Nick1787/Narwhal-Arduino-Code/Electrical/HarnessInstallationInstructions/IMGP3784_resize.JPG

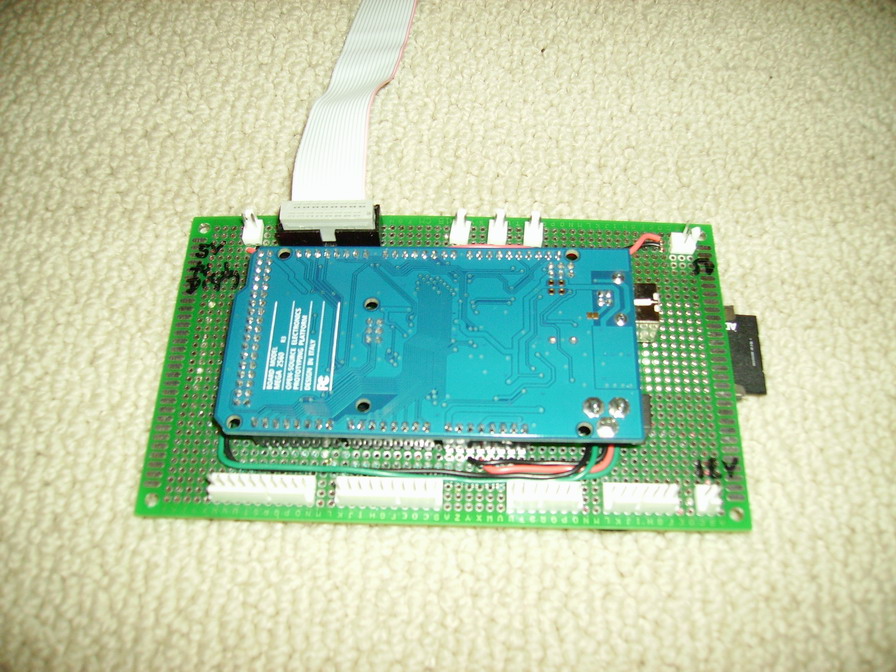
Electrical/HarnessInstallationInstructions/IMGP3784_resize.JPG
