Nick1787/Narwhal-Arduino-Code/Electrical/HarnessInstallationInstructions/IMGP3785_resize.JPG

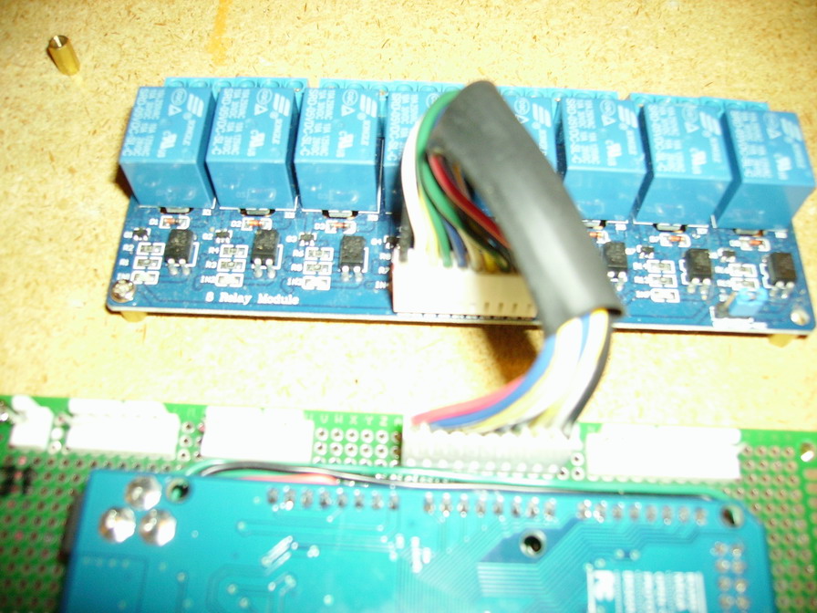
Electrical/HarnessInstallationInstructions/IMGP3785_resize.JPG
