Nick1787/Narwhal-Arduino-Code/Requirements/Process.xlsx

 | Acronym | Definition
 | HX | Heat Exchanger
 | HLT | Hot Liquor Tank
 | MLT | Mash/Lauter Tun
 | BK | Boil Kettle
 | HERMS | Heat Exchange Recirculating Mash System
 | HLTBP | Hot Liquor Tank Body Probe (RTD in body of HLT)
 | HLTOP | Hot Liquor Tank Outlet Probe (RTD located after HLT outlet valve)
 | MLTBP | Mash/Lauter Tun Body Probe (RTD in body of MLT)
 | MLTOP | Mash/Lauter Tun Outlet Probe (RTD located after MLT outlet valve)
 | BKBP | Brew Kettle Probe (RTD in body of BK)
 | BKOP | Brew Kettle Probe (RTD located after BK outlet valve)
No. | Process | Sub-process | Sub-sub-process | HLT Temperature Feedback, Setpoint | MLT Temperature Feedback, Setpoint | BK Temperature Feedback, Setpoint | Pump between HLT and MLT | Pump between MLT and BK | Timer | Overall Timer - Real time capture of session | Notes
1 | Clean
2 | Mash | Dough In | Add false bottom to MLT | OFF | OFF | OFF | OFF | OFF | OFF | ON
 |  |  | Add HX to HLT | OFF | OFF | OFF | OFF | OFF | OFF | ON | Need to make HX
 |  |  | Add water to HLT and MLT | OFF | OFF | OFF | OFF | OFF | OFF | ON
 |  |  | Heat HLT and MLT to dough in temperature | HLTBP, 104F | MLTBP, 104F | OFF | OFF | OFF | OFF | ON
 |  |  | Turn off HLT and MLT temperature control | OFF | OFF | OFF | OFF | OFF | OFF | ON
 |  |  | Add grain to MLT | OFF | OFF | OFF | OFF | OFF | OFF | ON
 |  |  | Add "float" to MLT | OFF | OFF | OFF | OFF | OFF | OFF | ON | Need to make float
 |  |  | Connect appropiate hoses | OFF | OFF | OFF | OFF | OFF | OFF | ON
 |  |  | Turn on pump/HERMs | OFF | OFF | OFF | ON | OFF | OFF | ON
 |  |  | Adjust pump valve for resonable flow that avoids channeling of grain bed in MLT | OFF | OFF | OFF | ON | OFF | OFF | ON
 |  | Acid Rest (optional) | Turn on HLT temperature control and heat to acid rest temperature | MLTOP, 95F | OFF | OFF | ON | OFF | OFF | ON
 |  |  | Hold acid rest temperature for timed duration | MLTOP, 95F | OFF | OFF | ON | OFF | ON, T1 | ON
 |  | Protein Rest (optional) | Turn on HLT temperature control if no acid rest or maintain HLT temperature control and heat to protein rest temperature | MLTOP, 122F | OFF | OFF | ON | OFF | OFF | ON
 |  |  | Hold protein rest temperature for timed duration | MLTOP, 122F | OFF | OFF | ON | OFF | ON, T2 | ON
 |  | Sacchrification Rest 1 | Turn on HLT temperature control if no acid/protein rest or Maintain HLT temperature control and heat to first sacchrification rest temperature | MLTOP, 140-158F | OFF | OFF | ON | OFF | OFF | ON
 |  |  | Hold first sacchrification rest temperature for timed duration | MLTOP, 140-158F | OFF | OFF | ON | OFF | ON, T3 | ON
 |  | Sacchrification Rest 2 (optional) | Maintain HLT temperature control and heat to second sacchrification rest temperature | MLTOP, 140-158F | OFF | OFF | ON | OFF | OFF | ON
 |  |  | Hold second sacchrification rest temperature for timed duration | MLTOP, 140-158F | OFF | OFF | ON | OFF | ON, T4 | ON
 |  | Sacchrification Rest 3 (optional) | Maintain HLT temperature control and heat to third sacchrification rest temperature | MLTOP, 140-158F | OFF | OFF | ON | OFF | OFF | ON
 |  |  | Hold third sacchrification rest temperature for timed duration | MLTOP, 140-158F | OFF | OFF | ON | OFF | ON, T5 | ON
 |  | Mash Out (optional) | Maintain HLT temperature control and heat to mash out temperature | MLTOP, 170F | OFF | OFF | ON | OFF | OFF | ON
 |  |  | Turn off MLT temperature control | OFF | OFF | OFF | ON | OFF | OFF | ON
 |  |  | Turn off pump/HERMs | OFF | OFF | OFF | OFF | OFF | OFF | ON
3 | Lauter | Vorlauf | N/A - not be necessary with HERMS | N/A | N/A | N/A | N/A | N/A | N/A | ON
 |  | Sparge | Move "float" from MLT to BK | OFF | OFF | OFF | OFF | OFF | OFF | ON | Make sure "float" will work in BK and MLK
 |  |  | Add sparge arm to MLT | OFF | OFF | OFF | OFF | OFF | OFF | ON | May need to modify sparge arm for pots
 |  |  | Connect HLT outlet to pump, pump outlet to HX in HLT, and outlet of HLT HX to sparge arm | OFF | OFF | OFF | OFF | OFF | OFF | ON
 |  |  | Connect MLT outlet to pump and pump outlet to float in BK | OFF | OFF | OFF | OFF | OFF | OFF | ON
 |  |  | Turn on pumps | OFF | OFF | OFF | ON | ON | OFF | ON
 |  |  | Turn on HLT temperature control and maintain mash out temperature | MLTOP, 170F | OFF | OFF | ON | ON | OFF | ON
 |  |  | Adjust pump valves to match sparge flow and slow enough for a sparge time of approximately 60 min | MLTOP, 170F | OFF | OFF | ON | ON | ON, T5 | ON
 |  |  | Turn on BK temperature control when wort covers BKBP | MLTOP, 170F | OFF | BKBP, 200F | ON | ON | ON, T5 | ON
 |  |  | Turn off MLT temperature control when sparge water is low | OFF | OFF | BKBP, 200F | ON | ON | ON, T5 | ON
 |  |  | Turn off pumps | OFF | OFF | BKBP, 200F | OFF | OFF | OFF | ON
 |  |  | Remove HX, sparge arm, hoses | OFF | OFF | BKBP, 200F | OFF | OFF | OFF | ON
4 | Boil | Begin Boil | Heat BK to rolling boil | OFF | OFF | BKBP, 20xF | OFF | OFF | OFF | ON
 |  |  | Take gravity reading and add water as necessary | OFF | OFF | BKBP, 20xF | OFF | OFF | OFF | ON
 |  |  | Hold rolling for timed duration | OFF | OFF | BKBP, 20xF | OFF | OFF | ON, T6 | ON
 |  | Boil Ingredient 1 Addition before Whirlpool/HX added to Kettle | Add 1st boil ingredient addition | OFF | OFF | BKBP, 20xF | OFF | OFF | ON, T7 | ON
 |  |  | Hold rolling for timed duration | OFF | OFF | BKBP, 20xF | OFF | OFF | ON, T7 | ON
 |  | Boil Ingredient 2 Addition before Whirlpool/HX added to Kettle | Add 1st boil ingredient addition | OFF | OFF | BKBP, 20xF | OFF | OFF | ON, T8 | ON
 |  |  | Hold rolling for timed duration | OFF | OFF | BKBP, 20xF | OFF | OFF | ON, T8 | ON
 |  | Boil Ingredient 3 Addition before Whirlpool/HX added to Kettle | Add 1st boil ingredient addition | OFF | OFF | BKBP, 20xF | OFF | OFF | ON, T9 | ON
 |  |  | Hold rolling for timed duration | OFF | OFF | BKBP, 20xF | OFF | OFF | ON, T9 | ON
 |  | Boil Ingredient N Addition before Whirlpool/HX added to Kettle | Add Nth boil ingredient addition | OFF | OFF | BKBP, 20xF | OFF | OFF | ON, T6+N | ON
 |  |  | Hold rolling for timed duration | OFF | OFF | BKBP, 20xF | OFF | OFF | ON, T6+N | ON
 |  | Final Boil Sequence | Take gravity reading and add water as necessary | OFF | OFF | BKBP, 20xF | OFF | OFF | ON, T6+N+1 | ON
 |  |  | Add whirlpool device to BK | OFF | OFF | BKBP, 20xF | OFF | OFF | ON, T6+N+1 | ON | Need to make whirlpool device (will work with one of the pumps)
 |  |  | Add HX to BK | OFF | OFF | BKBP, 20xF | OFF | OFF | ON, T6+N+1 | ON
 |  |  | Turn on whirlpool pump | OFF | OFF | BKBP, 20xF | OFF | ON | ON, T6+N+1 | ON
 |  |  | Resume boil | OFF | OFF | BKBP, 20xF | OFF | ON | ON, T6+N+1 | ON
 |  | Final Boil Sequence Ingredient N+1 Addition | Add N+1 final boil sequence ingredient addition | OFF | OFF | BKBP, 20xF | OFF | ON | ON, T6+N+2 | ON
 |  |  | Hold rolling for timed duration | OFF | OFF | BKBP, 20xF | OFF | ON | ON, T6+N+2 | ON
 |  | Final Boil Sequence Ingredient N+2 Addition | Add N+2 final boil sequence ingredient addition | OFF | OFF | BKBP, 20xF | OFF | ON | ON, T6+N+3 | ON
 |  |  | Hold rolling for timed duration | OFF | OFF | BKBP, 20xF | OFF | ON | ON, T6+N+3 | ON
 |  | Final Boil Sequence Ingredient N+M Addition | Add N+M final boil sequence ingredient addition | OFF | OFF | BKBP, 20xF | OFF | ON | ON, T6+N+1+M | ON
 |  |  | Hold rolling for timed duration | OFF | OFF | BKBP, 20xF | OFF | ON | ON, T6+N+1+M | ON
5 | Cool | add ice and water to heat excahnger - how are we doing the heat exchanger in the insturctions, ice bath or hose?
 |  | turn off burner/control
 |  | turn on pump for hx or hose
 |  | hold until temp desired
 |  | turn off hx pump
 |  | remove hx
 |  | allow whilpool to form
 |  | turn off whilrlpool pump
6 | Transfer to Fermentor | drain to carboy(s)
