Nick1787/Narwhal-Arduino-Code/Electrical/Schematic/Fritzing/RTDSensingCircuit_schem.png

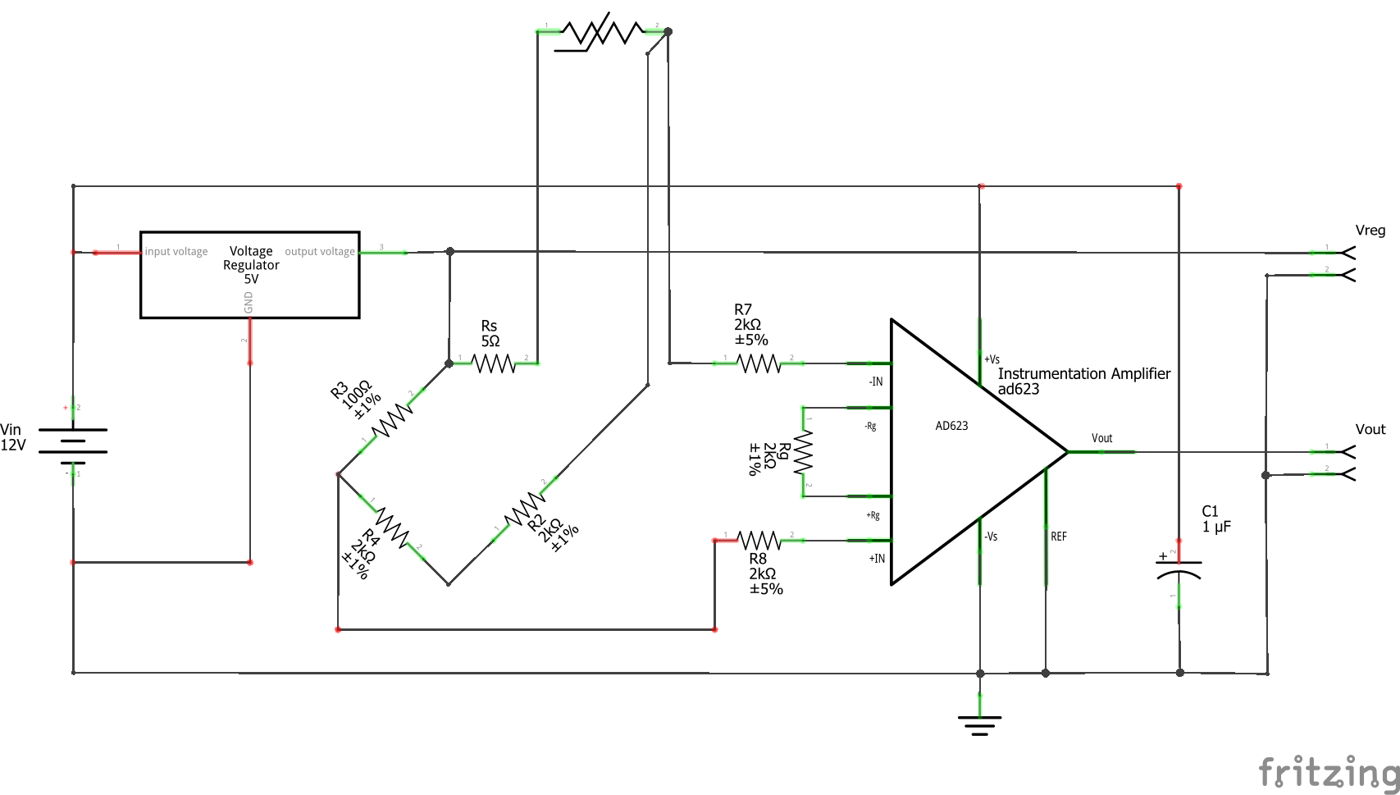
Electrical/Schematic/Fritzing/RTDSensingCircuit_schem.png
