Nick1787/Narwhal-Arduino-Code/Electrical/Schematic/Electrical Parts List.xlsx

Function | Description | Manufacturer / Series | Part # | Mouser Part # | Type | # Pins | # Connectors | Source | Link
Relay Boards | Relay Board - Board connection | KK® Interconnect System - Molex | 22-23-2101 | 538-22-23-2101 | Male | 10 | 2 | Mouser | http://www.mouser.com/ProductDetail/Molex/22-23-2101/
 | Relay Board - Cable Connectors | KK® Interconnect System - Molex | 22-01-2105 | 538-22-01-2105 | Female | 10 | 4 | Mouser | http://www.mouser.com/ProductDetail/Molex/22-01-2105/?qs=sGAEpiMZZMtVoztFdqDXO3DRJJT96OZO
RTD Circuit Boards | RTD Sensing - Board - Board Connection | KK® Interconnect System - Molex | 22-23-2071 | 538-22-23-2071 | Male | 7 | 4 | Mouser | http://www.mouser.com/ProductDetail/Molex/22-23-2071/
 | RTD Sensing - Board - Cable Connection | KK® Interconnect System - Molex | 22-01-2075 | 538-22-01-2075 | Female | 7 | 4 | Mouser | http://www.mouser.com/ProductDetail/Molex/22-01-2075/
 | RTD Sensing - RTD - Board Connection | KK® Interconnect System - Molex | 22-23-2031 | 538-22-23-2031 | Male | 3 | 8 | Mouser | http://www.mouser.com/ProductDetail/Molex/22-23-2031/
 | RTD Sensing - RTD - Cable Connection | KK® Interconnect System - Molex | 22-01-2035 | 538-22-01-2035 | Female | 3 | 8 | Mouser | http://www.mouser.com/ProductDetail/Molex/22-01-2035/
Wheatstone Bridge | Wheatstone Bridge - Rseries - 5 Ohm - 0p1 Pct | Vishay Resistor | CPF15R0000BEE14 | 71-CPF15R0000BEE14 | NA | NA | 10 | Mouser | http://www.mouser.com/ProductDetail/Vishay/CPF15R0000BEE14/
 | Wheatstone Bridge - R2/R3 - 2000 Ohm - 0p1 Pct | TE Connectivity | YR1B2K0CC | 279-YR1B2K0CC | NA | NA | 18 | Mouser | http://www.mouser.com/ProductDetail/TE-Connectivity/YR1B2K0CC/
 | Wheatstone Bridge - R4 - 100 Ohm - 0p1 Pct | TE Connectivity | YR1B100RCC | 279-YR1B100RCC | NA | NA | 9 | Mouser | http://www.mouser.com/ProductDetail/TE-Connectivity/YR1B100RCC/
 | Wheatstone Bridge - Inst. Amp | Analog Devices Inc. | AD623ANZ | 584-AD623ANZ | NA | NA | 9 | Mouser | http://www.mouser.com/ProductDetail/Analog-Devices-Inc/AD623ANZ/
 | Wheatstone Bridge - 4.85 Voltage Regulator | MIC2920A/29201/29202/29204 | MIC2920A-4.8WT | 998-MIC2920A-4.8WT | NA | NA | 3 | Mouser | http://www.mouser.com/ProductDetail/Micrel/MIC2920A-48WT/?qs=sGAEpiMZZMv7pcWEpiAU7BWpw0WMjQJh
Pilot Lights | Pilot Light TC - Board Connection | KK® Interconnect System - Molex | 22-23-2021 | 538-22-23-2021 | Male | 2 | 3 | Mouser | http://www.mouser.com/ProductDetail/Molex/22-23-2021/
 | Pilot Light TC - Cable Connection | KK® Interconnect System - Molex | 22-01-2025 | 538-22-01-2025 | Female | 2 | 3 | Mouser | http://www.mouser.com/ProductDetail/Molex/22-01-2025/
Power | Main Power - Main Board Connection | KK® Interconnect System - Molex | 22-23-2021 | 538-22-23-2021 | Male | 2 | 1 | Mouser | http://www.mouser.com/ProductDetail/Molex/22-23-2021/
 | Main Power - Main Cable Connection | KK® Interconnect System - Molex | 22-01-2025 | 538-22-01-2025 | Female | 2 | 1 | Mouser | http://www.mouser.com/ProductDetail/Molex/22-01-2025/
 | Main Power - Front Board Connection | KK® Interconnect System - Molex | 22-23-2021 | 538-22-23-2021 | Male | 2 | 1 | Mouser | http://www.mouser.com/ProductDetail/Molex/22-23-2021/
 | Main Power - Front Cable Connection | KK® Interconnect System - Molex | 22-01-2025 | 538-22-01-2025 | Female | 2 | 1 | Mouser | http://www.mouser.com/ProductDetail/Molex/22-01-2025/
Front-Panel Board | Pump Voltage - Front Board Connection | KK® Interconnect System - Molex | 22-23-2021 | 538-22-23-2021 | Male | 2 | 1 | Mouser | http://www.mouser.com/ProductDetail/Molex/22-23-2021/
 | Pump Voltage - Front Cable Connection | KK® Interconnect System - Molex | 22-01-2025 | 538-22-01-2025 | Female | 2 | 1 | Mouser | http://www.mouser.com/ProductDetail/Molex/22-01-2025/
 | Displays - Front Board Connection | KK® Interconnect System - Molex | 22-23-2041 | 538-22-23-2041 | Male | 4 | 4 | Mouser | http://www.mouser.com/ProductDetail/Molex/22-23-2041/
 | Displays - Cable Connections | KK® Interconnect System - Molex | 22-01-2045 | 538-22-01-2045 | Female | 4 | 8 | Mouser | http://www.mouser.com/ProductDetail/Molex/22-01-2045/
 | Encoders - Front Board Connection | KK® Interconnect System - Molex | 22-23-2051 | 538-22-23-2051 | Male | 5 | 4 | Mouser | http://www.mouser.com/ProductDetail/Molex/22-23-2051/
 | Encoders - Cable Connections | KK® Interconnect System - Molex | 22-01-2055 | 538-22-01-2055 | Female | 5 | 4 | Mouser | http://www.mouser.com/ProductDetail/Molex/22-01-2055/?qs=sGAEpiMZZMtVoztFdqDXO75tY90O5CVx
 | Front Board Connection - Ribbon Cable | 3M 18" - 16 Pin Ribbon Cable | 1M-1010-016-3365-018.0-00-AB-00-0 | 517-1M-1010-016-18 | Female | 2x8 | 1 | Mouser | http://www.mouser.com/ProductDetail/3M/1M-1010-016-3365-0180-00-AB-00-0/
 | IDC Board Connection Headers | TE Connectivity | 5103309-3 (http://www.mouser.com/ProductDetail/TE-Connectivity/5103309-3/) | 571-5103309-3 | Male | 2x8 | 1 | Mouser | http://www.mouser.com/ProductDetail/TE-Connectivity/5103309-3/
Notes:
2015-11-08 | Change length/part for ribbon cable from 12" to 18"
2015-11-08 | Added Mouser part numbers and Links
Varistors (MOV)
 | Varistors 130volts 2500A | TDK | B72210S0131K101 | 871-B72210S131K101 | NA | NA | 2 | 2 | 4 | $0.54 | $2.16 | $0.14 | $0.00 | $2.30 | Mouser | https://www.mouser.com/ProductDetail/EPCOS-TDK/B72210S0131K101
