Nick1787/Narwhal-Arduino-Code/Requirements/FirstFireMenusPseudoCode.xlsx

Sheet: Rev Log
Revision Log
Date | Notes
2015-10-27 | Initial Release
2015-11-08 | Added requirement for a software bypass mode for thermocouples

Sheet: OpeningMainScreen
20x4 Character Display
Opening Main Screen |  |  | 0 | 1 | 2 | 3 | 4 | 5 | 6 | 7 | 8 | 9 | 0 | 1 | 2 | 3 | 4 | 5 | 6 | 7 | 8 | 9
 | Line | 1
 |  | 2 |  |  |  |  | N | a | r | w | h | a | l |  | v | X | . | Y
 |  | 3 |  |  | E | s | t | a b |  | l | i | s | h | e | d |  | 2 | 0 | 1 | 5
 |  | 4
 | Notes:
 | (1) | Update version with Arduino code version |  |  |  |  |  |  |  |  |  |  |  |  |  |  |  |  |  |  |  |  | Variable | Description | Max # of Characters | Possible Text
 |  | X = major version number
 |  | Y = minor version number
 | (2) | Hold opening screen for 5 seconds, then goto
 |  | main menu screen

Sheet: MainMenuScreen
20x4 Character Display
Main Menu Screen |  |  | 0 | 1 | 2 | 3 | 4 | 5 | 6 | 7 | 8 | 9 | 0 | 1 | 2 | 3 | 4 | 5 | 6 | 7 | 8 | 9
 | Line | 1 | > | A | l | a | r | m |  | T | e | s | t
 |  | 2 |  | P | u | m | p |  | M | o | n | i | t | o | r
 |  | 3
 |  | 4
 | Notes:
 |  | (1) | Select with encoder |  |  |  |  |  |  |  |  |  |  |  |  |  |  |  |  |  |  |  | Variable | Description | Max # of Characters | Possible Text
 |  |  |  |  |  |  |  |  |  |  |  |  |  |  |  |  |  |  |  |  |  |  | > | Menu Selector | 1 | ">" Can be in front of and menu item

Sheet: MenuAlarmTestScreen
20x4 Character Display
Main Menu Alarm Test Screen |  |  | 0 | 1 | 2 | 3 | 4 | 5 | 6 | 7 | 8 | 9 | 0 | 1 | 2 | 3 | 4 | 5 | 6 | 7 | 8 | 9
 | Line | 1 | > | T | i | m | e | r |  | A | l | a | r | m |  |  |  |  | S | S | S
 |  | 2 |  | T | e | m | p |  | A | l | a | r | m |  |  |  |  |  | S | S | S
 |  | 3 |  | T | C |  | A | l | a | r | m |  |  |  |  |  |  |  | S | S | S
 |  | 4 |  | B | a | c | k
 | Notes:
 | (1) | Select with encoder |  |  |  |  |  |  |  |  |  |  |  |  |  |  |  |  |  |  |  |  | Variable | Description | Max # of Characters | Possible Text
 | (2) | Timer alarm (quiet buzzer): Toggle on/off with encoder |  |  |  |  |  |  |  |  |  |  |  |  |  |  |  |  |  |  |  |  | > | Menu Selector | 1 | ">" Can be in front of and menu item
 |  | Solenoid: 1 second on, 1 second off
 | (3) | Temperature alarm (quiet buzzer): Toggle on/off with encoder |  |  |  |  |  |  |  |  |  |  |  |  |  |  |  |  |  |  |  |  | SSS | Status | 3 | ON
 |  | Solenoid: 3 second on, 1 second off |  |  |  |  |  |  |  |  |  |  |  |  |  |  |  |  |  |  |  |  |  |  |  | OFF
 | (4) | Thermocouple (TC) alarm (loud buzzer): Toggle on/off with encoder
 |  | Solenoid: 0.5 second on, 0.5 second off

Sheet: MenuPumpMonitorScreen
20x4 Character Display
Main Menu Pump Monitor Screen |  |  | 0 | 1 | 2 | 3 | 4 | 5 | 6 | 7 | 8 | 9 | 0 | 1 | 2 | 3 | 4 | 5 | 6 | 7 | 8 | 9
 | Line | 1 | P | u | m | p | # | 1 |  | S | S | S
 |  | 2 | P | u | m | p | # | 2 |  | S | S | S
 |  | 3
 |  | 4 | > | B | a | c | k
 | Notes:
 | (1) | Select with encoder |  |  |  |  |  |  |  |  |  |  |  |  |  |  |  |  |  |  |  |  | Variable | Description | Max # of Characters | Possible Text
 | (2) | SSS is determined by pump switch input |  |  |  |  |  |  |  |  |  |  |  |  |  |  |  |  |  |  |  |  | > | Menu Selector | 1 | ">" Can be in front of and menu item
 |  |  |  |  |  |  |  |  |  |  |  |  |  |  |  |  |  |  |  |  |  |  | SSS | Status | 3 | ON
 |  |  |  |  |  |  |  |  |  |  |  |  |  |  |  |  |  |  |  |  |  |  |  |  |  | OFF

Sheet: OpeningKettleScreens
20x4 Character Display
Opening Kettle Screens |  |  | 0 | 1 | 2 | 3 | 4 | 5 | 6 | 7 | 8 | 9 | 0 | 1 | 2 | 3 | 4 | 5 | 6 | 7 | 8 | 9
 | Line | 1
 |  | 2 |  |  | K | K | K | K | K | K | K | K | K | K | K | K | K | K | K
 |  | 3
 |  | 4
 | Notes:
 | (1) | Hold opening screen for 5 seconds, then goto |  |  |  |  |  |  |  |  |  |  |  |  |  |  |  |  |  |  |  |  | Variable | Description | Max # of Characters | Possible Text
 |  | main kettle screen |  |  |  |  |  |  |  |  |  |  |  |  |  |  |  |  |  |  |  |  | K…K | Pot | 15 | Hot Liquor Tank
 |  |  |  |  |  |  |  |  |  |  |  |  |  |  |  |  |  |  |  |  |  |  |  |  |  | Mash/Lauter Tun
 |  |  |  |  |  |  |  |  |  |  |  |  |  |  |  |  |  |  |  |  |  |  |  |  |  | Boil Kettle

Sheet: MainKettleScreens
20x4 Character Display
Main Kettle Screens |  |  | 0 | 1 | 2 | 3 | 4 | 5 | 6 | 7 | 8 | 9 | 0 | 1 | 2 | 3 | 4 | 5 | 6 | 7 | 8 | 9
 | Line | 1 | > | M | o | n | i | t | o | r
 |  | 2 |  | S | e | t | t | i | n | g | s
 |  | 3 |  | D | i | a | g | n | o | s | t | i | c | s
 |  | 4
 | Notes:
 | (1) | Select with encoder |  |  |  |  |  |  |  |  |  |  |  |  |  |  |  |  |  |  |  |  | Variable | Description | Max # of Characters | Possible Text
 |  |  |  |  |  |  |  |  |  |  |  |  |  |  |  |  |  |  |  |  |  |  | > | Menu Selector | 1 | ">" Can be in front of and menu item

Sheet: KettleMonitor
20x4 Character Display
 |  |  | 0 | 1 | 2 | 3 | 4 | 5 | 6 | 7 | 8 | 9 | 0 | 1 | 2 | 3 | 4 | 5 | 6 | 7 | 8 | 9
Monitor Display for Each Kettle | Line | 1 | P | P | P | : | S | S | S | S | S | S | S | S | S | S | S | S | S | S | S | S
 |  | 2 | > | S | o | l | # | 1 | : | Z | Z | Z |  | S | o | l | # | 2 | : | Z | Z | Z
 |  | 3 | B | P | = | X | X | X | ° | F |  |  |  |  | O | P | = | X | X | X | ° | F
 |  | 4 |  | B | a | c | k
 | Notes:
 | (1) | Select with encoder (move cursor left to right, then down) |  |  |  |  |  |  |  |  |  |  |  |  |  |  |  |  |  |  |  |  | Variable | Description | Max # of Characters | Possible Text
 | (2) | Press encoder to toggle solenoid on/off |  |  |  |  |  |  |  |  |  |  |  |  |  |  |  |  |  |  |  |  | > | Menu Selector | 1 | ">" Can be in front of and menu item
 | (3) | BP - Kettle body probe temperature
 | (4) | OP - Kettle outlet probe temperature |  |  |  |  |  |  |  |  |  |  |  |  |  |  |  |  |  |  |  |  | P…P | Pot | 3 | HLT
 | (5) | Code shall have a bypass mode to disable thermocouple |  |  |  |  |  |  |  |  |  |  |  |  |  |  |  |  |  |  |  |  |  |  |  | MLT
 |  | interlock on activating Solenoid #1 & #2 |  |  |  |  |  |  |  |  |  |  |  |  |  |  |  |  |  |  |  |  |  |  |  | BK
 | (6) | Default code shall have thermocouple bypass mode |  |  |  |  |  |  |  |  |  |  |  |  |  |  |  |  |  |  |  |  | S…S | Status | 16 | Pilot OFF
 |  | disabled |  |  |  |  |  |  |  |  |  |  |  |  |  |  |  |  |  |  |  |  |  |  |  | Pilot Lit, Ready
 |  |  |  |  |  |  |  |  |  |  |  |  |  |  |  |  |  |  |  |  |  |  |  |  |  | Sol #1 Active
 |  |  |  |  |  |  |  |  |  |  |  |  |  |  |  |  |  |  |  |  |  |  |  |  |  | Sol #2 Active
 |  |  |  |  |  |  |  |  |  |  |  |  |  |  |  |  |  |  |  |  |  |  |  |  |  | Sol #1/#2 Active
 |  |  |  |  |  |  |  |  |  |  |  |  |  |  |  |  |  |  |  |  |  |  |  |  |  | ~~Fault~~
 |  |  |  |  |  |  |  |  |  |  |  |  |  |  |  |  |  |  |  |  |  |  | Z…Z | ON/OFF | 3 | ON
 |  |  |  |  |  |  |  |  |  |  |  |  |  |  |  |  |  |  |  |  |  |  |  |  |  | OFF

Sheet: KettleSettings
20x4 Character Display
Settings for Each Kettle |  |  | 0 | 1 | 2 | 3 | 4 | 5 | 6 | 7 | 8 | 9 | 0 | 1 | 2 | 3 | 4 | 5 | 6 | 7 | 8 | 9
 | Line | 1 | K | e | t | t | l | e |  | M | o | d | e
 |  | 2
 |  | 3
 |  | 4 |  | B | a | c | k
 | Notes:
 | (1) | Select with encoder (move cursor left to right, then down) |  |  |  |  |  |  |  |  |  |  |  |  |  |  |  |  |  |  |  |  | Variable | Description | Max # of Characters | Possible Text
 |  |  |  |  |  |  |  |  |  |  |  |  |  |  |  |  |  |  |  |  |  |  | > | Menu Selector | 1 | ">" Can be in front of and menu item
 |  | Placeholder

Sheet: KettleDiagnositc
20x4 Character Display
Dianostic Screen for Each Kettle |  |  | 0 | 1 | 2 | 3 | 4 | 5 | 6 | 7 | 8 | 9 | 0 | 1 | 2 | 3 | 4 | 5 | 6 | 7 | 8 | 9
 | Line | 1
 |  | 2
 |  | 3
 |  | 4 |  | B | a | c | k
 | Notes:
 |  | WORKING |  |  |  |  |  |  |  |  |  |  |  |  |  |  |  |  |  |  |  |  | Variable | Description | Max # of Characters | Possible Text
 |  |  |  |  |  |  |  |  |  |  |  |  |  |  |  |  |  |  |  |  |  |  | > | Menu Selector | 1 | ">" Can be in front of and menu item
 |  | Diagnostic screen - Arduino output of test points

Sheet: Reference
20x4 Character Display
 |  |  | 0 | 1 | 2 | 3 | 4 | 5 | 6 | 7 | 8 | 9 | 0 | 1 | 2 | 3 | 4 | 5 | 6 | 7 | 8 | 9
Opening Screen | Line | 1
 |  | 2
 |  | 3
 |  | 4
Timers | Line | 1
 |  | 2 | >
 |  | 3
 |  | 4
 |  |  | Menu Selection
