Nick1787/Narwhal-Arduino-Code/Requirements/Panel.xlsx

Sheet: Rev Log
Revision Log
Date | Notes
2015-08-31 | Initial Release

Sheet: Panel
Description | Voltage | Switch | Indicator | Positions | Display | Encoder/ Button | Switch Only | Indicator Only | Alarm Only | Notes
Main Power Switch | 120V | 2-way (1 set of contacts) | N/A | ON/OFF |  |  | 1 |  |  | Power to Pump Power switches & 12V Supply Switch
E-Stop Switch | 120V | 2-way (2 sets of contacts) | N/A | ON/OFF |  |  | 1 |  |  | Power to Pump Power switches & 12V Supply Switch
12V Power Switch | 120V | 2-way (1 set of contacts) | N/A | ON/OFF |  |  | 1 |  |  | Power to 12 volt power supply (Aurduino) & Solenoids
120V Power Switch | 120V | 2-way (1 set of contacts) | N/A | ON/OFF |  |  | 1 |  |  | Power to pump switches
Master Alarm | 12V | N/A | N/A | N/A |  |  |  |  | 1
Timer Alarm | 12V | N/A | N/A | N/A |  |  |  |  | 1
Main Menu/Timer Display | 12V | N/A | N/A | N/A | 1
Main Menu/Timer Encoder/Button | N/A | N/A | N/A | N/A |  | 1
Burner #1 Display | 12V | N/A | N/A | N/A | 1
Burner #1 Encoder/Button | N/A | N/A | N/A | N/A |  | 1
Burner #2 Display | 12V | N/A | N/A | N/A | 1
Burner #2 Encoder/Button | N/A | N/A | N/A | N/A |  | 1
Burner #3 Display | 12V | N/A | N/A | N/A | 1
Burner #3 Encoder/Button | N/A | N/A | N/A | N/A |  | 1
Burner #1, Solenoid #1 Indicator | 12V | N/A | Light if ON | N/A |  |  |  | 1
Burner #1, Solenoid #2 Indicator | 12V | N/A | Light if ON | N/A |  |  |  | 1
Burner #2, Solenoid #1 Indicator | 12V | N/A | Light if ON | N/A |  |  |  | 1
Burner #2, Solenoid #2 Indicator | 12V | N/A | Light if ON | N/A |  |  |  | 1
Burner #3, Solenoid #1 Indicator | 12V | N/A | Light if ON | N/A |  |  |  | 1
Burner #3, Solenoid #2 Indicator | 12V | N/A | Light if ON | N/A |  |  |  | 1
Burner #1, Pilot Indicator | 12V | N/A | Light if ON | N/A |  |  |  | 1 |  | Sound alarm when not lit and burner is desired
Burner #2, Pilot Indicator | 12V | N/A | Light if ON | N/A |  |  |  | 1 |  | Sound alarm when not lit and burner is desired
Burner #3, Pilot Indicator | 12V | N/A | Light if ON | N/A |  |  |  | 1 |  | Sound alarm when not lit and burner is desired
Pump #1, ON/OFF | 120V | 2-way (2 sets of contacts) | N/A | ON/OFF |  |  | 1 |  |  | 2nd set of contacts - use for Aurduino pump monitor/data logger
Pump #2, ON/OFF | 120V | 2-way (2 sets of contacts) | N/A | ON/OFF |  |  | 1 |  |  | 2nd set of contacts - use for Aurduino pump monitor/data logger
 |  |  |  | Totals: | 4 | 4 | 6 | 9 | 2
Note 1: Selection of burner control via menus if Arduino active, unless manual switch is active & Arduino power is ON
Note 2: Manual mode is lighting pilots & using manual valve for burner, no power to Arduino needed (can't monitor pilots if Arduino power is OFF)
