Nick1787/Narwhal-Arduino-Code/Requirements/MenusPseudoCode.xlsx

Sheet: Rev Log
Revision Log
Date | Notes
2015-08-31 | Initial Release
2015-08-31 | Test, change
2015-09-01 | Menu updates
2015-09-02 | Added menus
2015-09-09 | Added more kettle menus
2015-09-16 | Added more kettle menus
2015-10-28 | Added notes
2015-11-08 | Added requirement for a software bypass mode for thermocouples

Sheet: OpeningMainScreen
20x4 Character Display
Opening Main Screen |  |  | 0 | 1 | 2 | 3 | 4 | 5 | 6 | 7 | 8 | 9 | 0 | 1 | 2 | 3 | 4 | 5 | 6 | 7 | 8 | 9
 | Line | 1
 |  | 2 |  |  |  |  | N | a | r | w | h | a | l |  | v | X | . | Y
 |  | 3 |  |  | E | s | t | a b |  | l | i | s | h | e | d |  | 2 | 0 | 1 | 5
 |  | 4
 | Notes:
 | (1) | Update version with Arduino code version |  |  |  |  |  |  |  |  |  |  |  |  |  |  |  |  |  |  |  |  | Variable | Description | Max # of Characters | Possible Text
 |  | X = major version number
 |  | Y = minor version number
 | (2) | Hold opening screen for 5 seconds, then goto
 |  | main menu screen

Sheet: MainMenuScreen
20x4 Character Display
Main Menu Screen |  |  | 0 | 1 | 2 | 3 | 4 | 5 | 6 | 7 | 8 | 9 | 0 | 1 | 2 | 3 | 4 | 5 | 6 | 7 | 8 | 9
 | Line | 1
 |  | 2
 |  | 3
 |  | 4
 | Notes:
 |  | Need menu for |  |  |  |  |  |  |  |  |  |  |  |  |  |  |  |  |  |  |  |  | Variable | Description | Max # of Characters | Possible Text
 |  | Calibrate RTDs
 |  | Diagnostic screen - Arduino output of test points
 |  | Record option
 |  | Load program profile
 |  | Program profile option
 |  | Settings (timer alarm, reached temp alarm, and thermocouple alarm on/off)

Sheet: OpeningKettleScreens
20x4 Character Display
Opening Kettle Screens |  |  | 0 | 1 | 2 | 3 | 4 | 5 | 6 | 7 | 8 | 9 | 0 | 1 | 2 | 3 | 4 | 5 | 6 | 7 | 8 | 9
 | Line | 1
 |  | 2 |  |  | K | K | K | K | K | K | K | K | K | K | K | K | K | K | K
 |  | 3
 |  | 4
 | Notes:
 | (1) | Hold opening screen for 5 seconds, then goto |  |  |  |  |  |  |  |  |  |  |  |  |  |  |  |  |  |  |  |  | Variable | Description | Max # of Characters | Possible Text
 |  | main kettle screen |  |  |  |  |  |  |  |  |  |  |  |  |  |  |  |  |  |  |  |  | K…K | Pot | 15 | Hot Liquor Tank
 |  |  |  |  |  |  |  |  |  |  |  |  |  |  |  |  |  |  |  |  |  |  |  |  |  | Mash/Lauter Tun
 |  |  |  |  |  |  |  |  |  |  |  |  |  |  |  |  |  |  |  |  |  |  |  |  |  | Boil Kettle

Sheet: MainKettleScreens
20x4 Character Display
Main Kettle Screens |  |  | 0 | 1 | 2 | 3 | 4 | 5 | 6 | 7 | 8 | 9 | 0 | 1 | 2 | 3 | 4 | 5 | 6 | 7 | 8 | 9
 | Line | 1 | > | M | o | n | i | t | o | r
 |  | 2 |  | S | e | t | t | i | n | g | s
 |  | 3 |  | D | i | a | g | n | o | s | t | i | c | s
 |  | 4
 | Notes:
 | (1) | Select with encoder |  |  |  |  |  |  |  |  |  |  |  |  |  |  |  |  |  |  |  |  | Variable | Description | Max # of Characters | Possible Text
 |  |  |  |  |  |  |  |  |  |  |  |  |  |  |  |  |  |  |  |  |  |  | > | Menu Selector | 1 | ">" Can be in front of and menu item

Sheet: KettleMonitor
20x4 Character Display
 |  |  | 0 | 1 | 2 | 3 | 4 | 5 | 6 | 7 | 8 | 9 | 0 | 1 | 2 | 3 | 4 | 5 | 6 | 7 | 8 | 9
Monitor Display for Each Kettle | Line | 1 | P | P | P | : | S | S | S | S | S | S | S | S | S | S | S | S | S | S | S | S
 |  | 2 | M | M | M | M | M | M | M | M | M | M |  | D | m | d | = | X | X | X | ° | F
 |  | 3 | B | P | = | X | X | X | ° | F |  | F | F | F | F | F | = | X | X | X | ° | F
 |  | 4 | O | P | = | X | X | X | ° | F |  | E | r | r | o | r | = | X | X | X | ° | F
 | Notes:
 |  | Think about scrolling down to get a "back" selection |  |  |  |  |  |  |  |  |  |  |  |  |  |  |  |  |  |  |  |  | Variable | Description | Max # of Characters | Possible Text
 |  | Also think about scrolling down to change feedback sensor |  |  |  |  |  |  |  |  |  |  |  |  |  |  |  |  |  |  |  |  | P…P | Pot | 3 | HLT
 |  | and other settings - maybe each monitor will select |  |  |  |  |  |  |  |  |  |  |  |  |  |  |  |  |  |  |  |  |  |  |  | MLT
 |  | each mode and what to display/set |  |  |  |  |  |  |  |  |  |  |  |  |  |  |  |  |  |  |  |  |  |  |  | BK
 |  |  |  |  |  |  |  |  |  |  |  |  |  |  |  |  |  |  |  |  |  |  | S…S | Status | 16 | Pilot OFF
 | (X) | Code shall have a bypass mode to disable thermocouple |  |  |  |  |  |  |  |  |  |  |  |  |  |  |  |  |  |  |  |  |  |  |  | Pilot Lit, Ready
 |  | interlock on activating Solenoid #1 & #2 |  |  |  |  |  |  |  |  |  |  |  |  |  |  |  |  |  |  |  |  |  |  |  | Sol #1 Active
 | (X) | Default code shall have thermocouple bypass mode |  |  |  |  |  |  |  |  |  |  |  |  |  |  |  |  |  |  |  |  |  |  |  | Sol #2 Active
 |  | disabled |  |  |  |  |  |  |  |  |  |  |  |  |  |  |  |  |  |  |  |  |  |  |  | Sol #1/#2 Active
 |  |  |  |  |  |  |  |  |  |  |  |  |  |  |  |  |  |  |  |  |  |  |  |  |  | Fault
 |  |  |  |  |  |  |  |  |  |  |  |  |  |  |  |  |  |  |  |  |  |  | M…M | Mode | 10 | Manual
 |  |  |  |  |  |  |  |  |  |  |  |  |  |  |  |  |  |  |  |  |  |  |  |  |  | PWM Mode
 |  |  |  |  |  |  |  |  |  |  |  |  |  |  |  |  |  |  |  |  |  |  |  |  |  | Semi-Auto
 |  |  |  |  |  |  |  |  |  |  |  |  |  |  |  |  |  |  |  |  |  |  |  |  |  | Full-Auto
 |  |  |  |  |  |  |  |  |  |  |  |  |  |  |  |  |  |  |  |  |  |  | F…F | Feedback | 5 | HLTBP
 |  |  |  |  |  |  |  |  |  |  |  |  |  |  |  |  |  |  |  |  |  |  |  |  |  | HLTOP
 |  |  |  |  |  |  |  |  |  |  |  |  |  |  |  |  |  |  |  |  |  |  |  |  |  | MLTBP
 |  |  |  |  |  |  |  |  |  |  |  |  |  |  |  |  |  |  |  |  |  |  |  |  |  | MLTOP
 |  |  |  |  |  |  |  |  |  |  |  |  |  |  |  |  |  |  |  |  |  |  |  |  |  | BKBP
 |  |  |  |  |  |  |  |  |  |  |  |  |  |  |  |  |  |  |  |  |  |  |  |  |  | BKOP

Sheet: KettleSettings
20x4 Character Display
Settings for Each Kettle |  |  | 0 | 1 | 2 | 3 | 4 | 5 | 6 | 7 | 8 | 9 | 0 | 1 | 2 | 3 | 4 | 5 | 6 | 7 | 8 | 9
 | Line | 1 | K | e | t | t | l | e |  | M | o | d | e
 |  | 2 |  | M | a | n | u | a | l |  |  |  | > | S | e | m | i | - | A | u | t | o
 |  | 3 |  | P | W | M |  | M | o | d | e |  |  | F | u | l | l | - | A | u | t | o
 |  | 4 |  | B | a | c | k
 | Notes:
 | (1) | Select with encoder (move cursor left to right, then down) |  |  |  |  |  |  |  |  |  |  |  |  |  |  |  |  |  |  |  |  | Variable | Description | Max # of Characters | Possible Text
 |  |  |  |  |  |  |  |  |  |  |  |  |  |  |  |  |  |  |  |  |  |  | > | Menu Selector | 1 | ">" Can be in front of and menu item

Sheet: KettleSetManual
20x4 Character Display
Manual Setting Screen for Each Kettle |  |  | 0 | 1 | 2 | 3 | 4 | 5 | 6 | 7 | 8 | 9 | 0 | 1 | 2 | 3 | 4 | 5 | 6 | 7 | 8 | 9
 | Line | 1 | F | u | l | l |  | M | a | n | u | a | l |  | M | o | d | e
 |  | 2 | S | o | l | # | 1 | : | S | S | S |  | S | o | l | # | 2 | : | S | S | S
 |  | 3 |  | > | O | N |  |  | O | F | F |  |  |  | O | N |  |  | O | F | F
 |  | 4 |  | B | a | c | k
 | Notes:
 | (1) | Select with encoder (move cursor left to right, then down) |  |  |  |  |  |  |  |  |  |  |  |  |  |  |  |  |  |  |  |  | Variable | Description | Max # of Characters | Possible Text
 | (2) | Left side ON/OFF for Solenoid #1 |  |  |  |  |  |  |  |  |  |  |  |  |  |  |  |  |  |  |  |  | > | Menu Selector | 1 | ">" Can be in front of and menu item
 | (3) | Right side ON/OFF for Solenoid #2
 |  |  |  |  |  |  |  |  |  |  |  |  |  |  |  |  |  |  |  |  |  |  | SSS | Status | 3 | ON
 |  |  |  |  |  |  |  |  |  |  |  |  |  |  |  |  |  |  |  |  |  |  |  |  |  | OFF

Sheet: KettleSetPWM
20x4 Character Display
PWM Mode Setting Screen for Each Kettle |  |  | 0 | 1 | 2 | 3 | 4 | 5 | 6 | 7 | 8 | 9 | 0 | 1 | 2 | 3 | 4 | 5 | 6 | 7 | 8 | 9
 | Line | 1
 |  | 2
 |  | 3
 |  | 4 |  | B | a | c | k
 | Notes:
 |  | WORKING |  |  |  |  |  |  |  |  |  |  |  |  |  |  |  |  |  |  |  |  | Variable | Description | Max # of Characters | Possible Text
 |  |  |  |  |  |  |  |  |  |  |  |  |  |  |  |  |  |  |  |  |  |  | > | Menu Selector | 1 | ">" Can be in front of and menu item
 |  | Specify duty cycle
 |  | Specify cycle width
 |  | Specify burner intensity, low/med/high

Sheet: KettleSetSemi
20x4 Character Display
Semi-Auto Setting Screen for Each Kettle |  |  | 0 | 1 | 2 | 3 | 4 | 5 | 6 | 7 | 8 | 9 | 0 | 1 | 2 | 3 | 4 | 5 | 6 | 7 | 8 | 9
 | Line | 1
 |  | 2
 |  | 3
 |  | 4 |  | B | a | c | k
 | Notes:
 |  | WORKING |  |  |  |  |  |  |  |  |  |  |  |  |  |  |  |  |  |  |  |  | Variable | Description | Max # of Characters | Possible Text
 |  |  |  |  |  |  |  |  |  |  |  |  |  |  |  |  |  |  |  |  |  |  | > | Menu Selector | 1 | ">" Can be in front of and menu item
 |  | Specify temperature
 |  | Specify feedback source
 |  | Specify burner intensity, low/med/high

Sheet: KettleSetFull
20x4 Character Display
Full-Auto Setting Screen for Each Kettle |  |  | 0 | 1 | 2 | 3 | 4 | 5 | 6 | 7 | 8 | 9 | 0 | 1 | 2 | 3 | 4 | 5 | 6 | 7 | 8 | 9
 | Line | 1
 |  | 2
 |  | 3
 |  | 4 |  | B | a | c | k
 | Notes:
 |  | WORKING |  |  |  |  |  |  |  |  |  |  |  |  |  |  |  |  |  |  |  |  | Variable | Description | Max # of Characters | Possible Text
 |  |  |  |  |  |  |  |  |  |  |  |  |  |  |  |  |  |  |  |  |  |  | > | Menu Selector | 1 | ">" Can be in front of and menu item
 |  | Specify temperature
 |  | Specify feedback source
 |  | Specify burner intensity, low/med/high, based on temperature error
 |  |  | error > xx deg high
 |  |  | xx<error<xx deg medium
 |  |  | error <xx deg low

Sheet: KettleDiagnositc
20x4 Character Display
Dianostic Screen for Each Kettle |  |  | 0 | 1 | 2 | 3 | 4 | 5 | 6 | 7 | 8 | 9 | 0 | 1 | 2 | 3 | 4 | 5 | 6 | 7 | 8 | 9
 | Line | 1
 |  | 2
 |  | 3
 |  | 4 |  | B | a | c | k
 | Notes:
 |  | WORKING |  |  |  |  |  |  |  |  |  |  |  |  |  |  |  |  |  |  |  |  | Variable | Description | Max # of Characters | Possible Text
 |  |  |  |  |  |  |  |  |  |  |  |  |  |  |  |  |  |  |  |  |  |  | > | Menu Selector | 1 | ">" Can be in front of and menu item
 |  | Diagnostic screen - Arduino output of test points

Sheet: Reference
20x4 Character Display
 |  |  | 0 | 1 | 2 | 3 | 4 | 5 | 6 | 7 | 8 | 9 | 0 | 1 | 2 | 3 | 4 | 5 | 6 | 7 | 8 | 9
Opening Screen | Line | 1
 |  | 2
 |  | 3
 |  | 4
Timers | Line | 1
 |  | 2 | >
 |  | 3
 |  | 4
 |  |  | Menu Selection
