Nick1787/Narwhal-Arduino-Code/Electrical/HarnessInstallationInstructions/HarnessInstallationInstructions_v2.pptx

## Harness Installation Instructions

Version 2
October 30, 2016

## Version Log

Version | Date | Description
1.0 | 10/2/2016 | Initial version
2.0 | 10/30/2016 | Fixed order of thermocouple hookup on Arduino Mega Shield page Swapped order of RTD board cable 1 & 2 on Arduino Mega Shield page

## RTD Boards

Top of cabinet

HLT BP: 3 wire RTD

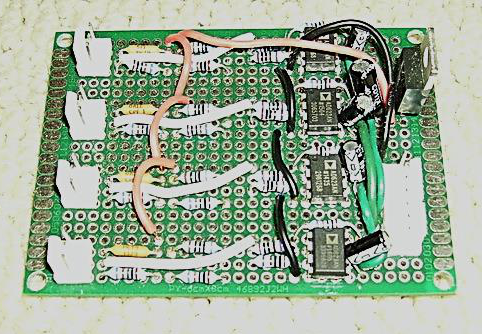
[picture p4: figure]

HLT OP: 3 wire RTD

MLT BP: 3 wire RTD

Top RTD
Board Cable 1

MLT OP: 3 wire RTD

Top Board

BK BP: 3 wire RTD

BK OP: 3 wire RTD

SPARE: 3 wire RTD

Bottom RTD
Board Cable 2

Bottom of cabinet

SPARE: 3 wire RTD

Bottom Board

## Front Panel Connection Board

Main
#1

HLT
#2

HLT
#2

HLT
#2

Displays (4 pin)

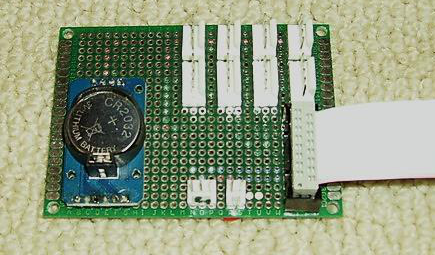
[picture p5: figure]

Side closest to
cabinet hinge

Encoders (5 pin)

Ribbon cable to
Arduino Mega Shield

Red stripe

5V from
Front Panel

Pump
Monitor

## Arduino Mega Shield

5V to
Front Panel

Ribbon cable to
Arduino Mega Shield

Red
stripe

BK
TC

MLT
TC

HLT
TC

5V from Step Down
Voltage Converter

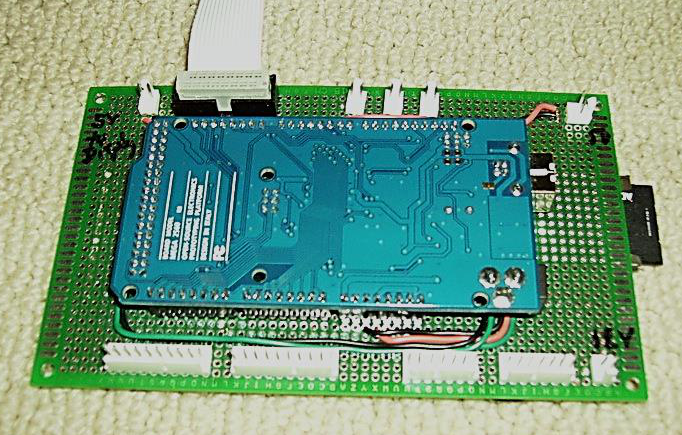
[picture p6: figure]

Black Wire

Bottom Relay
Board Cable 2

Top Relay
Board Cable 1

Bottom RTD
Board Cable 2

Top RTD
Board Cable 1

12V from Linear
Power Supply

## Arduino Shield/Relay Board

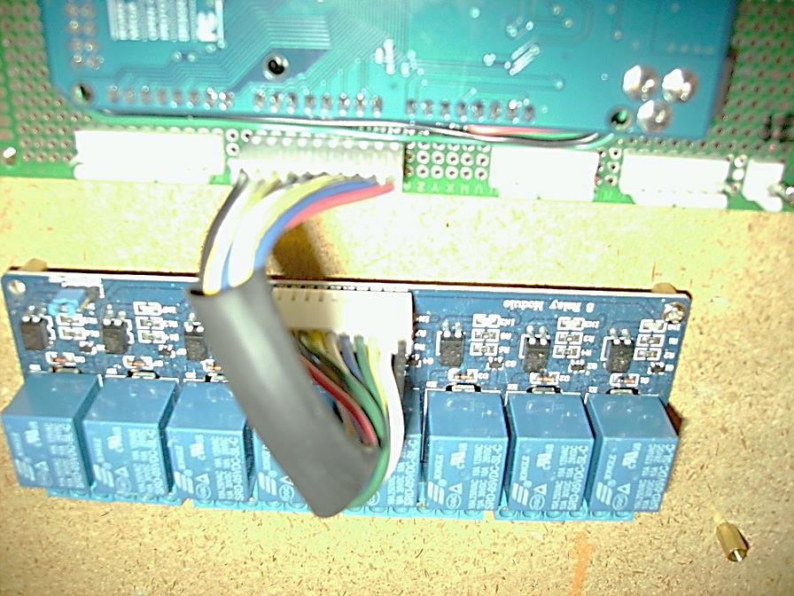
[picture p7: figure]

Black Wire

WARNING:
Relay Board
Connection
is Not Keyed

Black Wire

## Arduino Shield/Relay Board

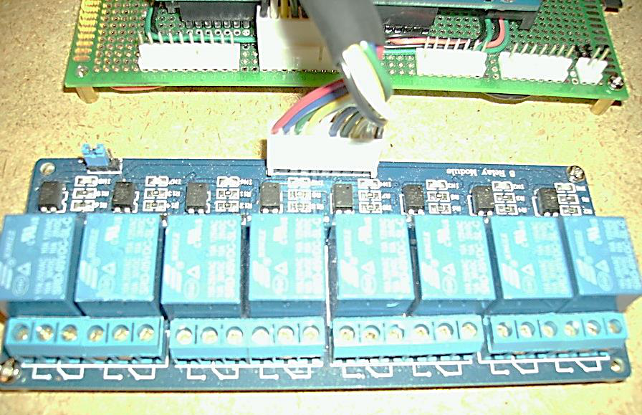
[picture p8: figure]

Black Wire

Black Wire

WARNING:
Relay Board
Connection
is Not Keyed
