Nick1787/Narwhal-Arduino-Code/Electrical/HarnessInstallationInstructions/IMGP3782_resize.JPG

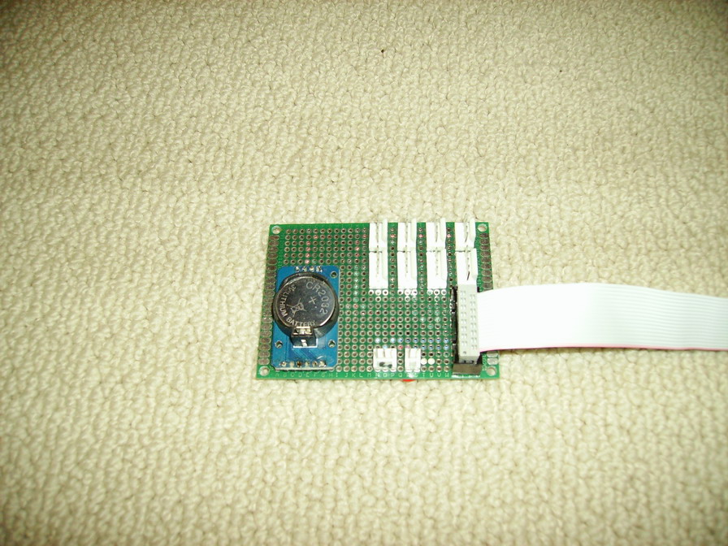
Electrical/HarnessInstallationInstructions/IMGP3782_resize.JPG
