Nick1787/Narwhal-Arduino-Code/Electrical/HarnessInstallationInstructions/IMGP3783_resize.JPG

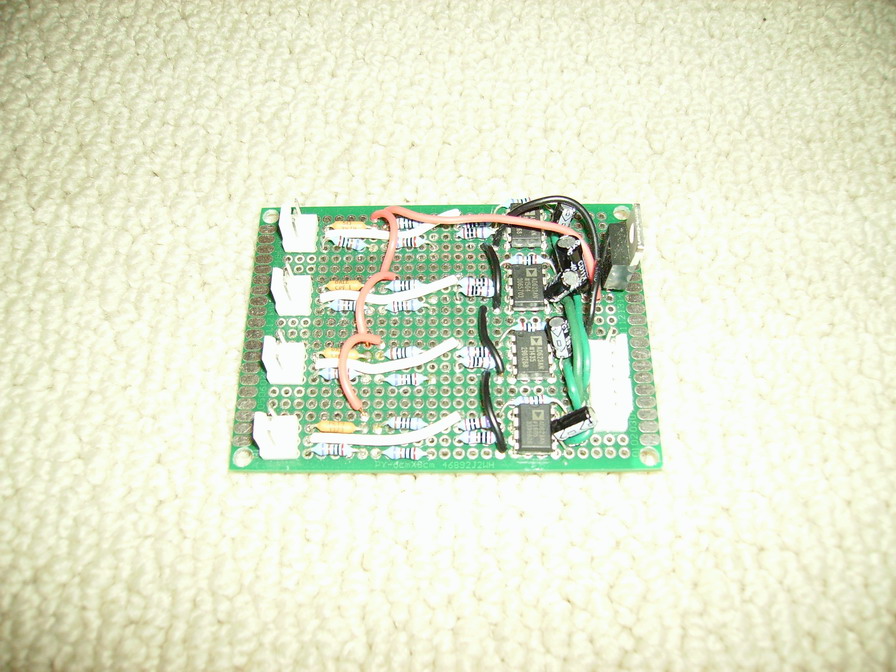
Electrical/HarnessInstallationInstructions/IMGP3783_resize.JPG
