Nick1787/Narwhal-Arduino-Code/Electrical/HarnessInstallationInstructions/IMGP3786_resize.JPG

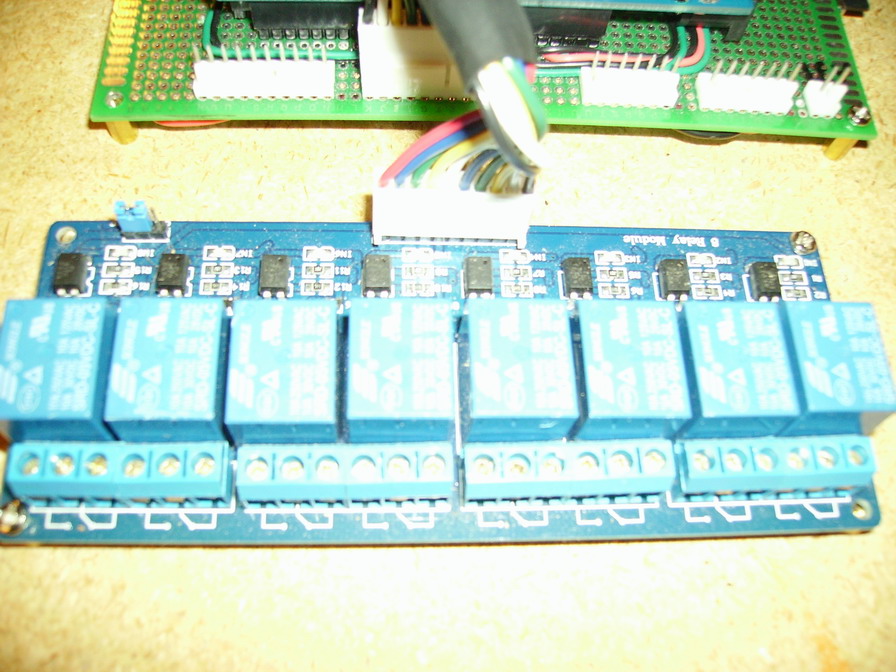
Electrical/HarnessInstallationInstructions/IMGP3786_resize.JPG
