Nick1787/Narwhal-Arduino-Code/Electrical/HarnessInstallationInstructions/HarnessInstallationInstructions_v2.pdf

# Harness Installation Instructions

# Version 2 October 30, 2016

# Version Log

Version | Date | Description
1.0 | 10/2/2016 | 1. Initial version
2.0 | 10/30/2016 | 1. Fixed order of thermocouple hookup on Arduino Mega Shield page 2. Swapped order of RTD board cable 1 & 2 on Arduino Mega Shield page

# RTD Boards

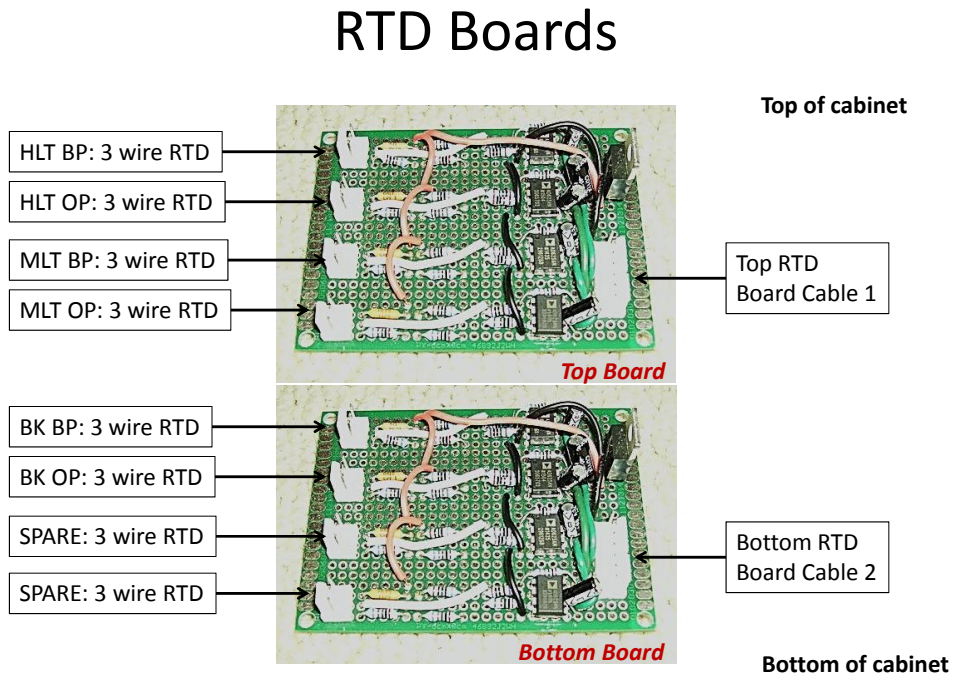
[picture p12: page 3]
Top RTD Board Cable 1; Bottom RTD Board Cable 2; Top Board; Bottom Board

Top of cabinet

HLT BP: 3 wire RTD
HLT OP: 3 wire RTD
MLT BP: 3 wire RTD
MLT OP: 3 wire RTD

BK BP: 3 wire RTD
BK OP: 3 wire RTD
SPARE: 3 wire RTD

Bottom of cabinet

# Front Panel Connection Board

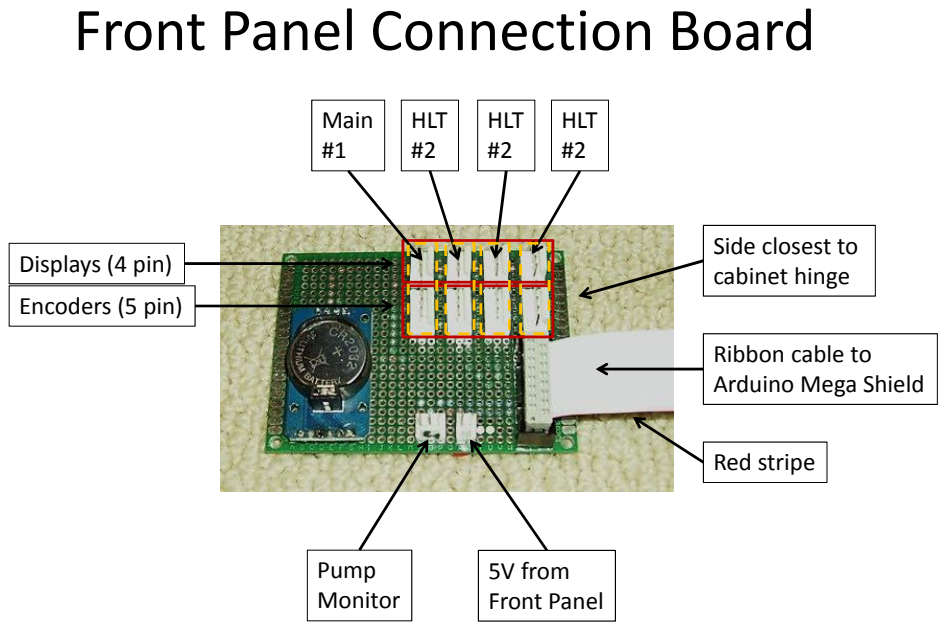
[picture p13: page 4]
Red stripe; 5V from Front Panel; Pump Monitor; Encoders (5 pin); Displays (4 pin); Main #1; HLT #2

Side closest to
cabinet hinge

Ribbon cable to
Arduino Mega Shield

# Arduino Mega Shield

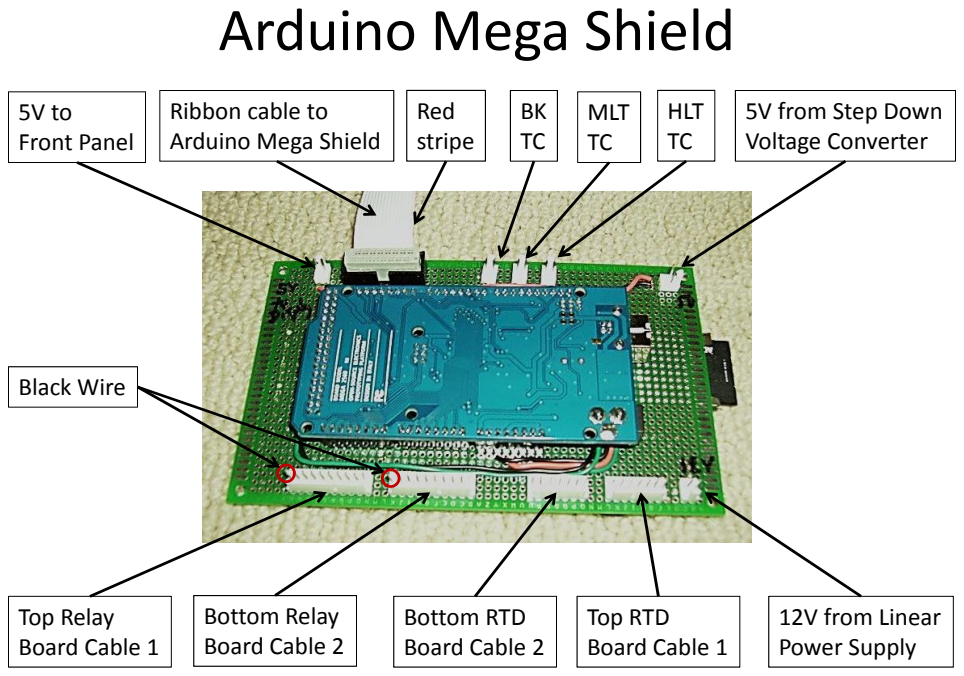
[picture p14: page 5]
Bottom RTD Board Cable 2; Top RTD Board Cable 1; Red stripe; MLT TC; 5V to Front Panel; 12V from Linear Power Supply; Top Relay Board Cable 1; Bottom Relay Board Cable 2; Black Wire

Ribbon cable to
Arduino Mega Shield

HLT
5V from Step Down
Voltage Converter

# Arduino Shield/Relay Board

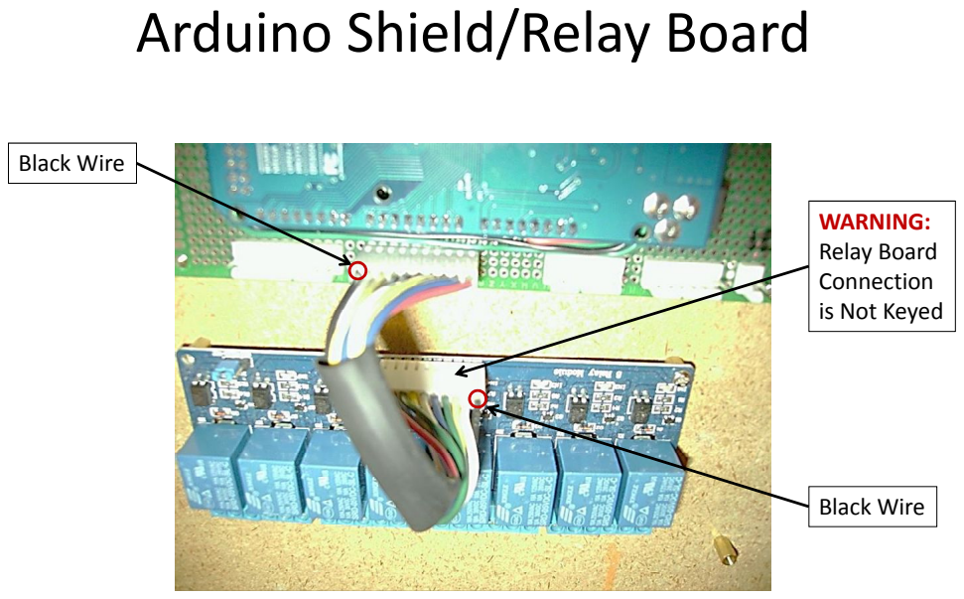
[picture p15: page 6]
Black Wire

WARNING:
Relay Board
Connection
is Not Keyed

# Arduino Shield/Relay Board

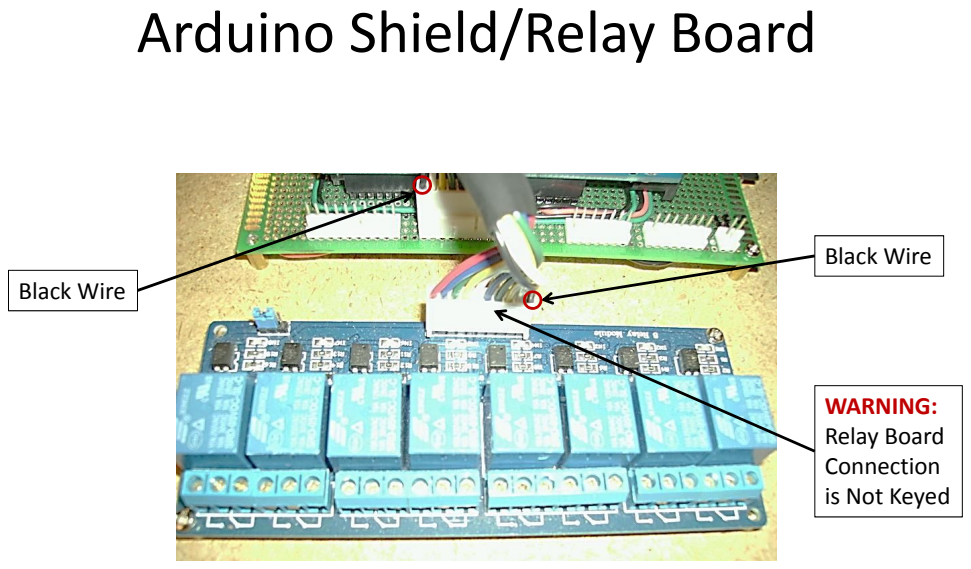
[picture p16: page 7]
Black Wire

WARNING:
Relay Board
Connection
is Not Keyed
