Nick1787/Narwhal-Arduino-Code/Electrical/Schematic/ACBoxWiring_Rev6.pdf

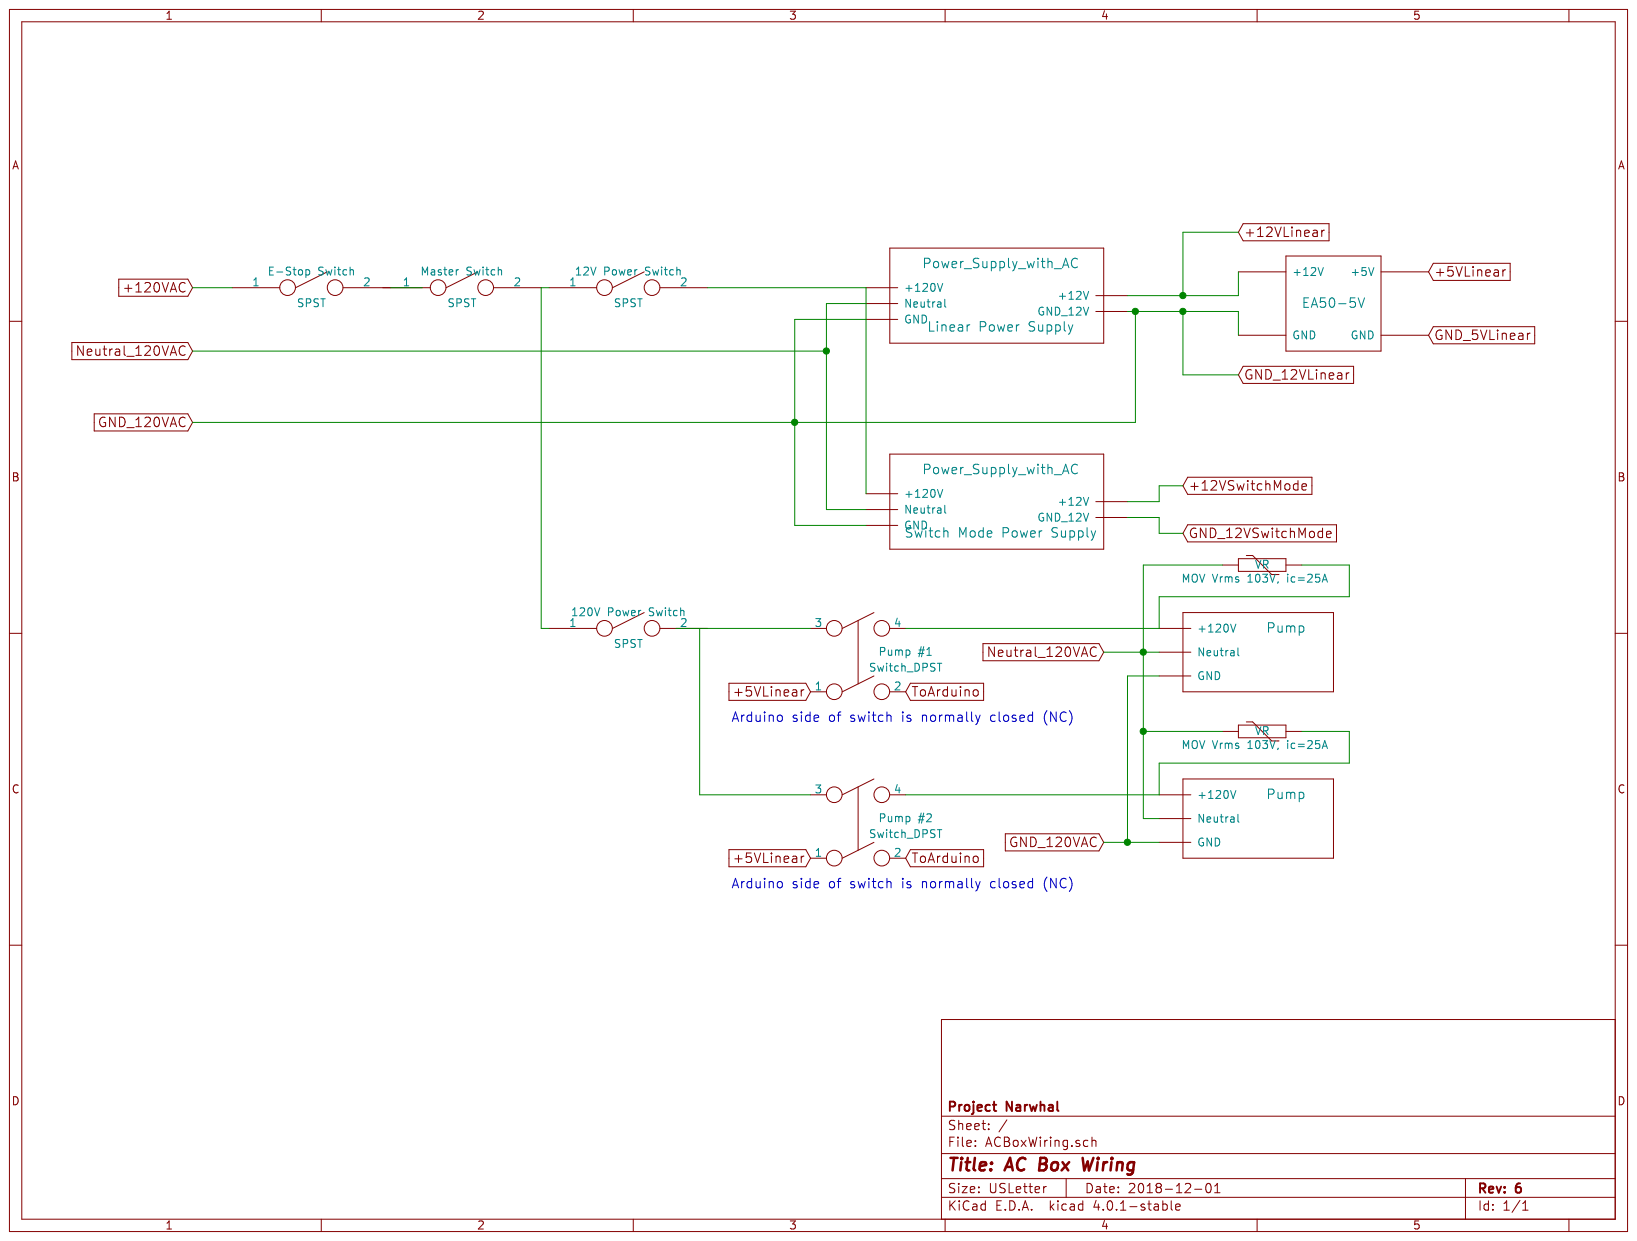
[picture p17: page 1]
