Nick1787/Narwhal-Arduino-Code/Electrical/Schematic/OLDACBoxWiring_Rev5.pdf

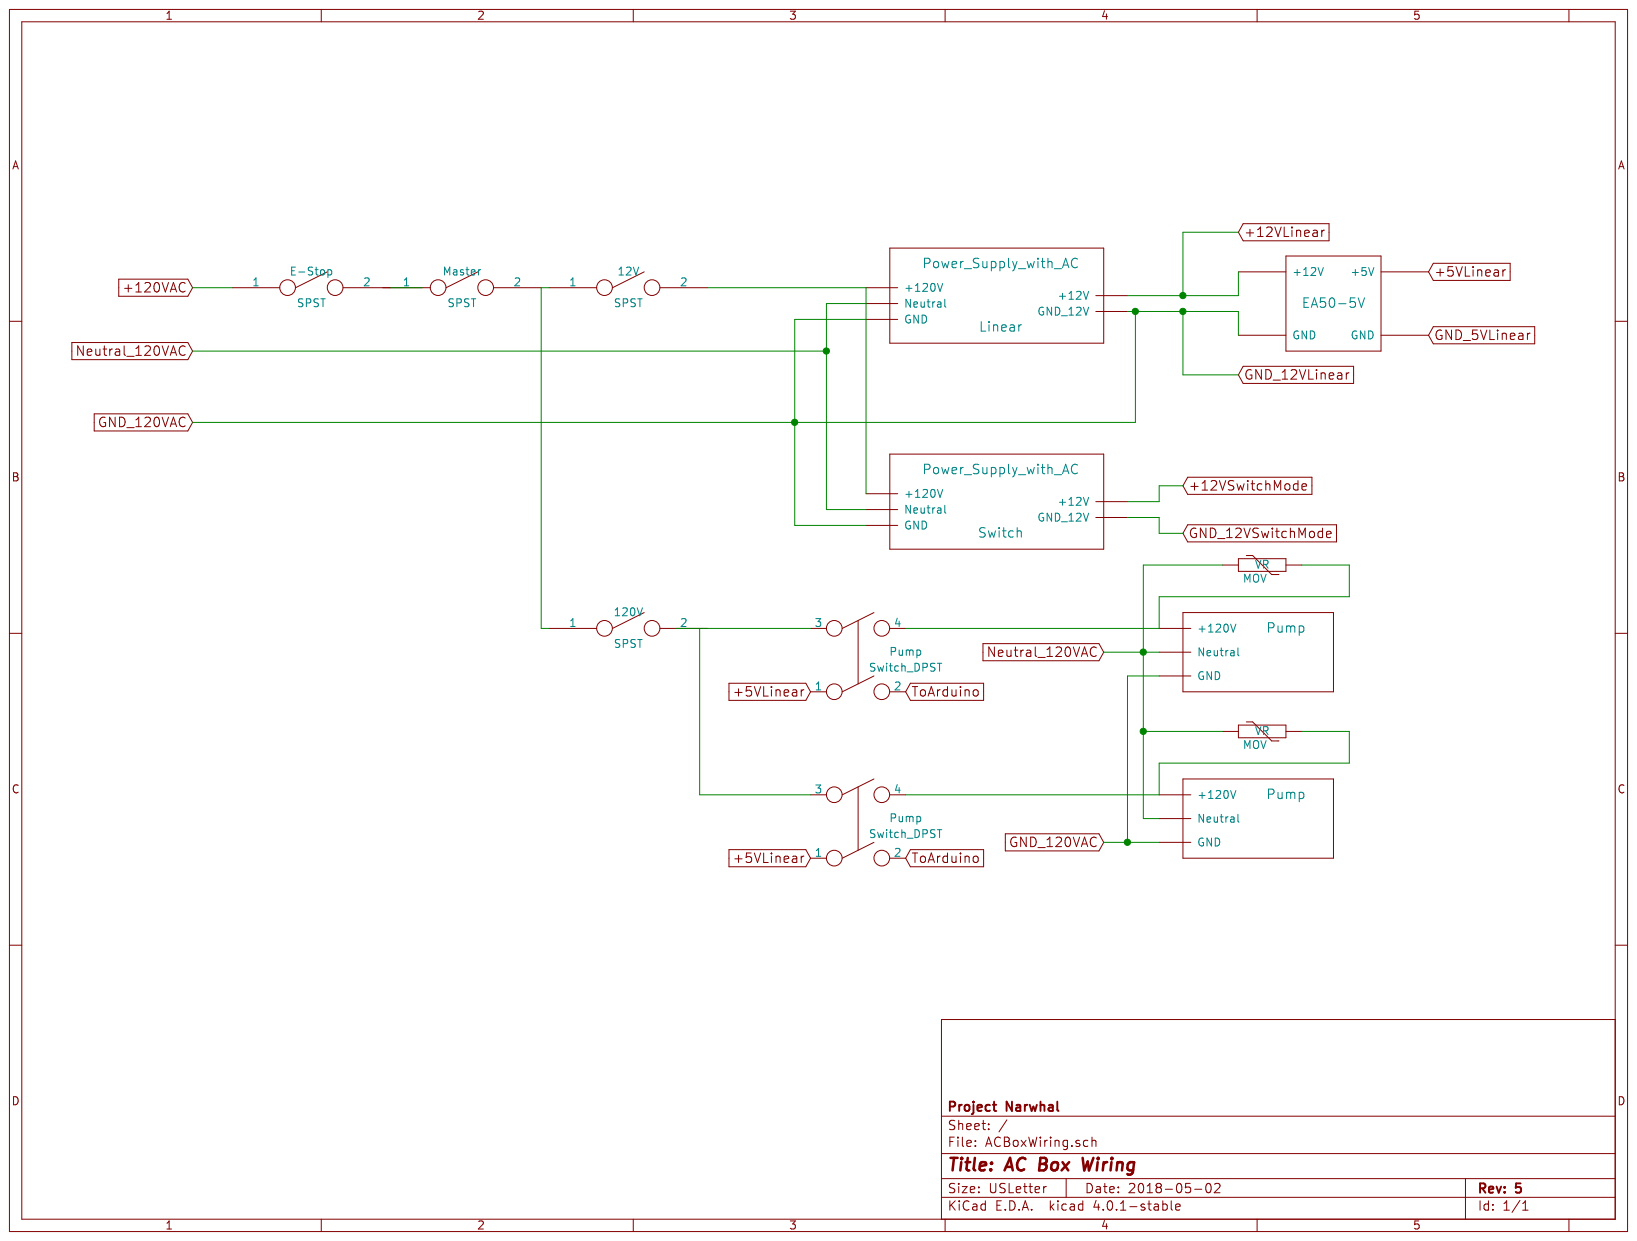
[picture p18: page 1]
