Nick1787/Narwhal-Arduino-Code/Electrical/Schematic/NarwhalShield_Rev5.pdf

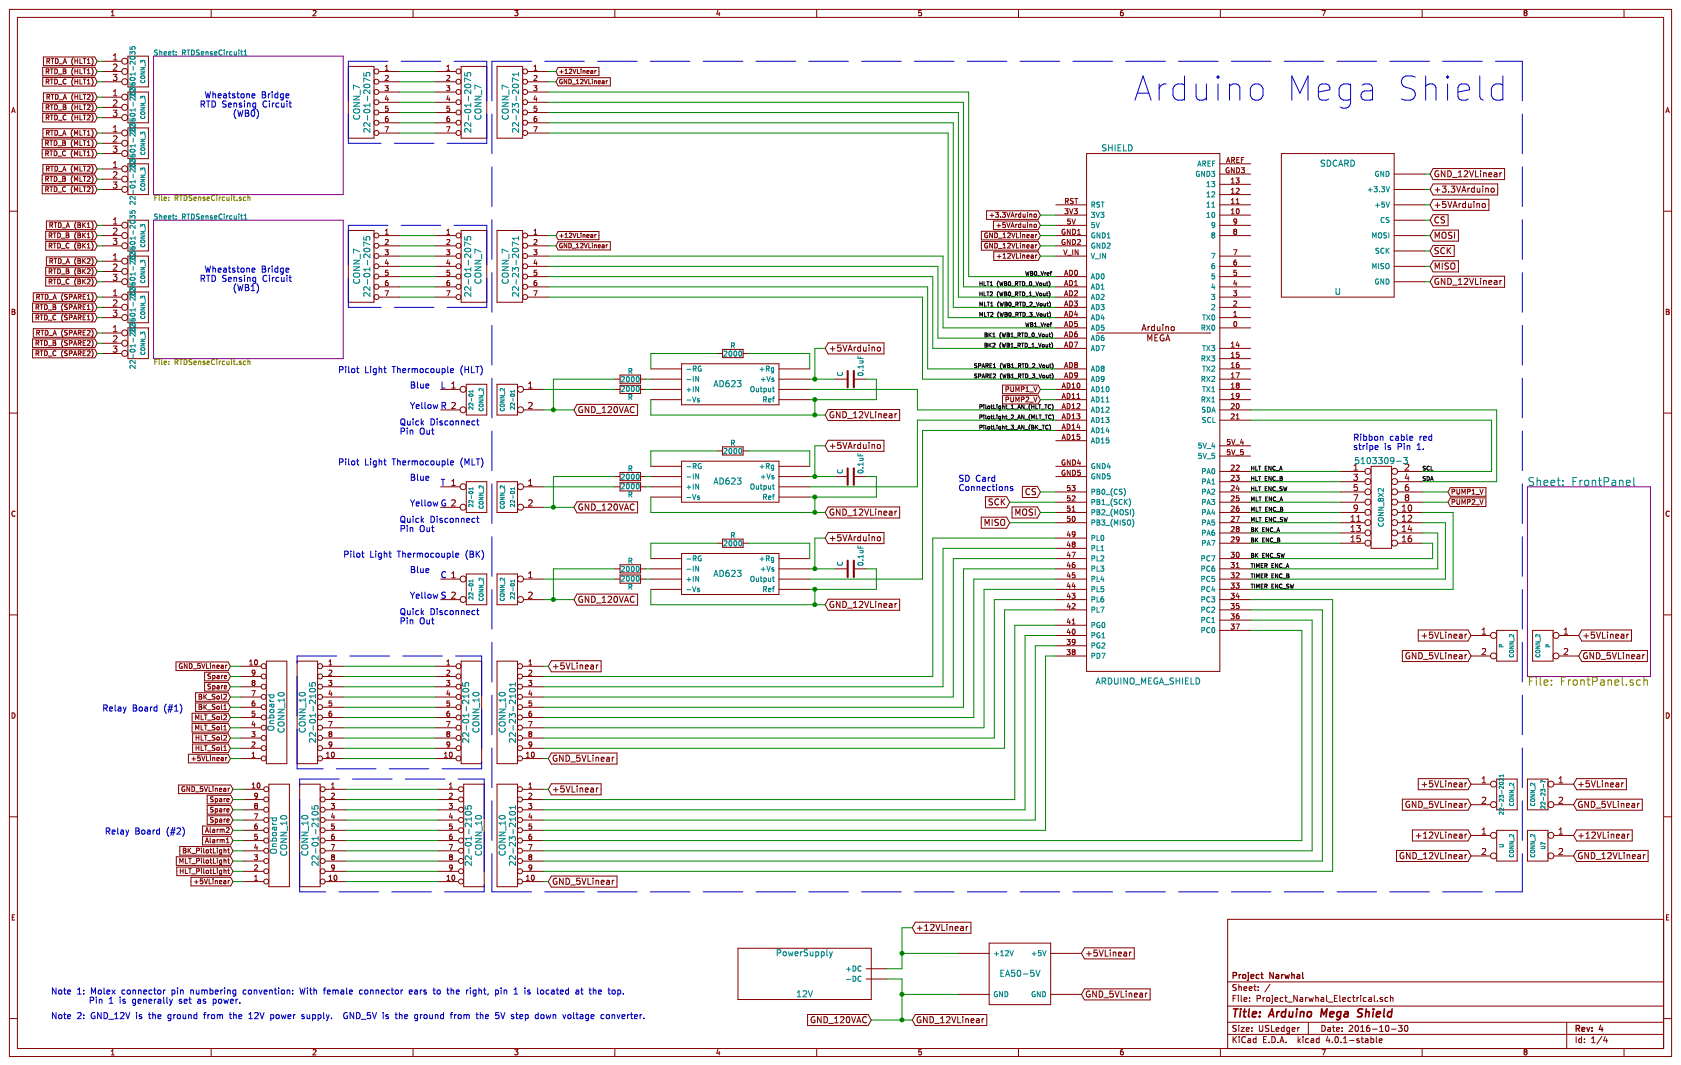
[picture p19: page 1]

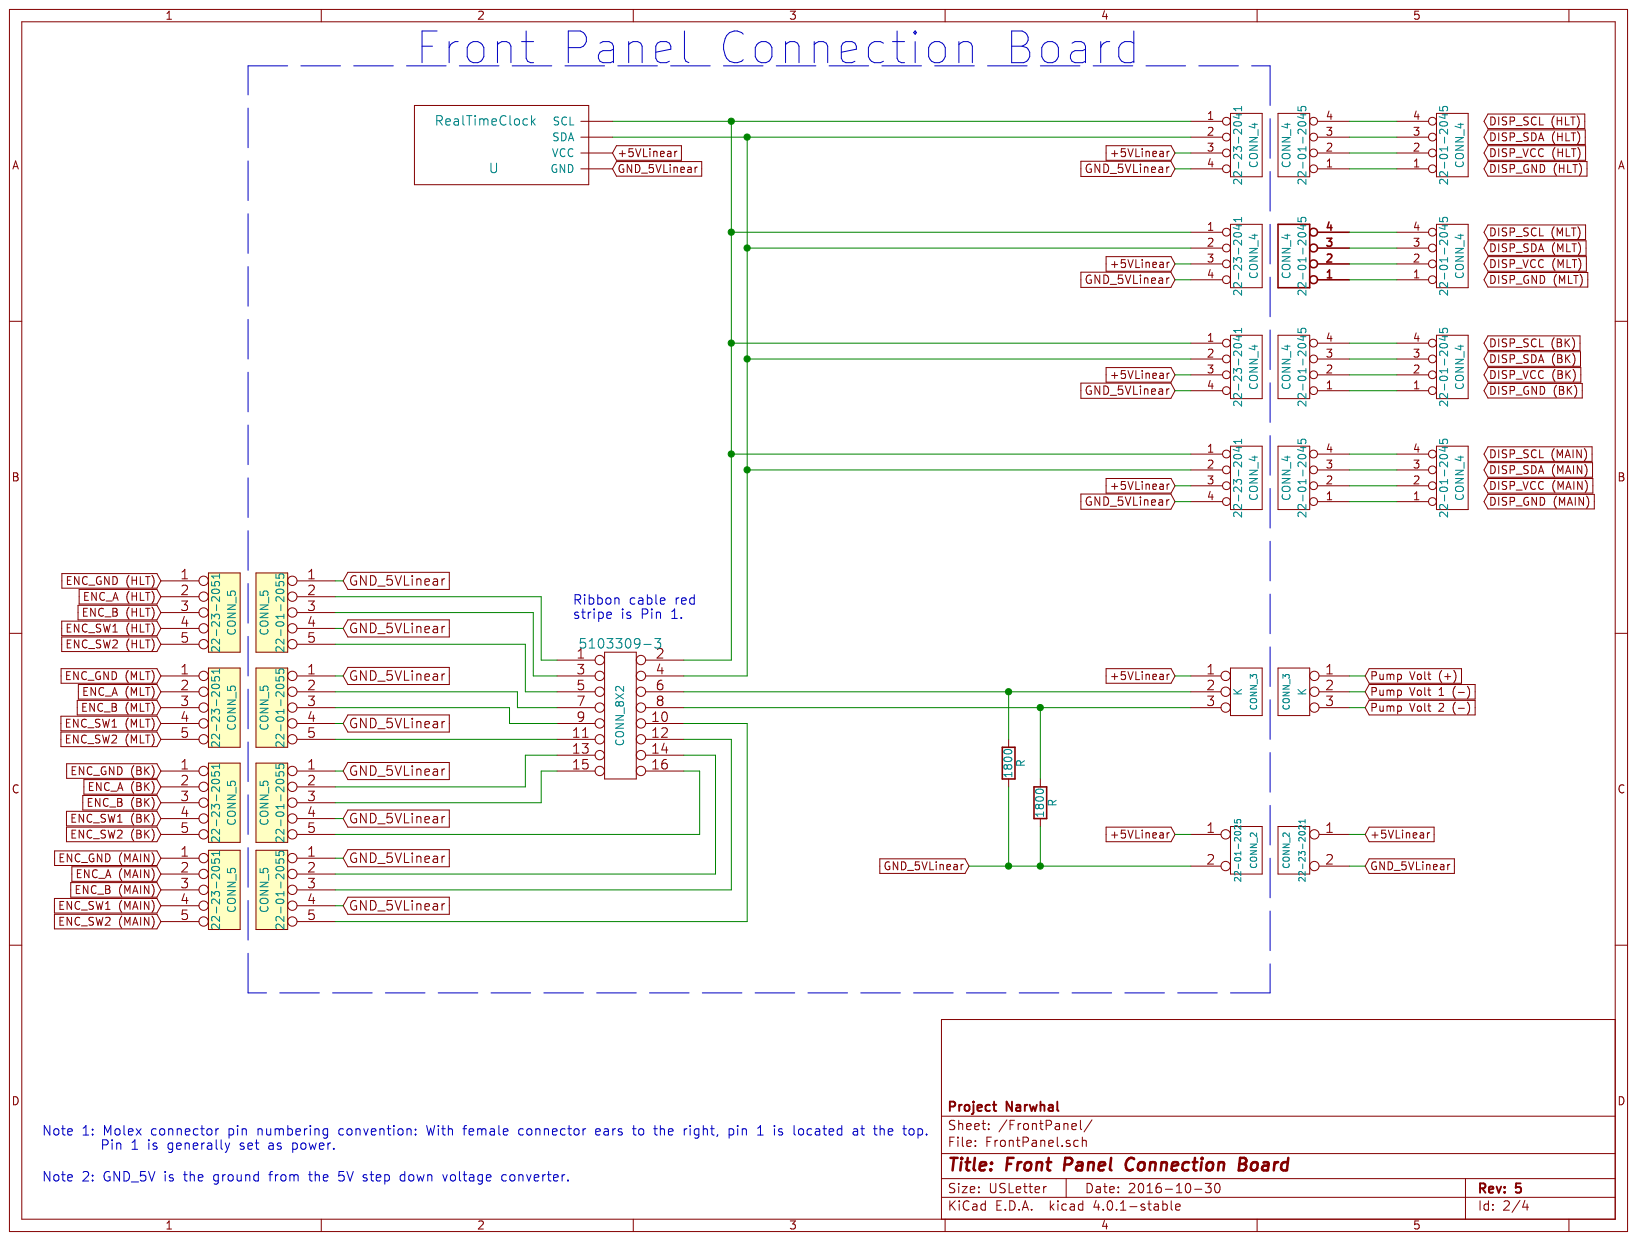
[picture p20: page 2]

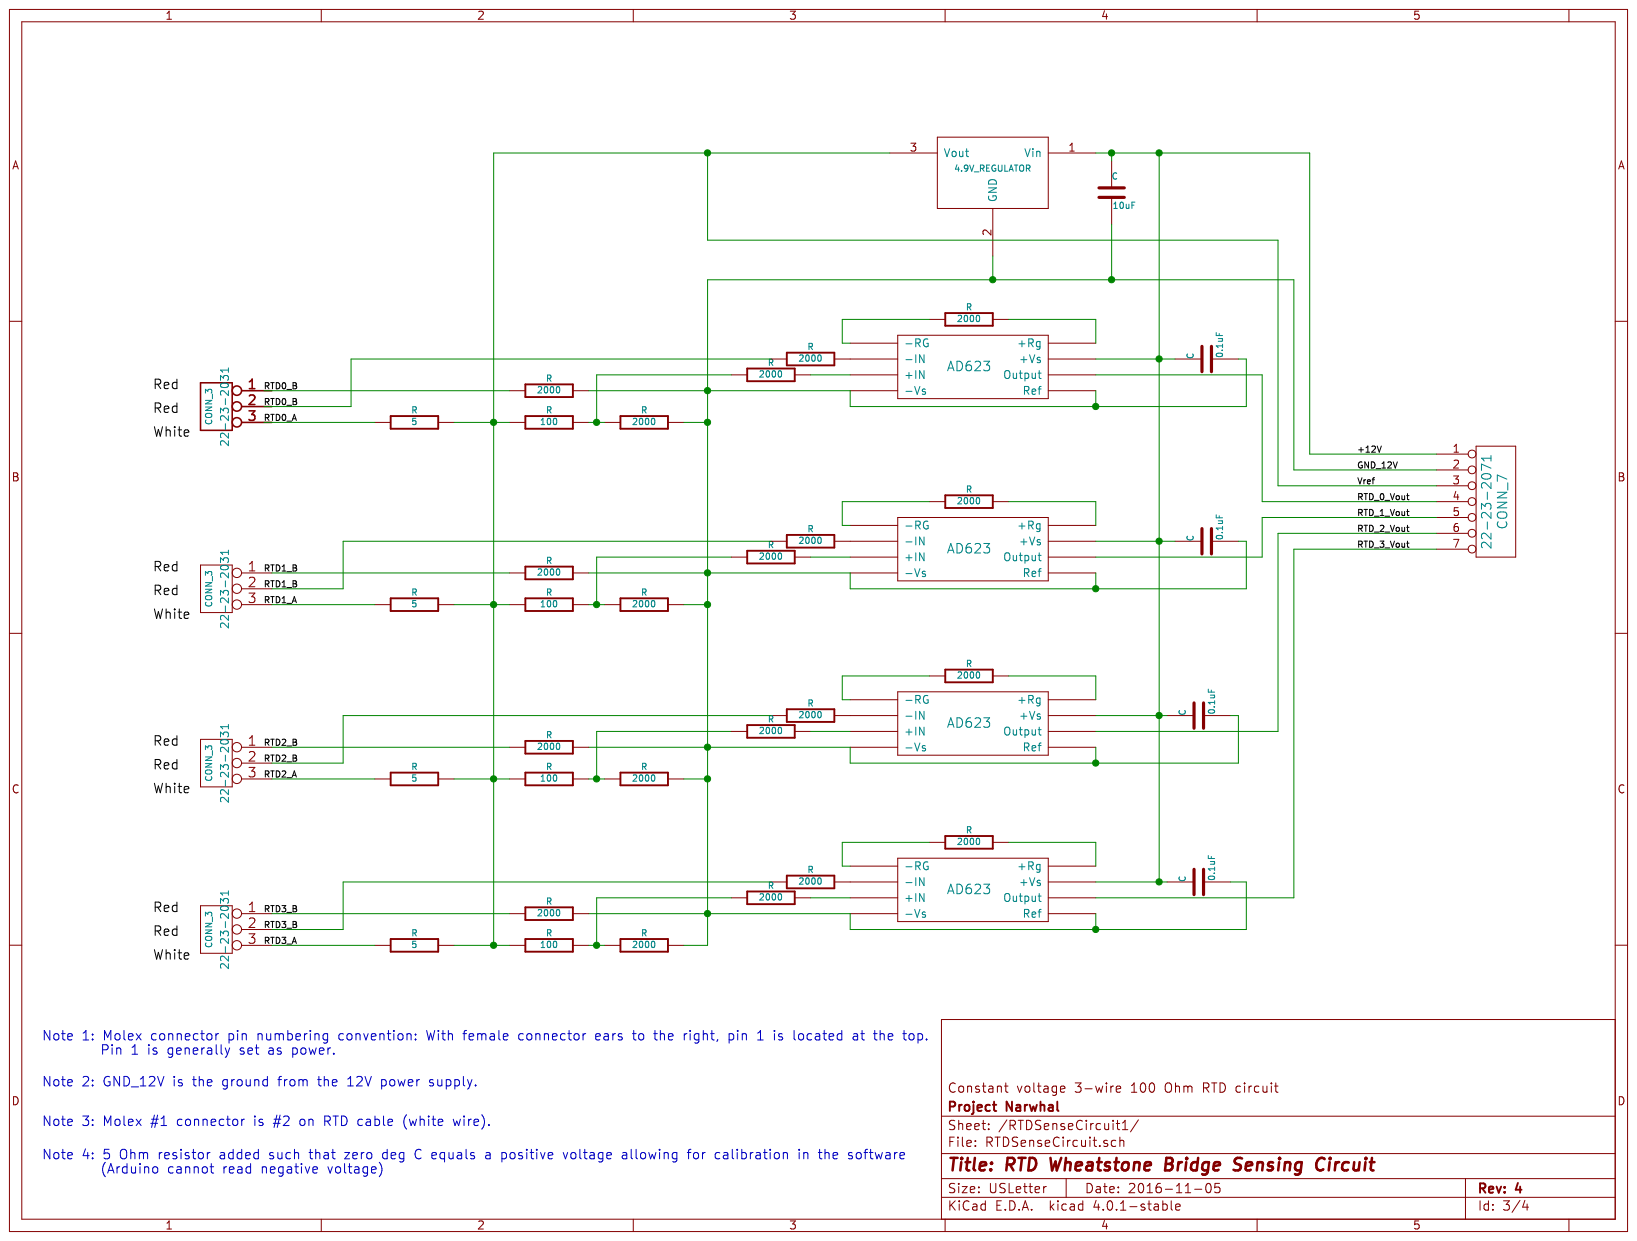
[picture p21: page 3]

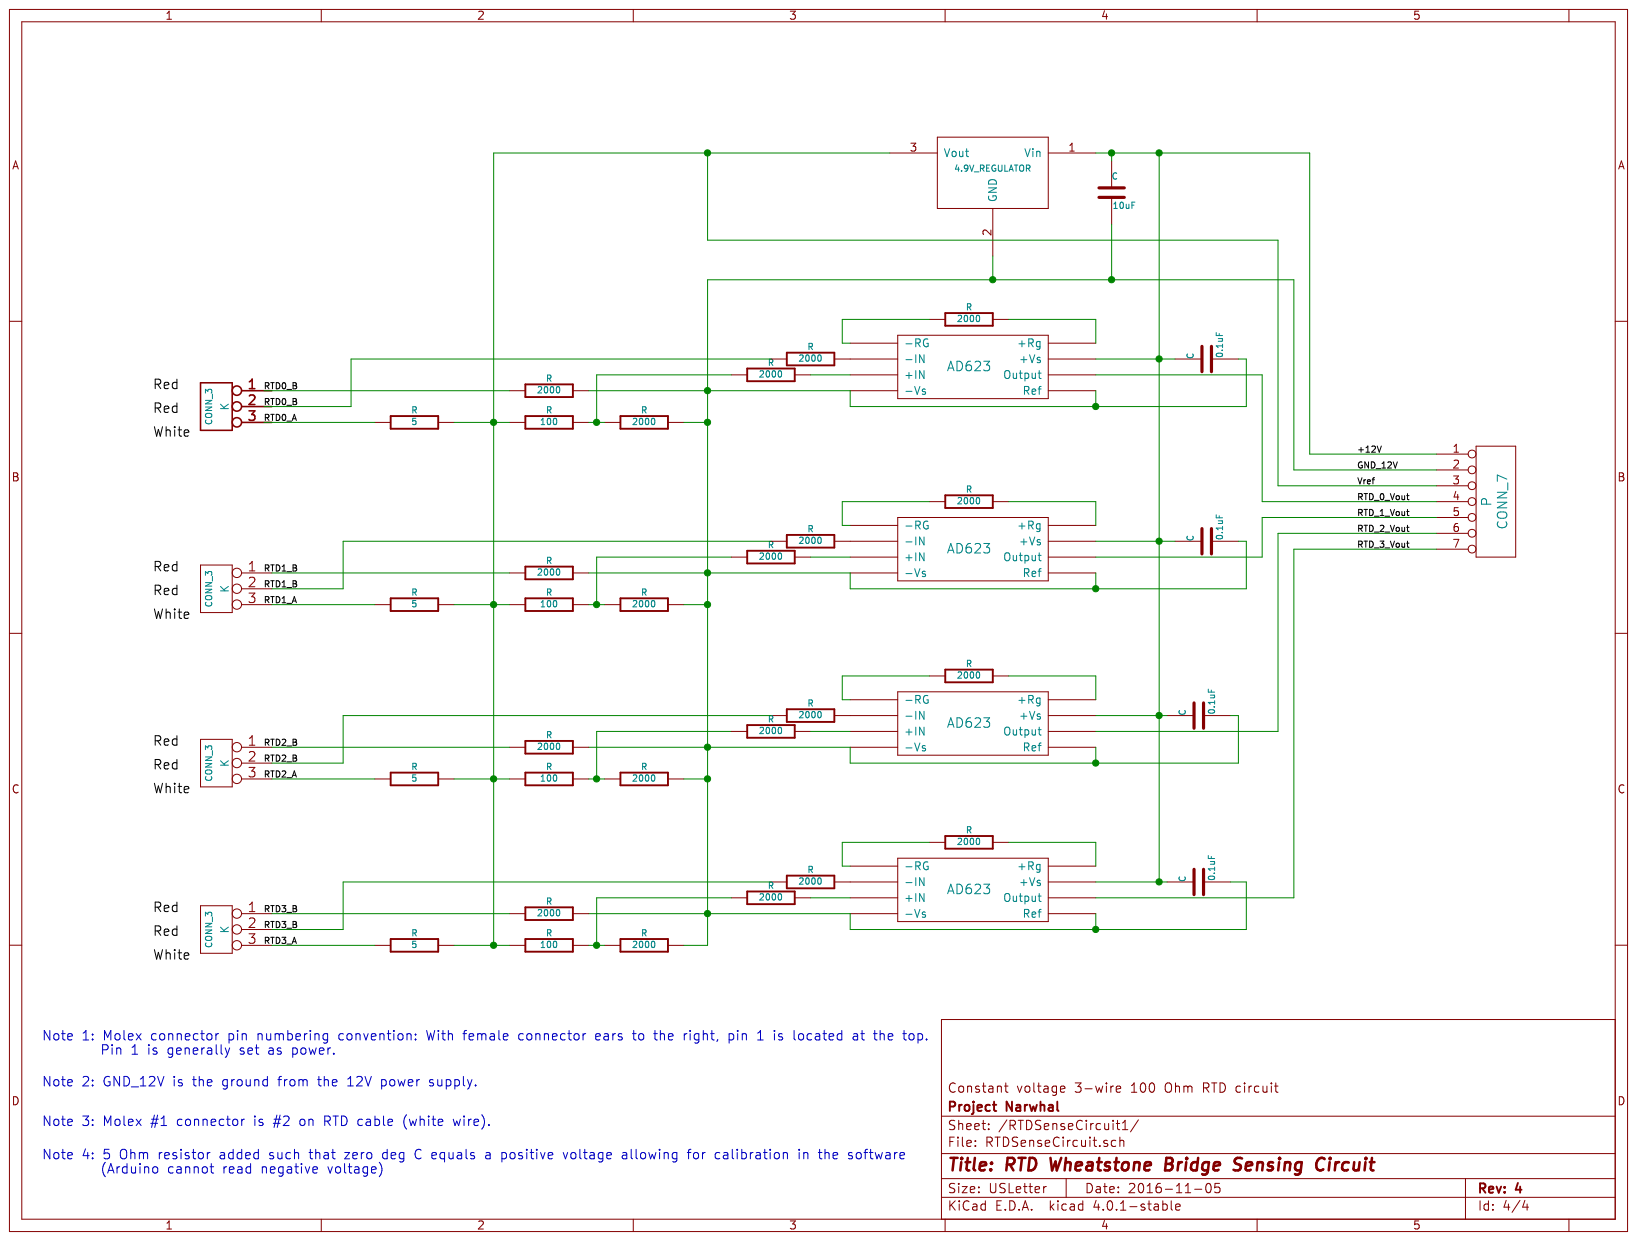
[picture p22: page 4]
