Nick1787/Narwhal-Arduino-Code/Electrical/Schematic/OLDNarwhalShield_Rev4.pdf

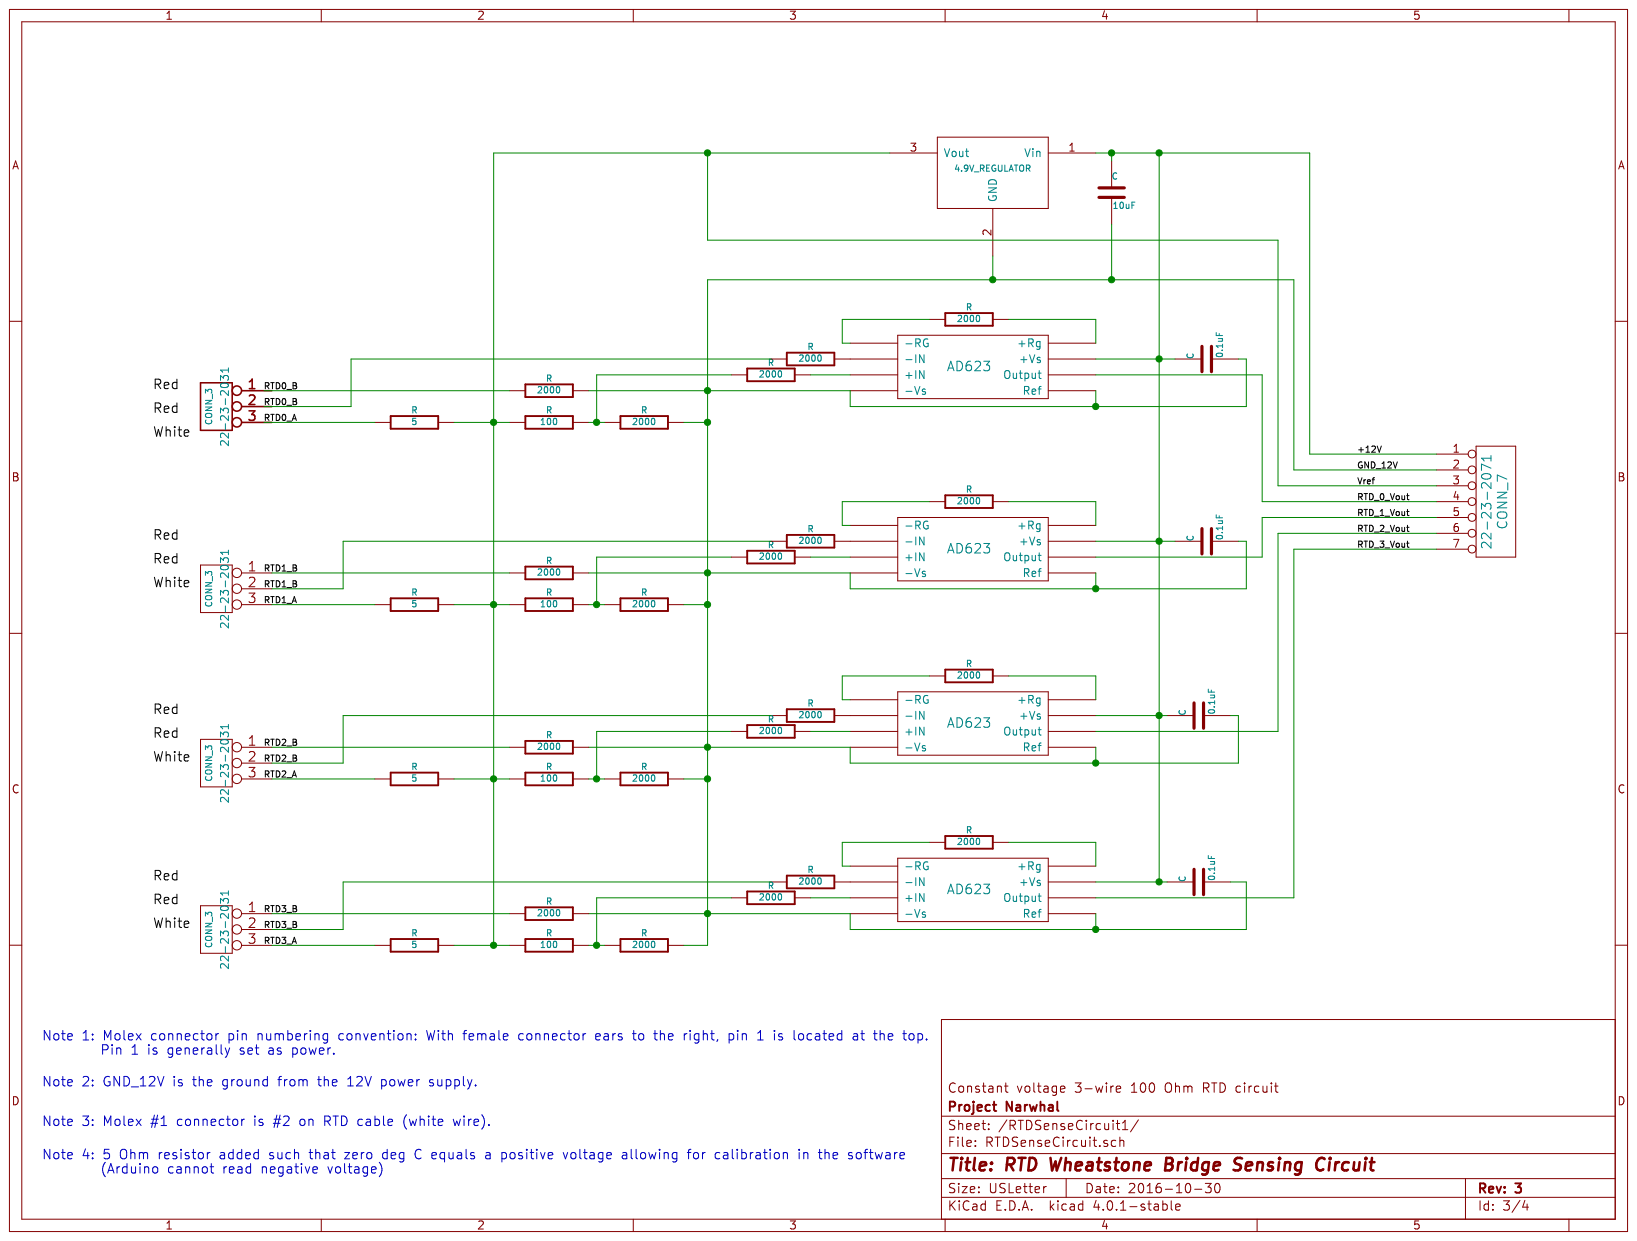
[picture p23: page 3]

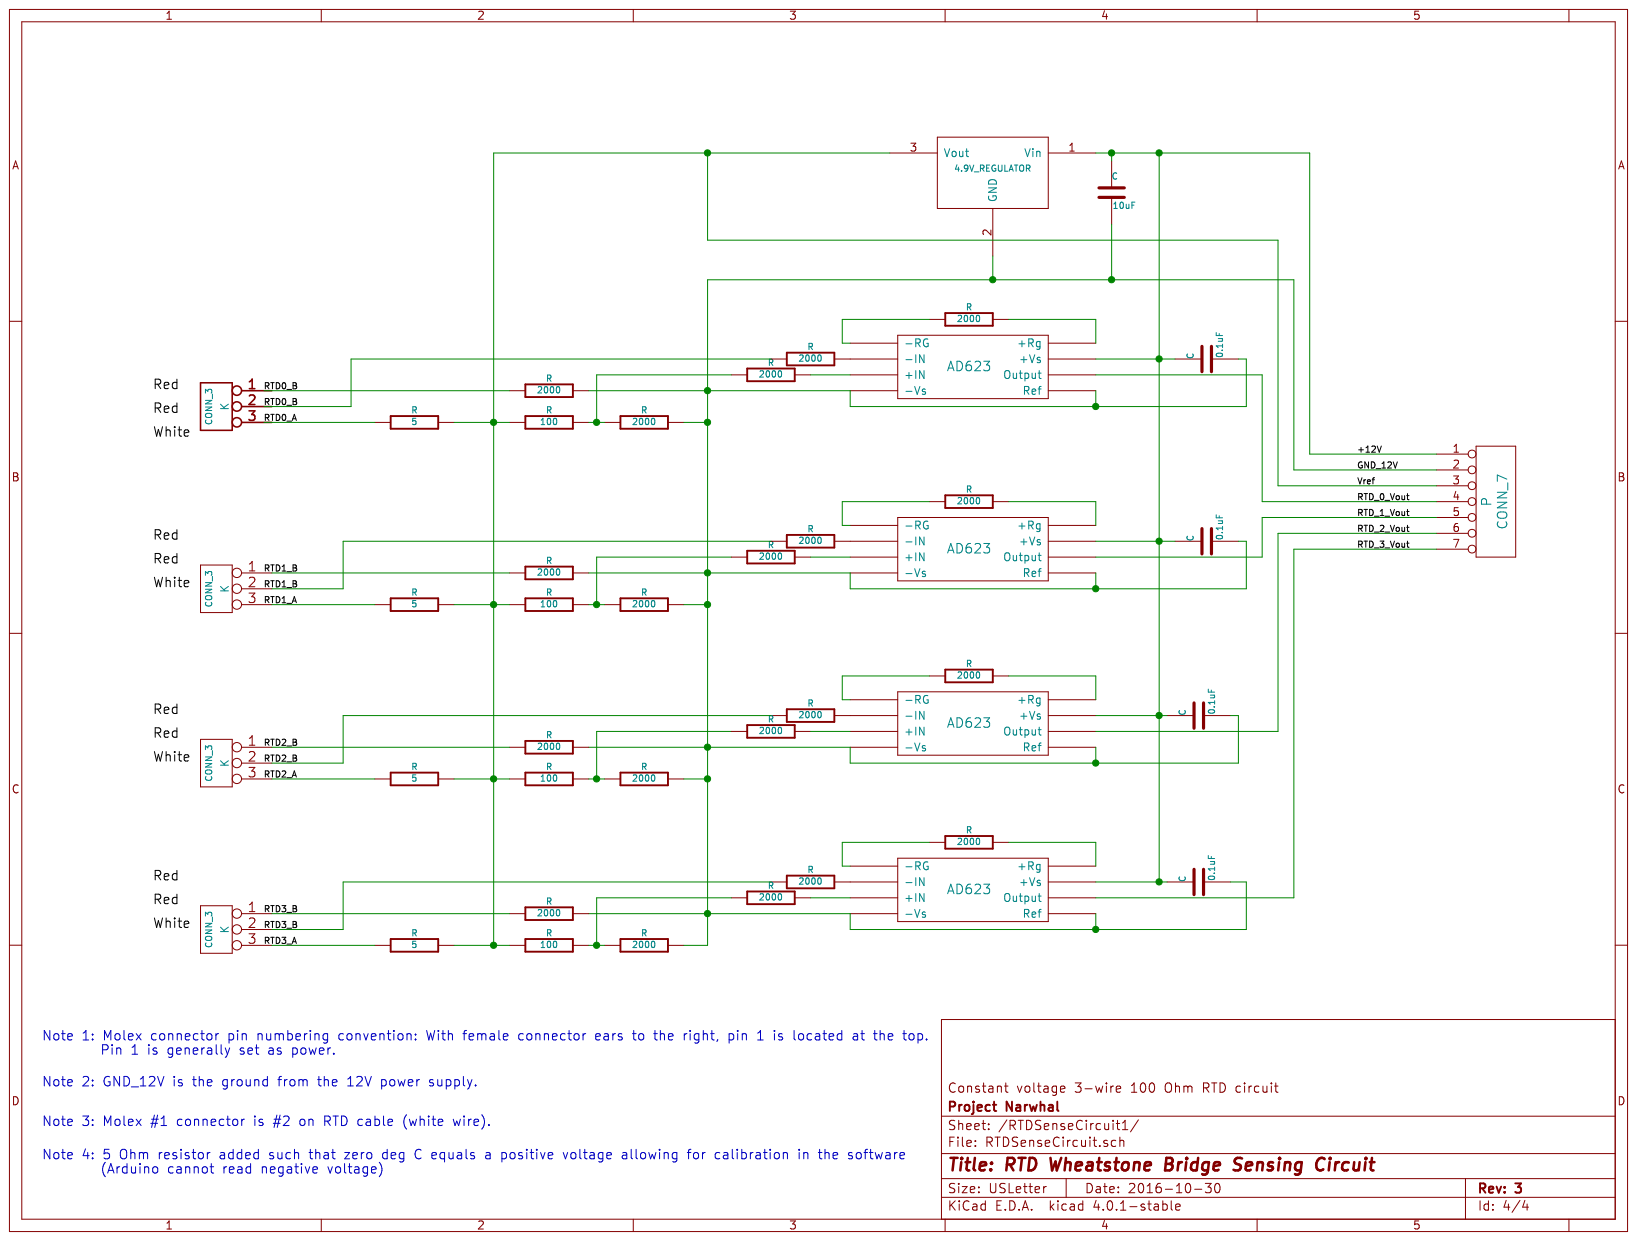
[picture p24: page 4]
