Nick1787/Narwhal-Arduino-Code/Electrical/Schematic/GenericWheatstoneBridge_Rev2.pdf

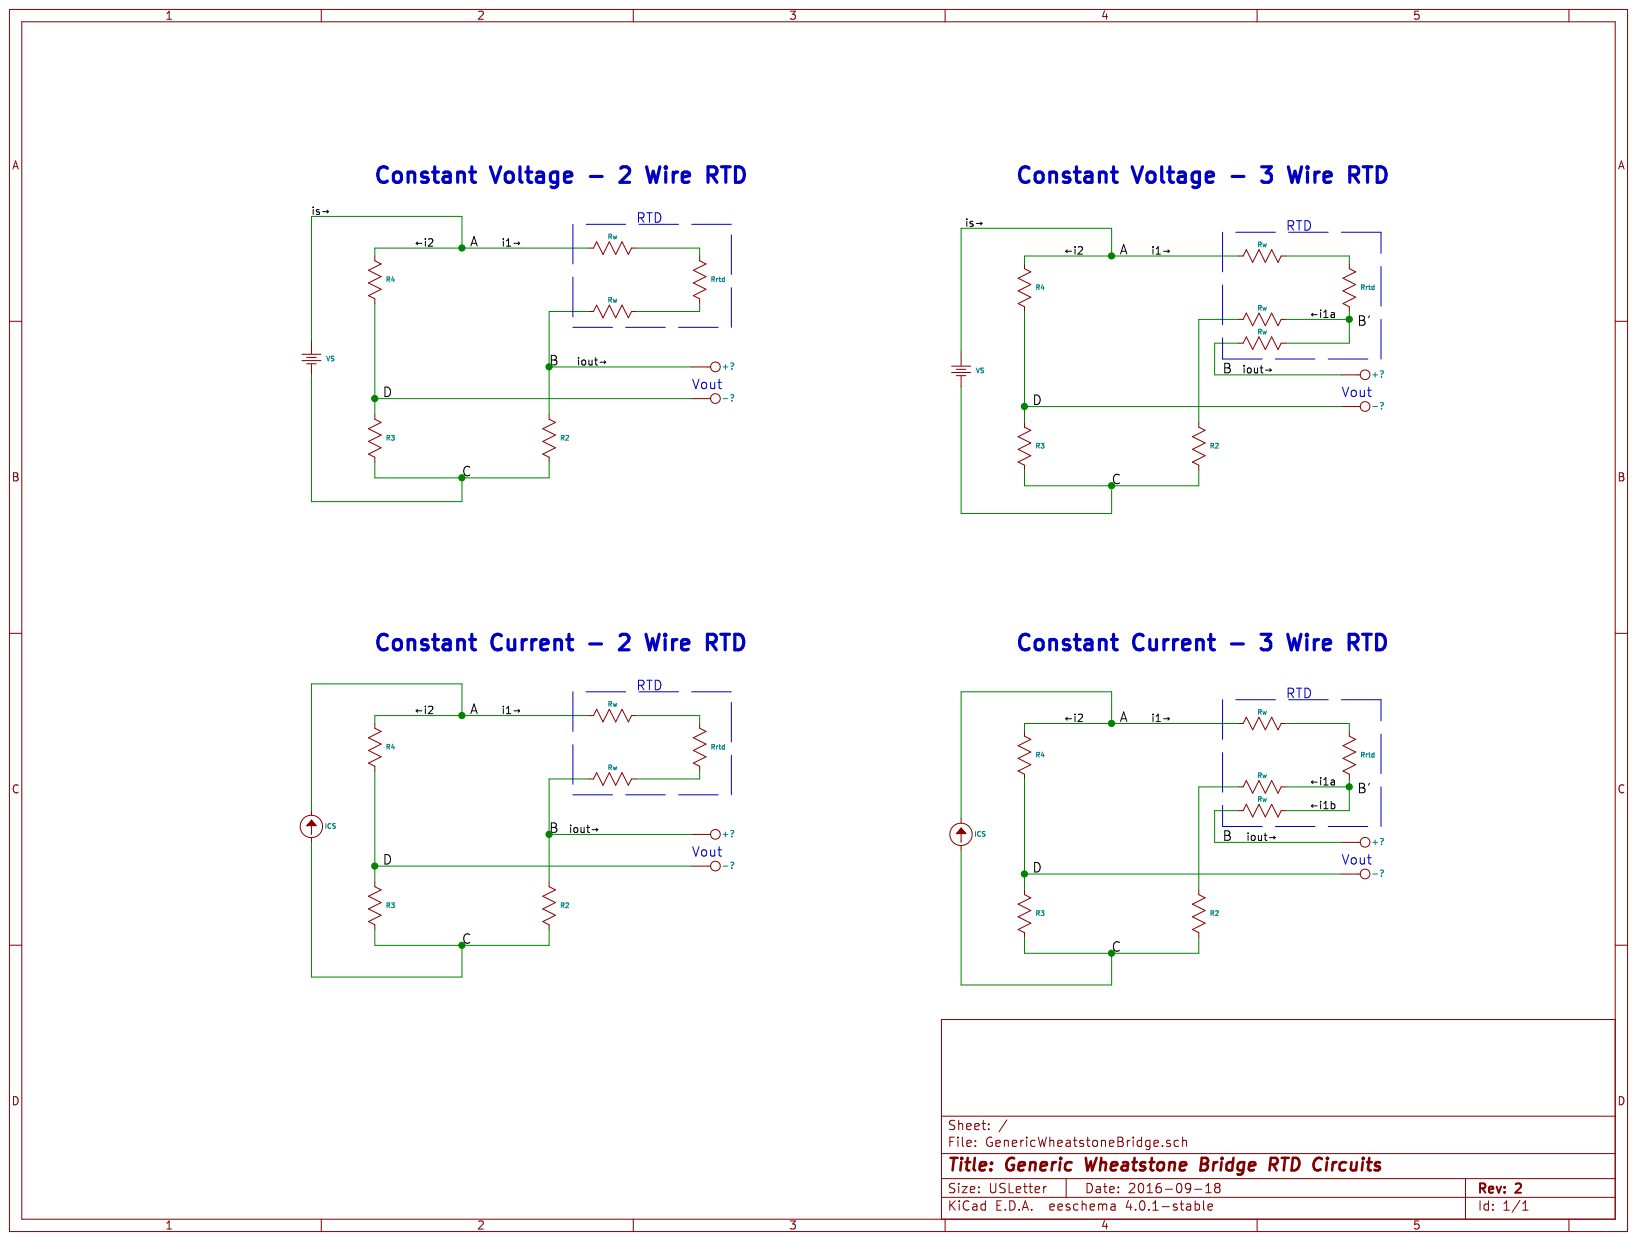
[picture p25: page 1]
