Nick1787/Narwhal-Arduino-Code/Electrical/Schematic/OLDGenericWheatstoneBridge.pdf

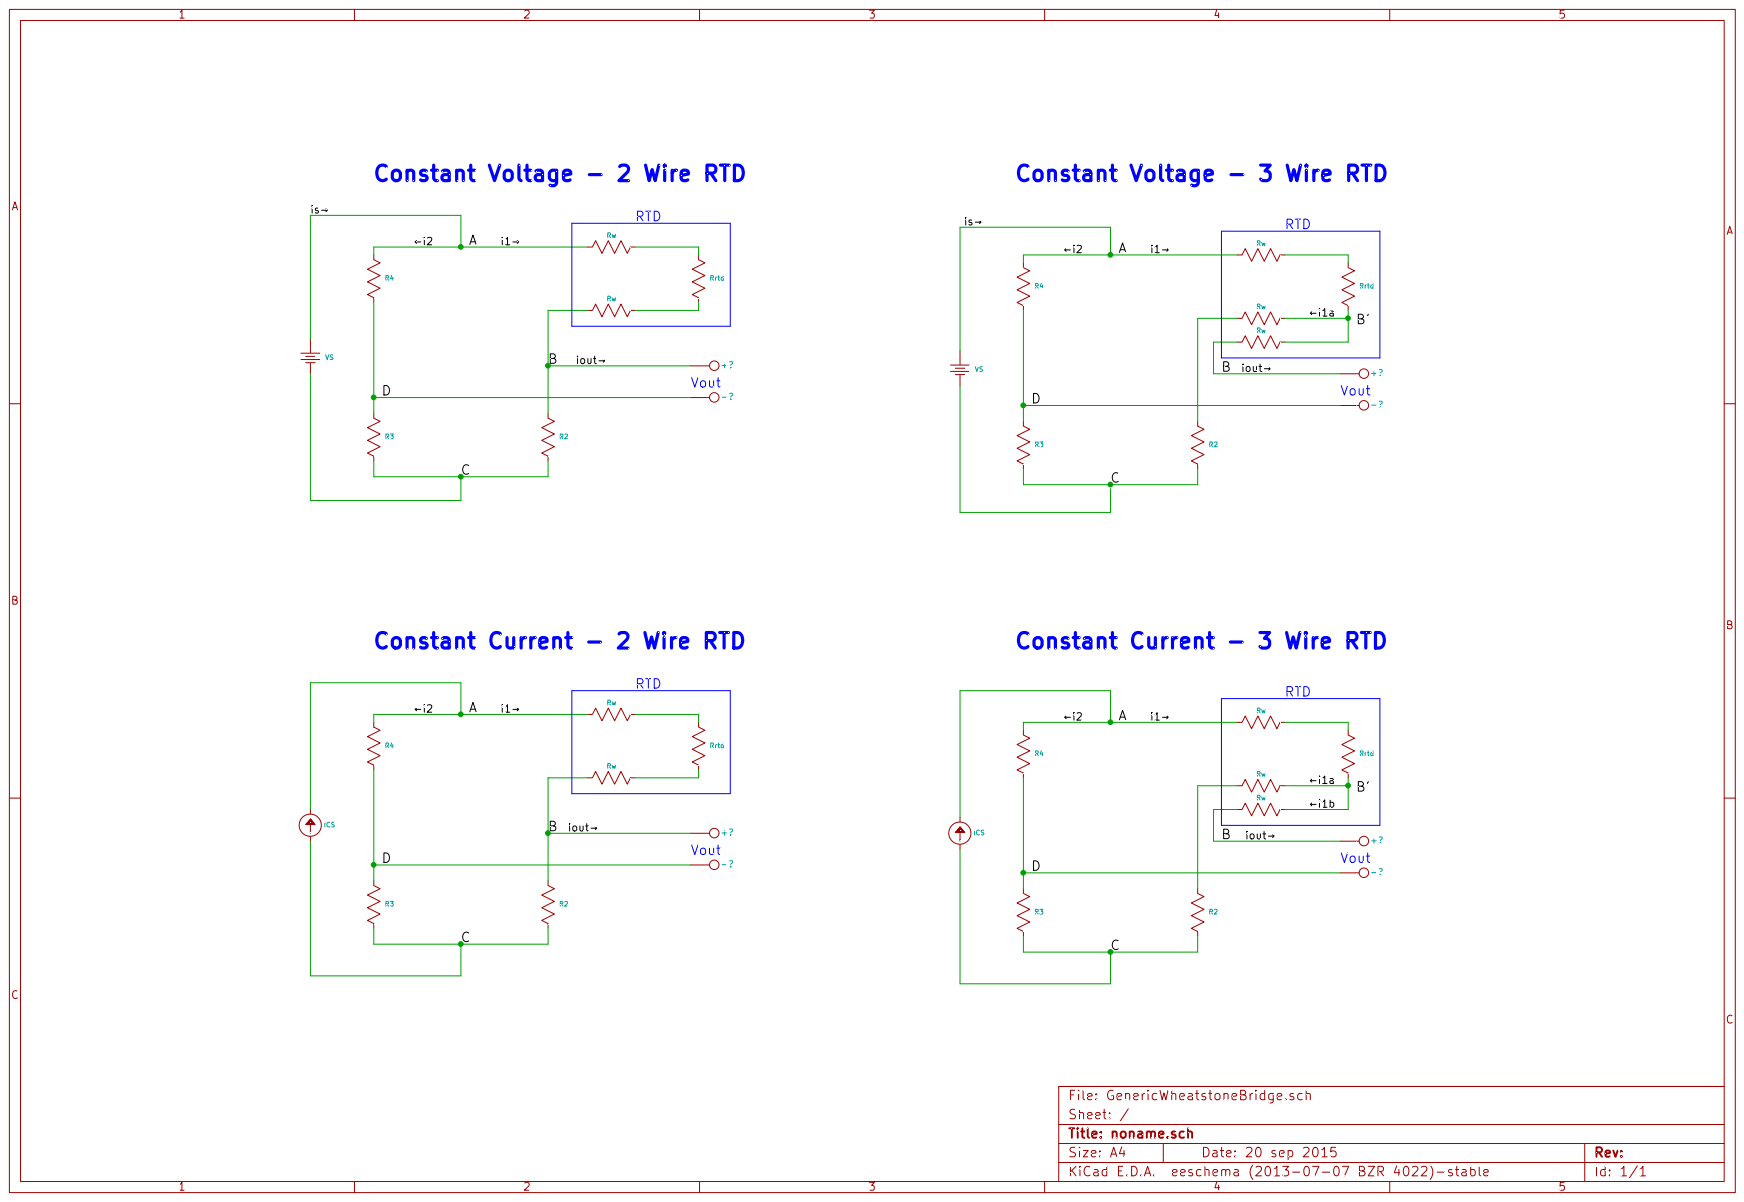
[picture p26: page 1]
