Nick1787/Narwhal-Arduino-Code/Electrical/Schematic/OLDACBoxWiring_Rev4.pdf

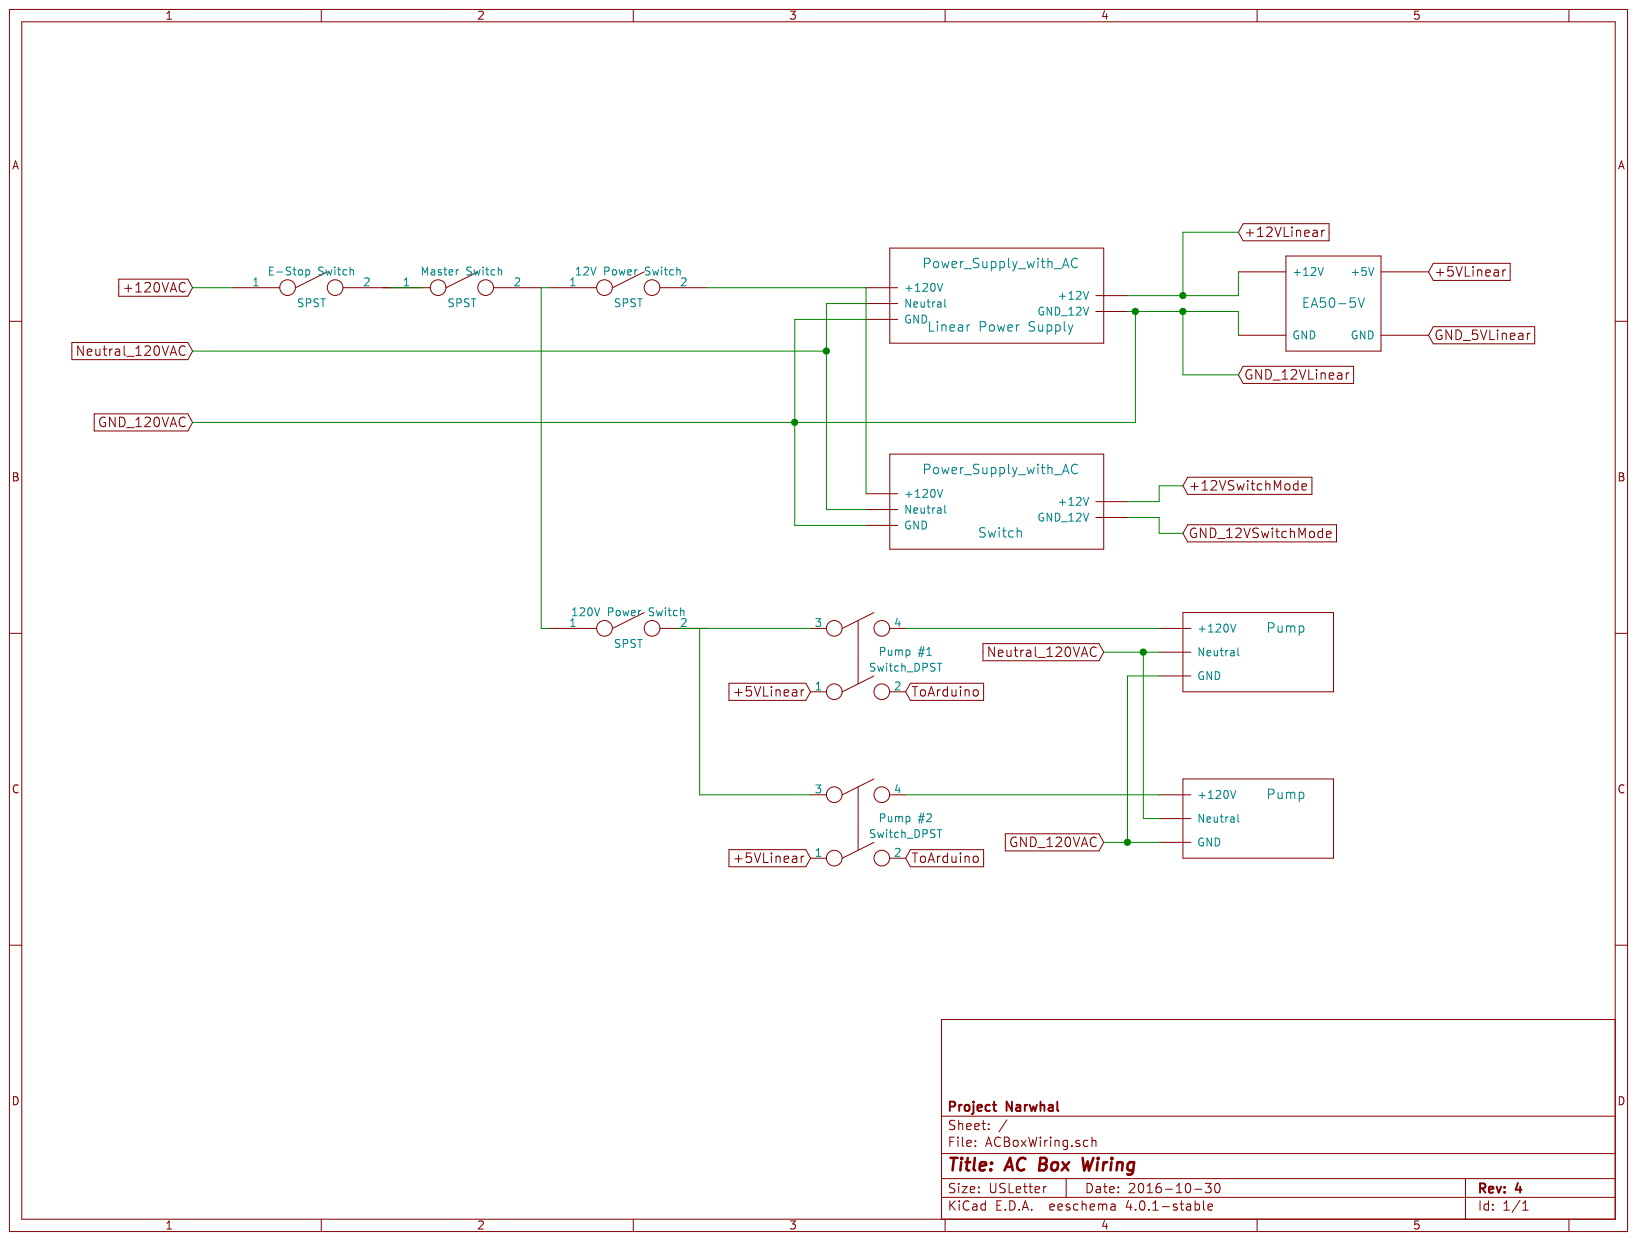
[picture p27: page 1]
