Nick1787/Narwhal-Arduino-Code/Electrical/Schematic/OLDACBoxWiring_Rev2.pdf

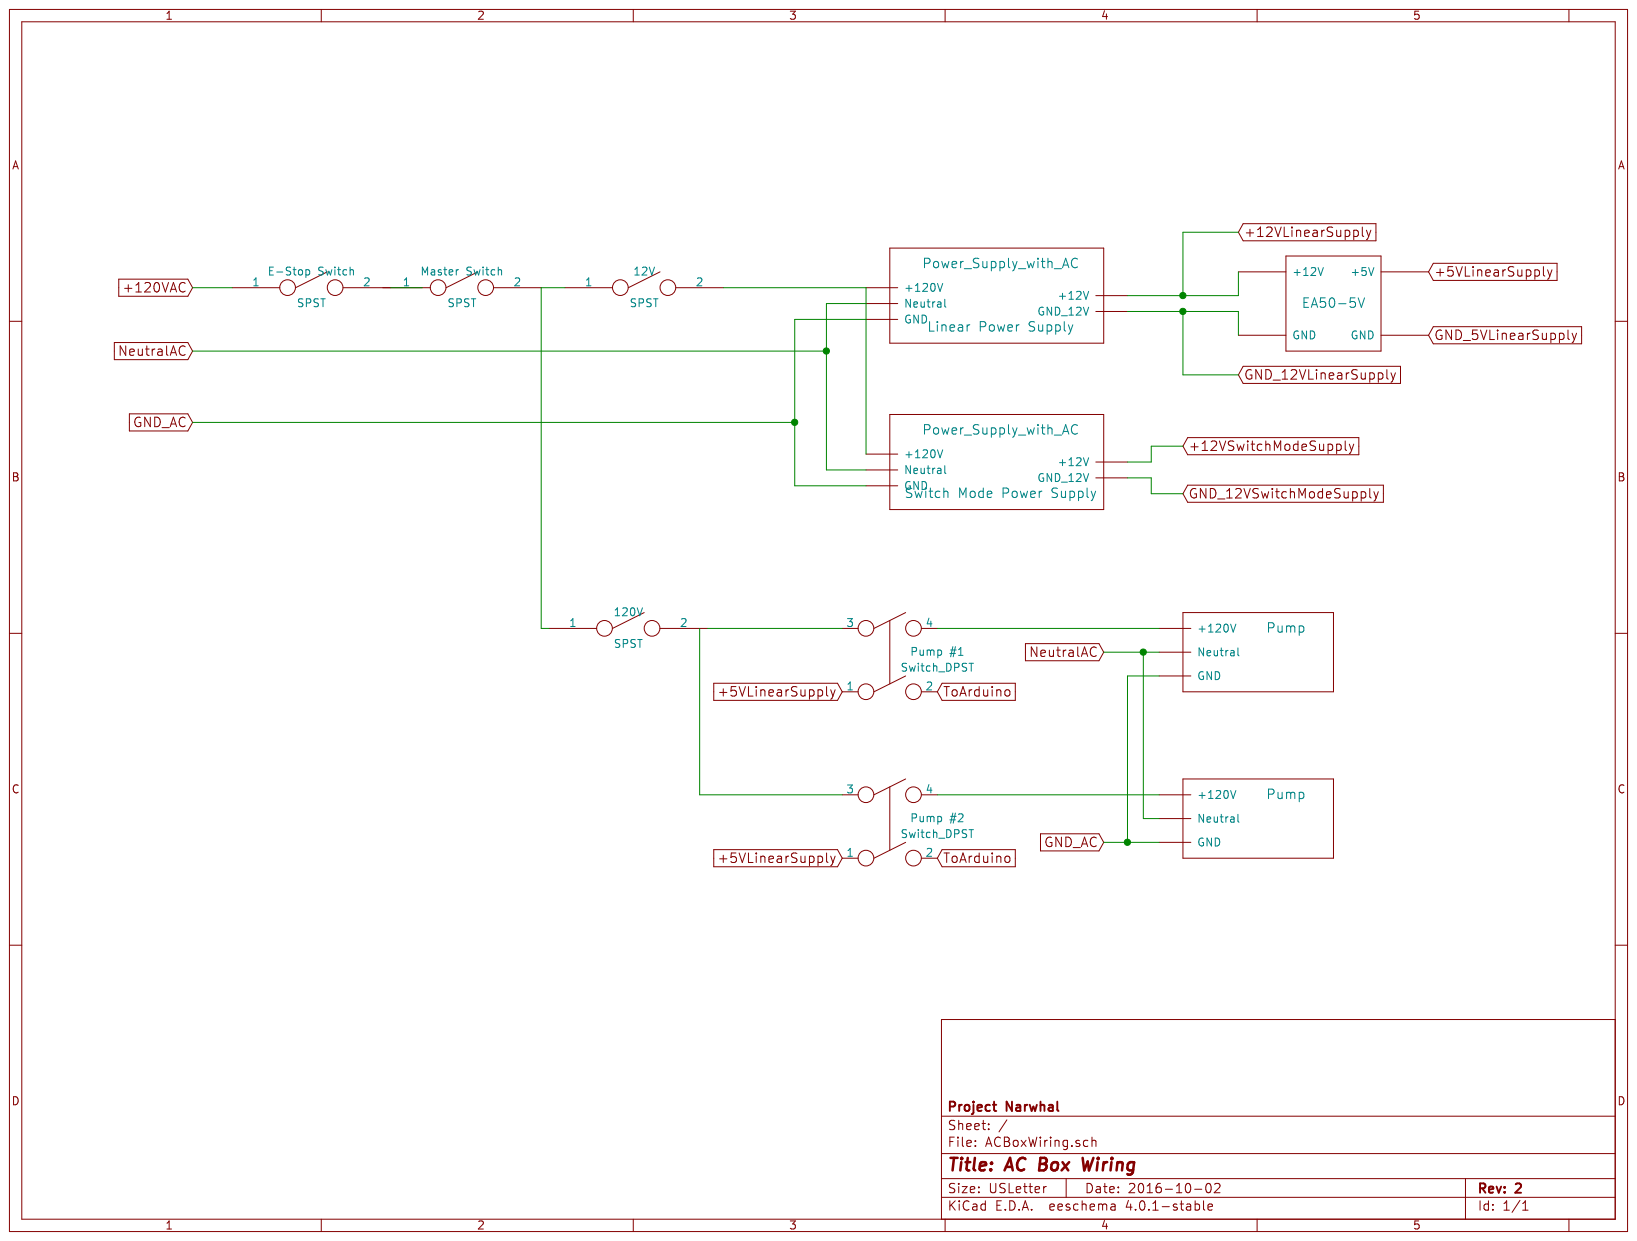
[picture p28: page 1]
