Nick1787/Narwhal-Arduino-Code/Electrical/Schematic/OLDACBoxWiring_Rev3.pdf

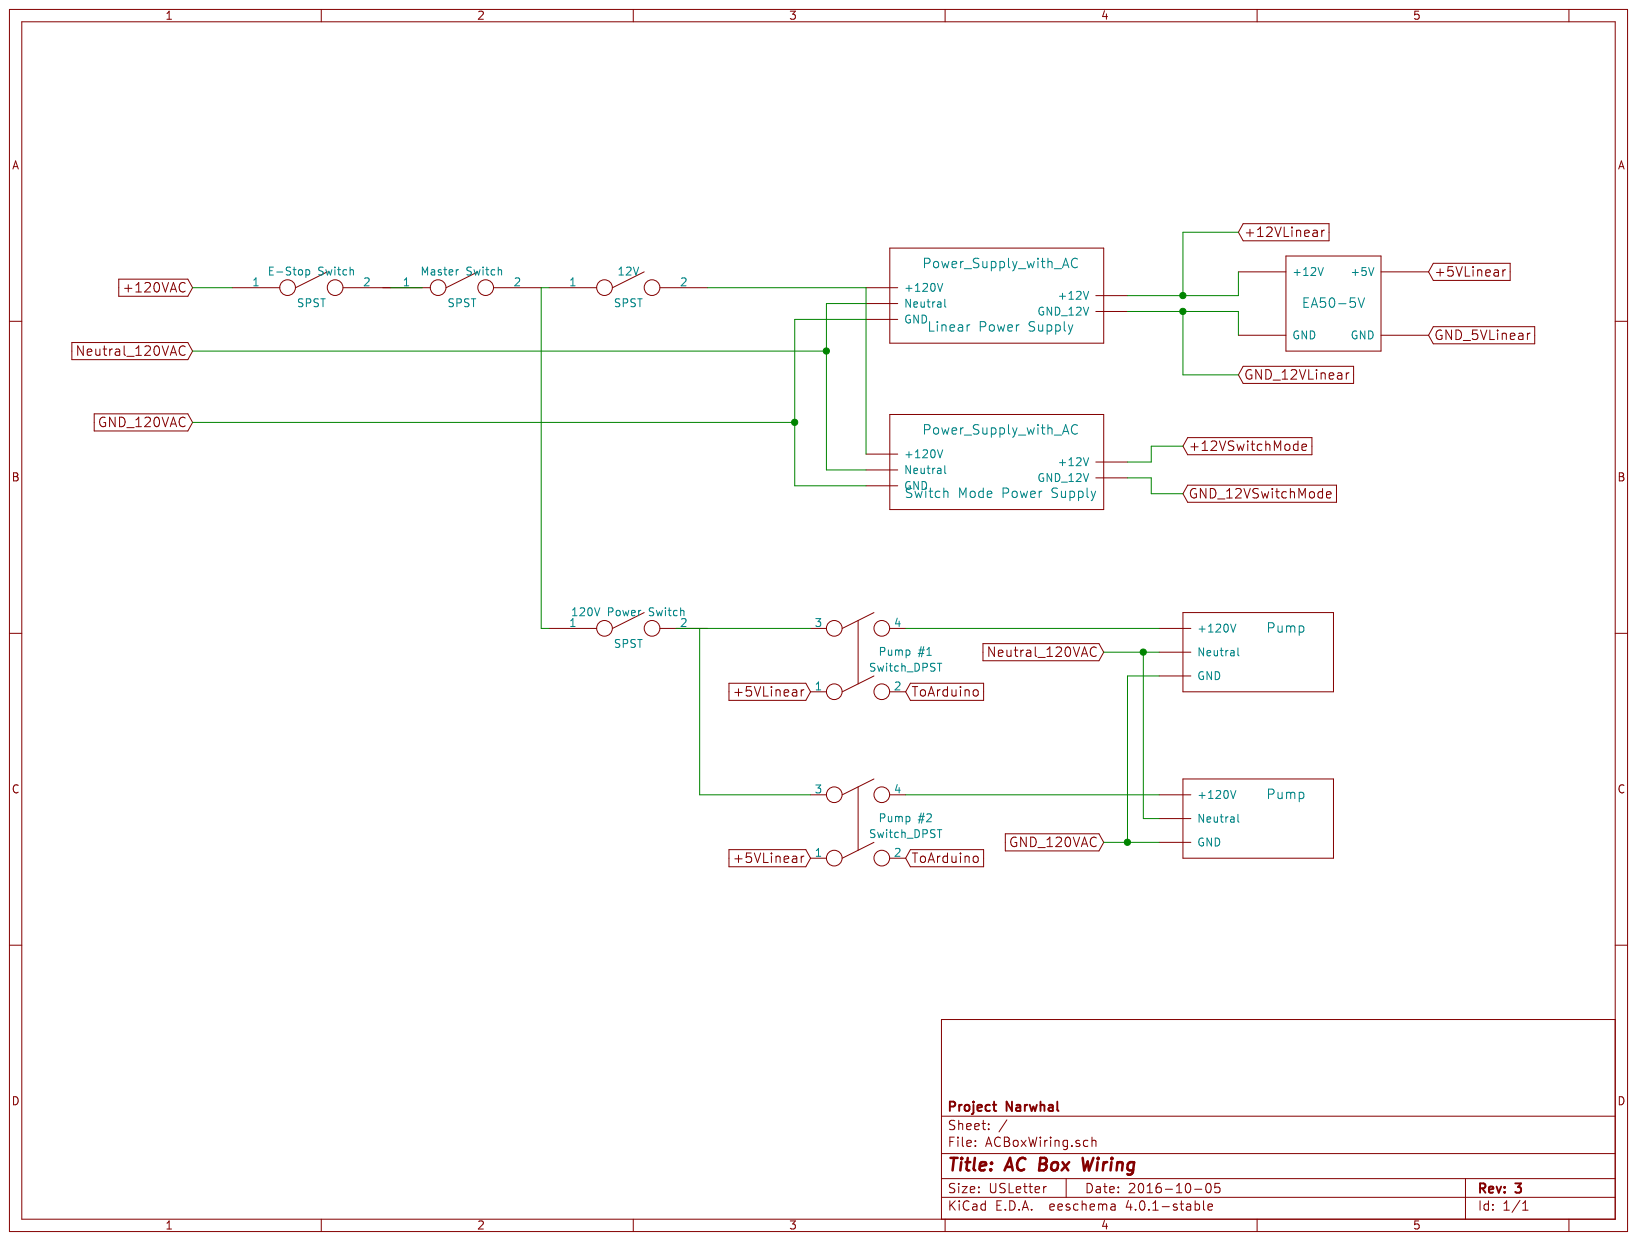
[picture p29: page 1]
