Nick1787/Narwhal-Arduino-Code/Electrical/Schematic/OLDNarwhalShield_Rev3.pdf

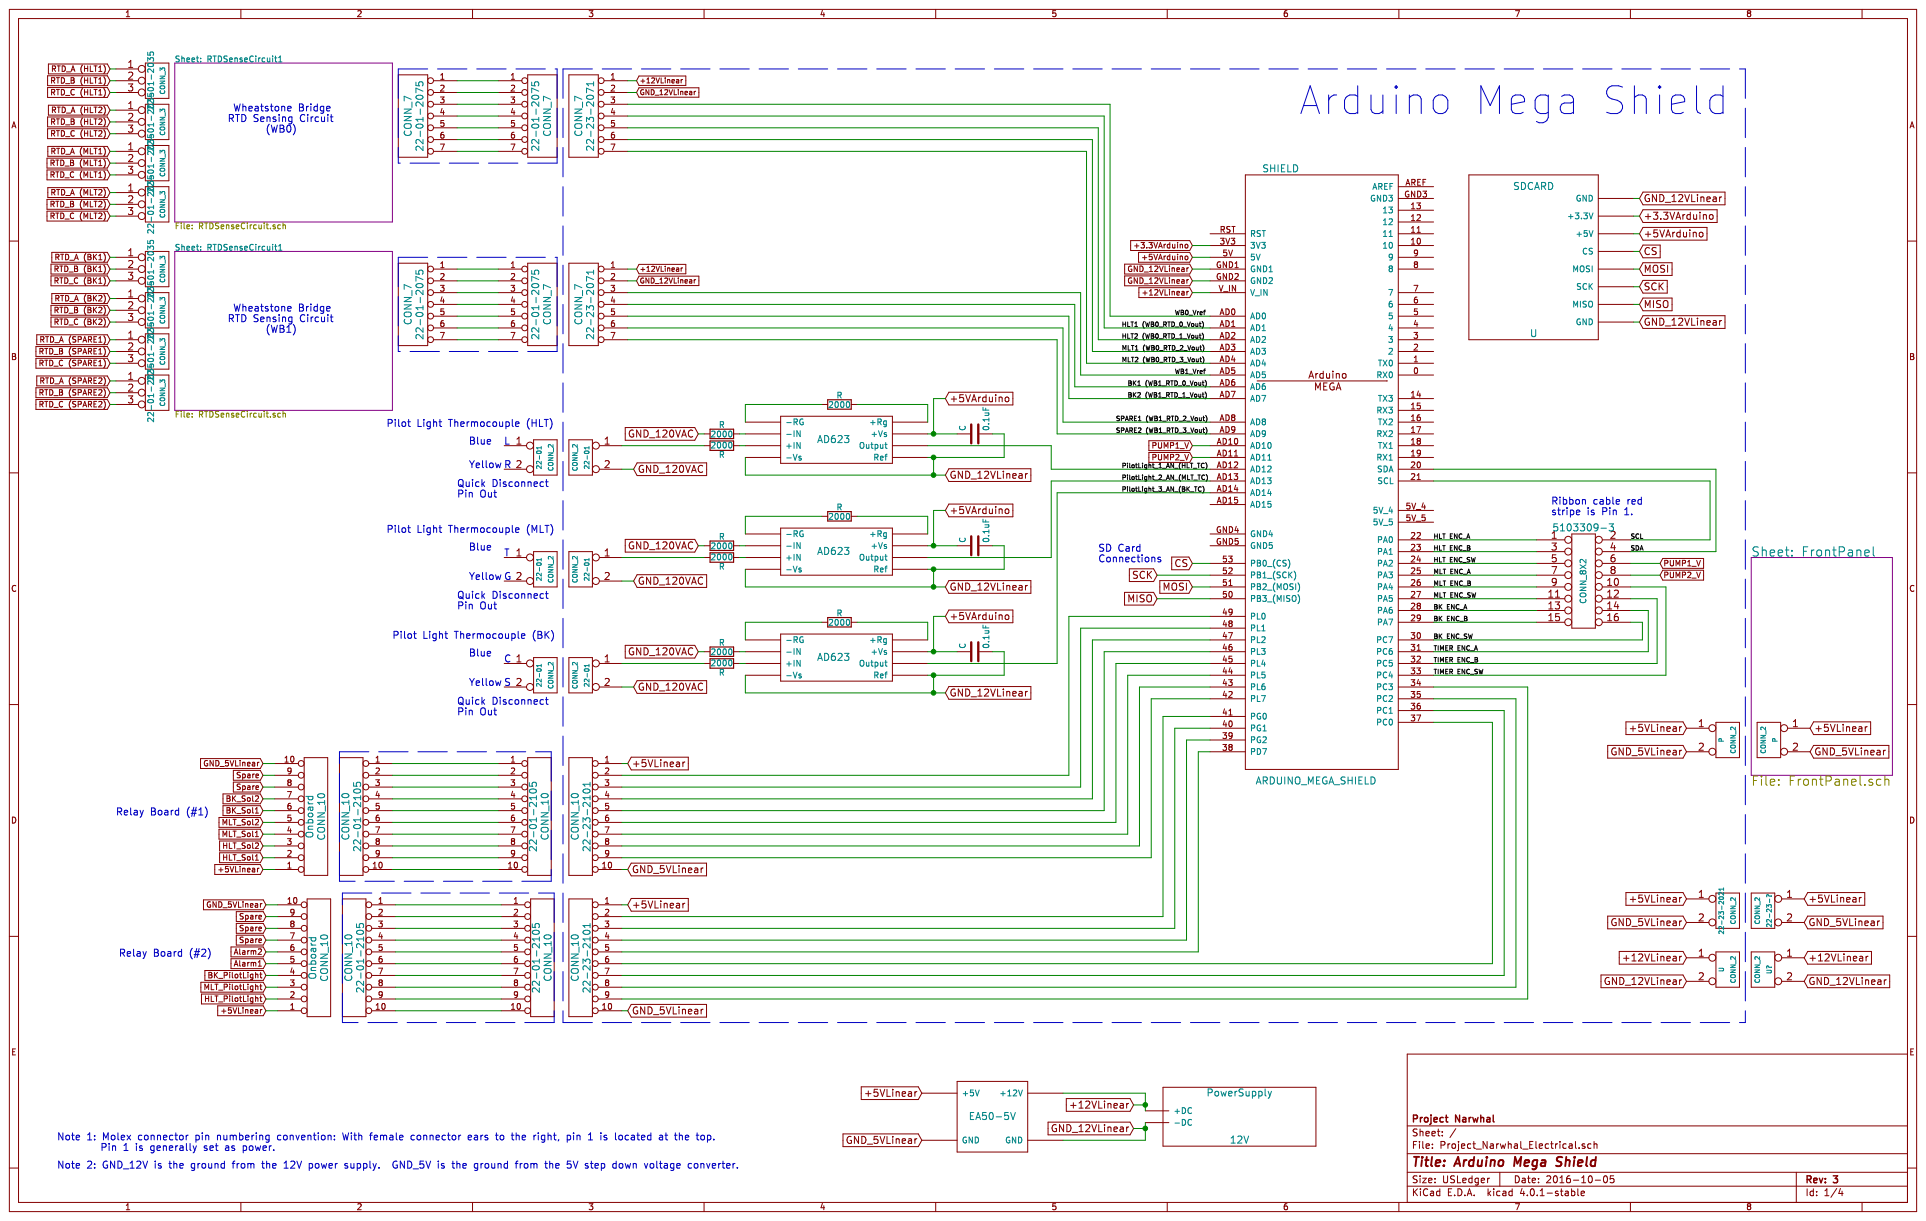
[picture p30: page 1]

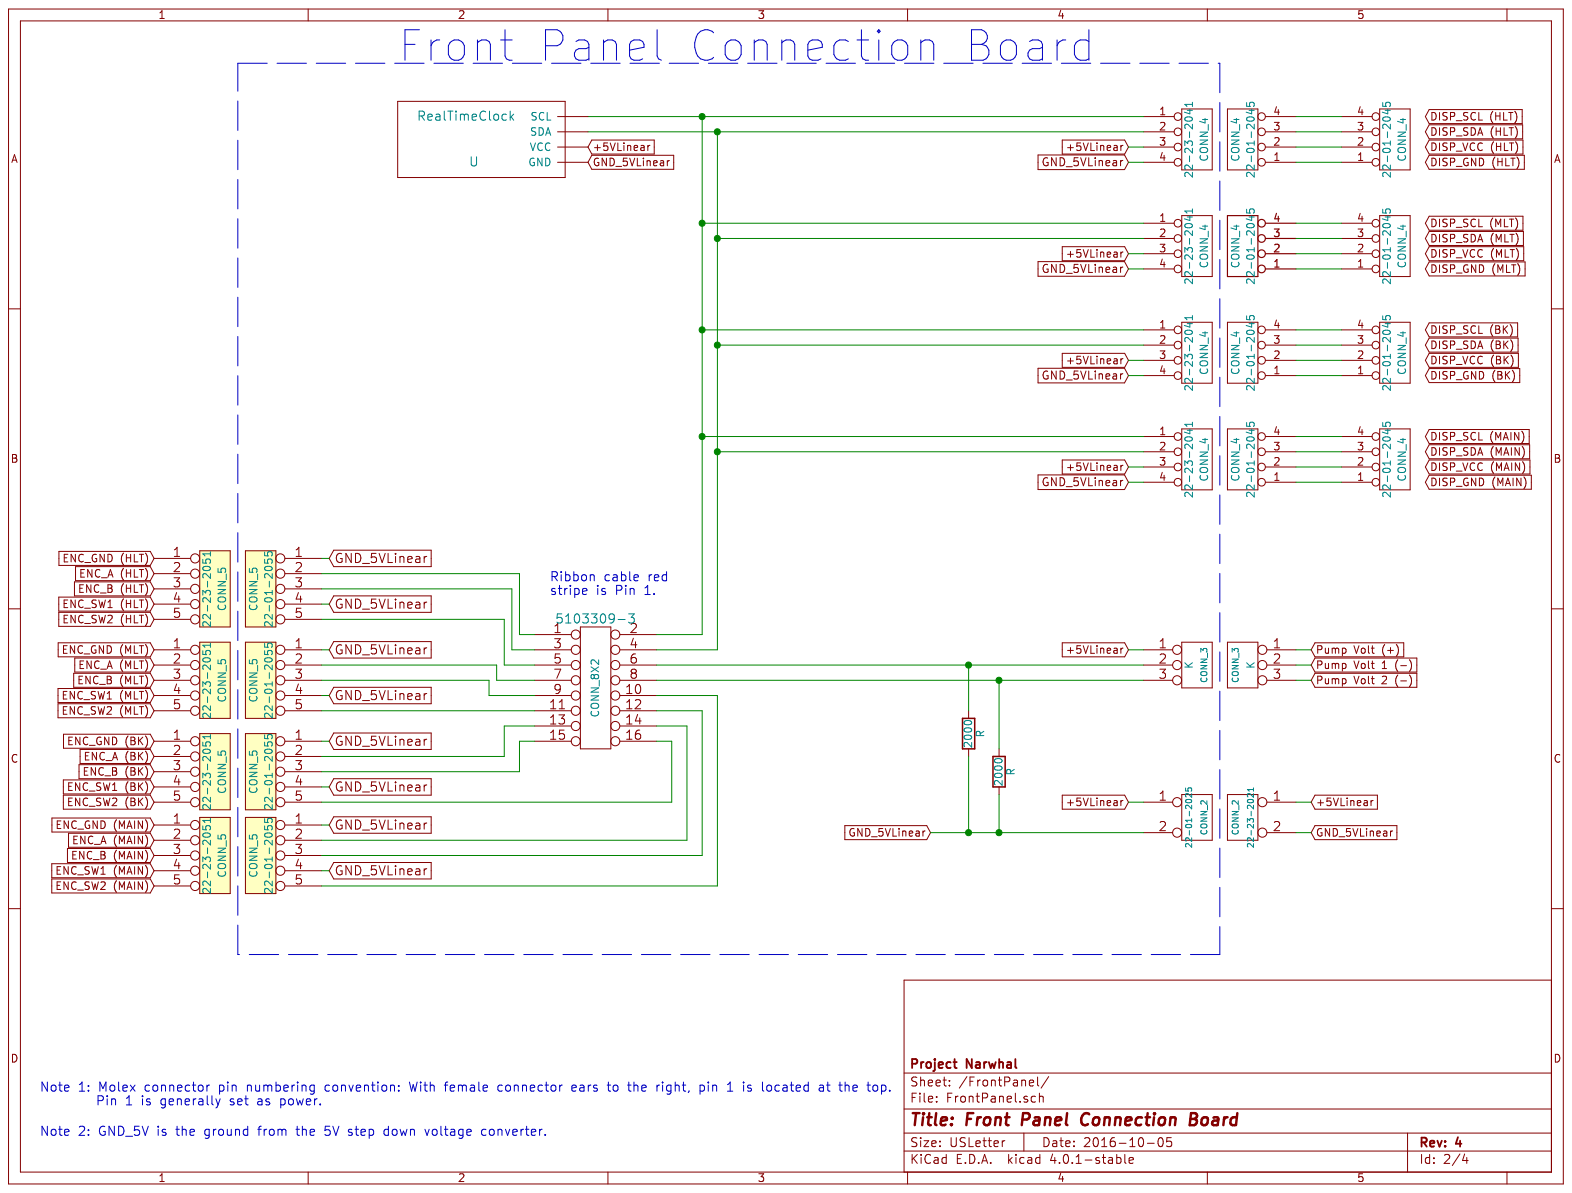
[picture p31: page 2]

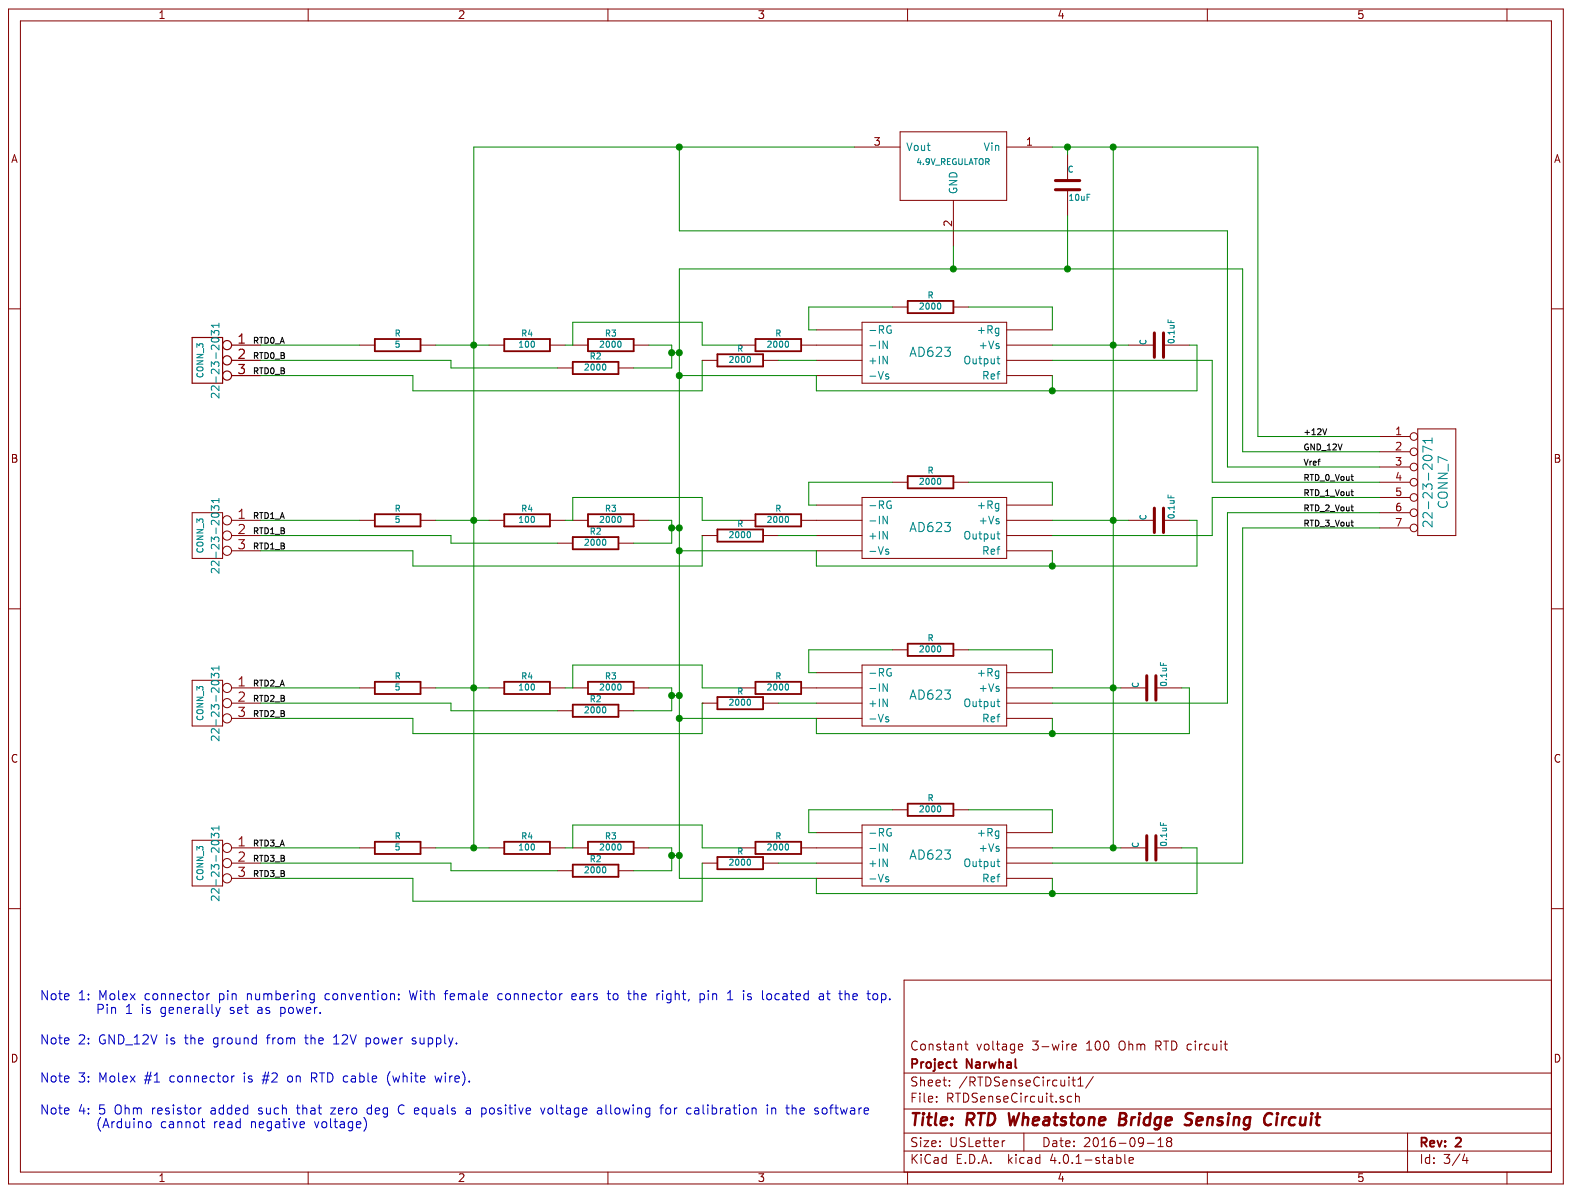
[picture p32: page 3]

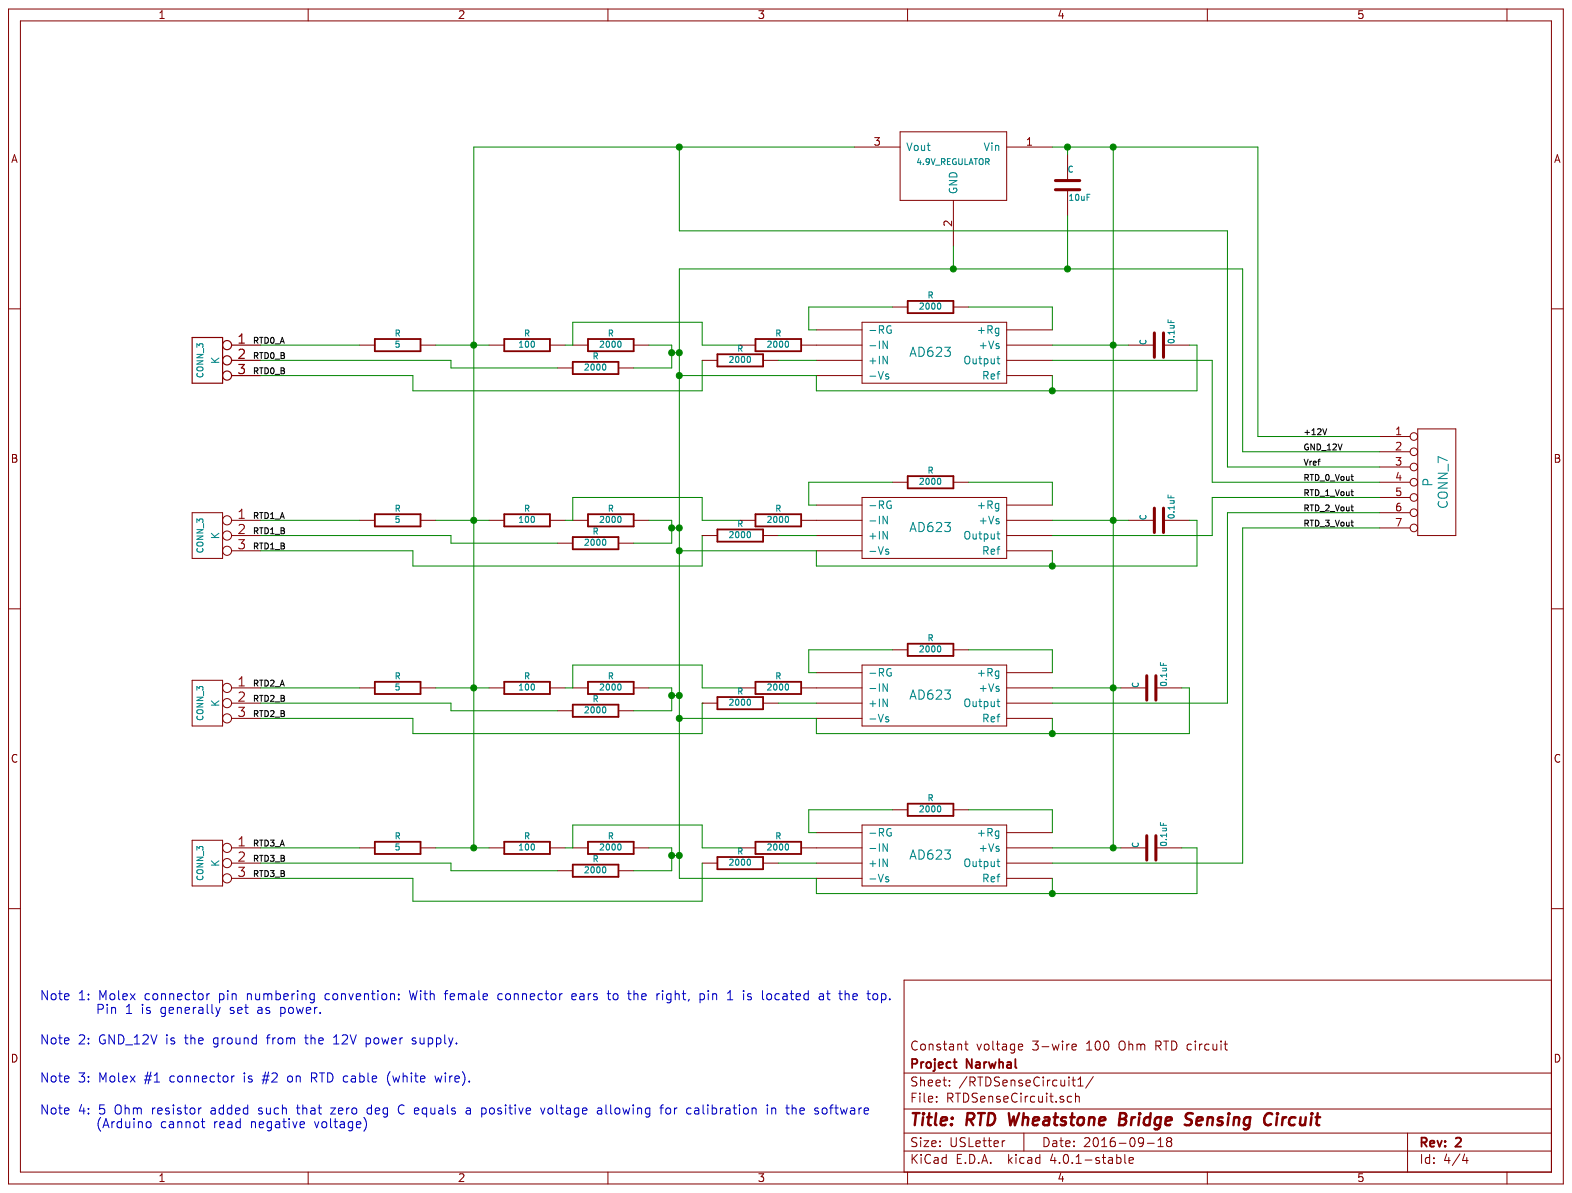
[picture p33: page 4]
