Nick1787/Narwhal-Arduino-Code/Electrical/Schematic/OLDACBoxWiring_Rev1.pdf

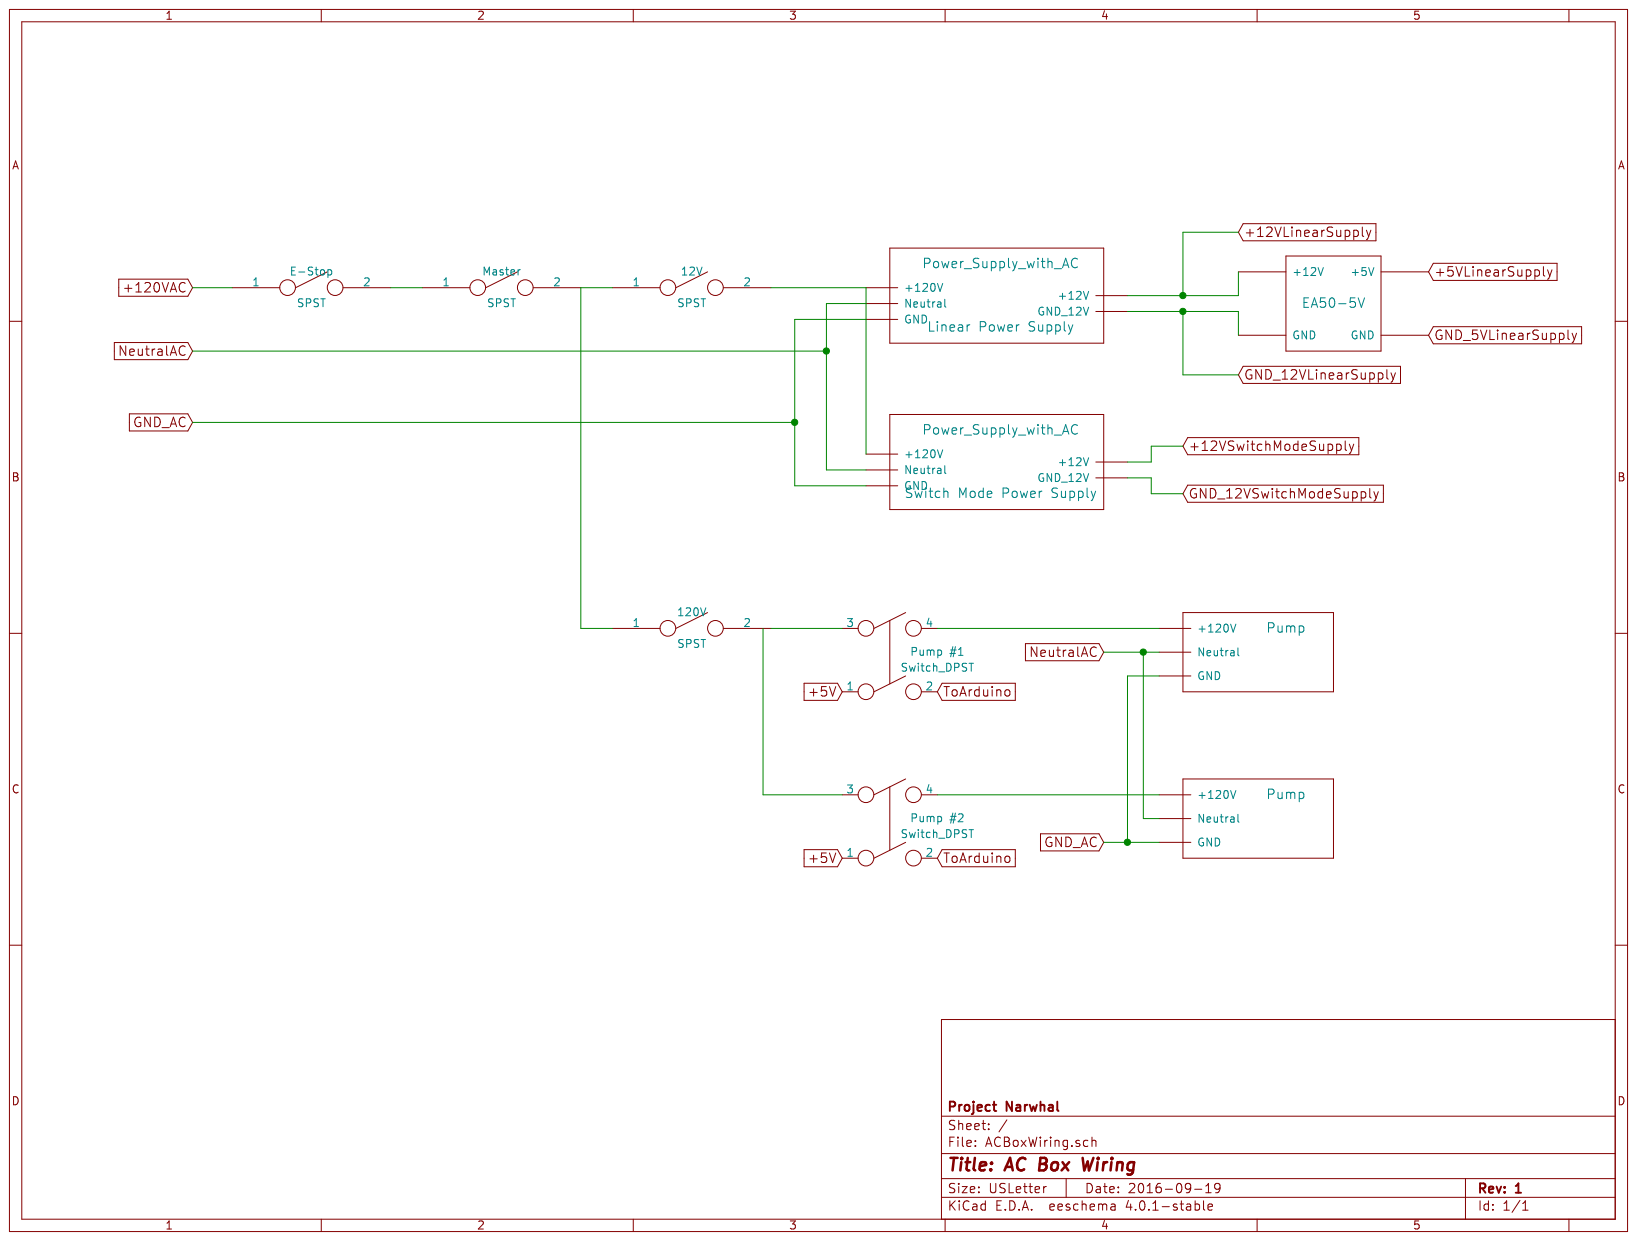
[picture p34: page 1]
