Nick1787/Narwhal-Arduino-Code/Electrical/Schematic/OLDNarwhalShield.pdf

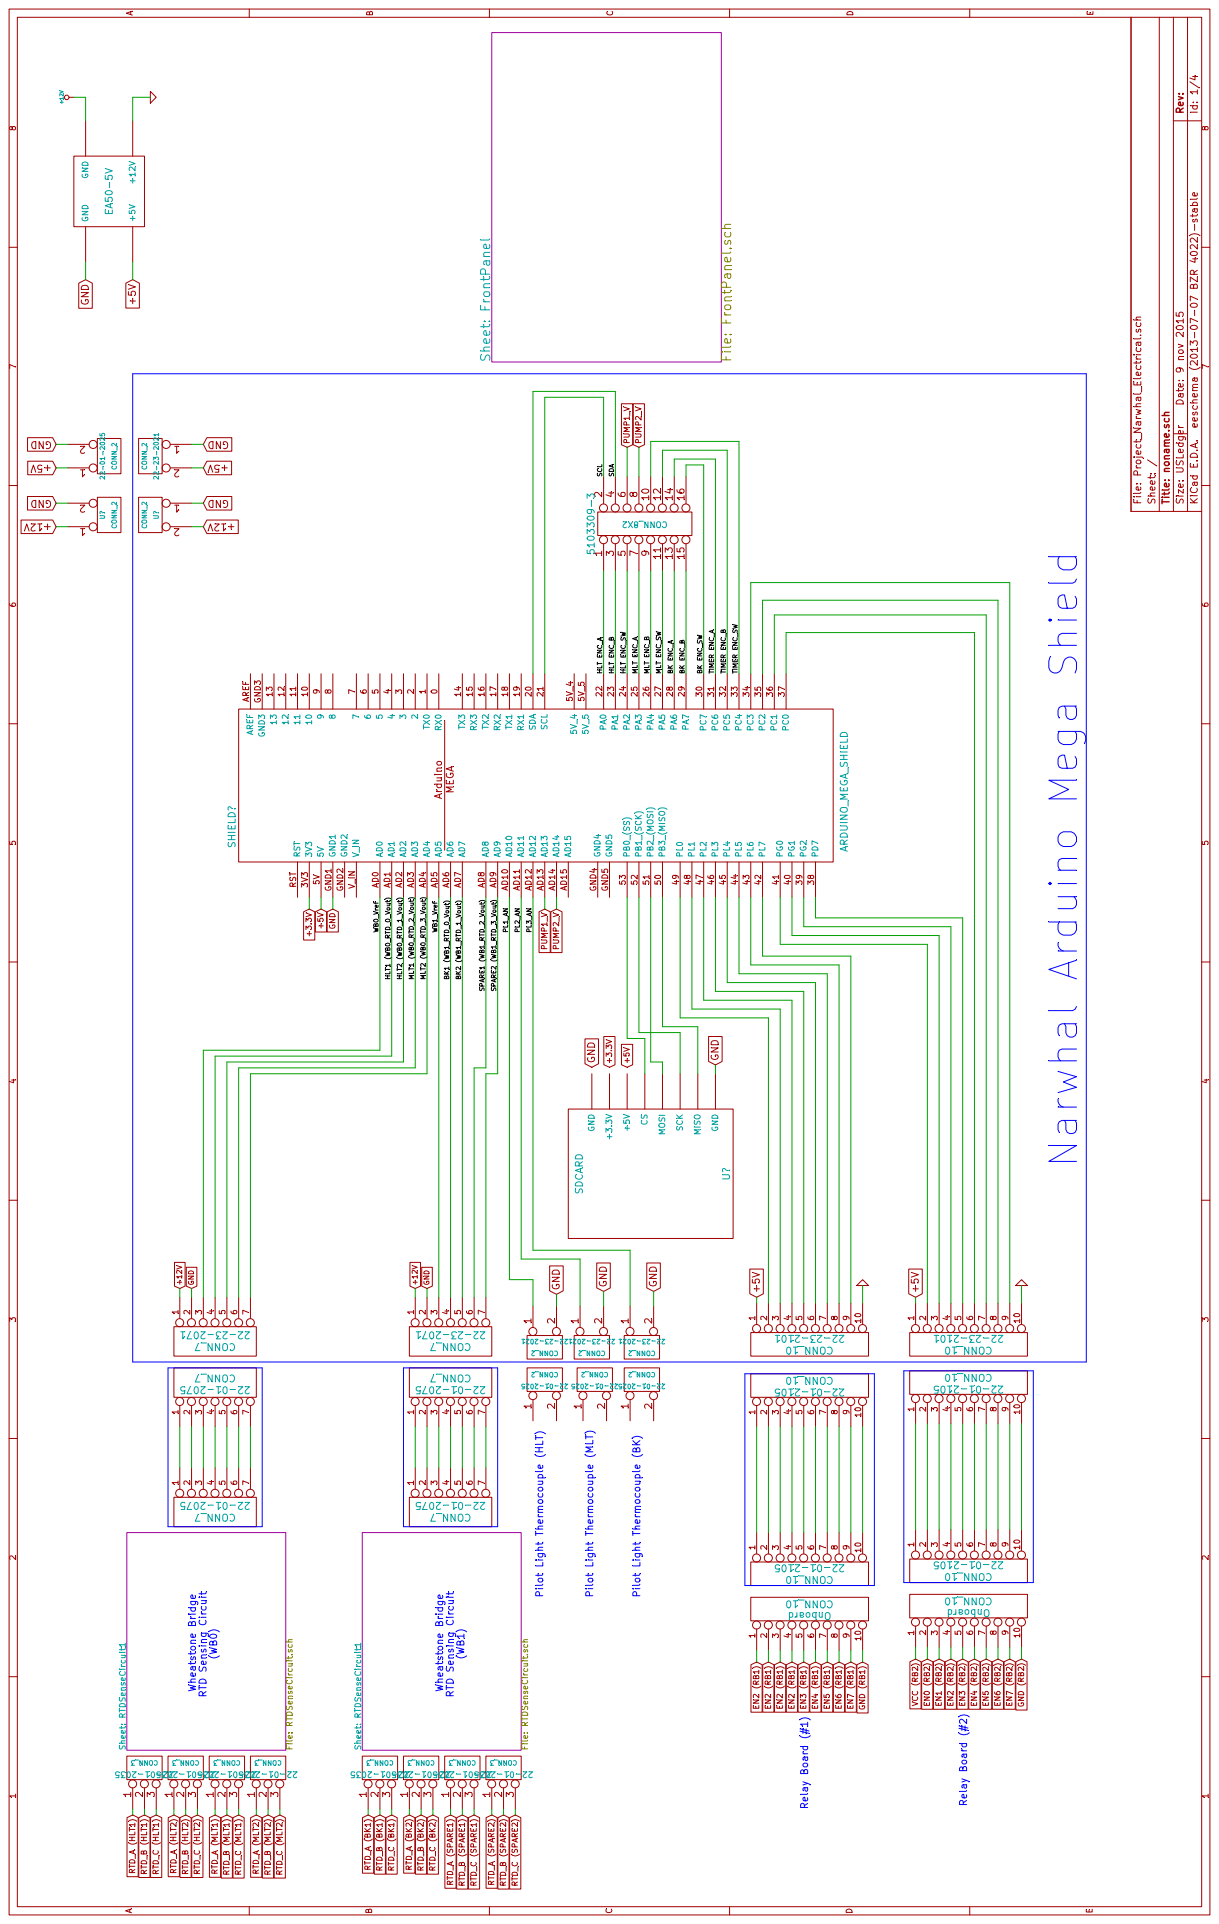
[picture p39: page 1]

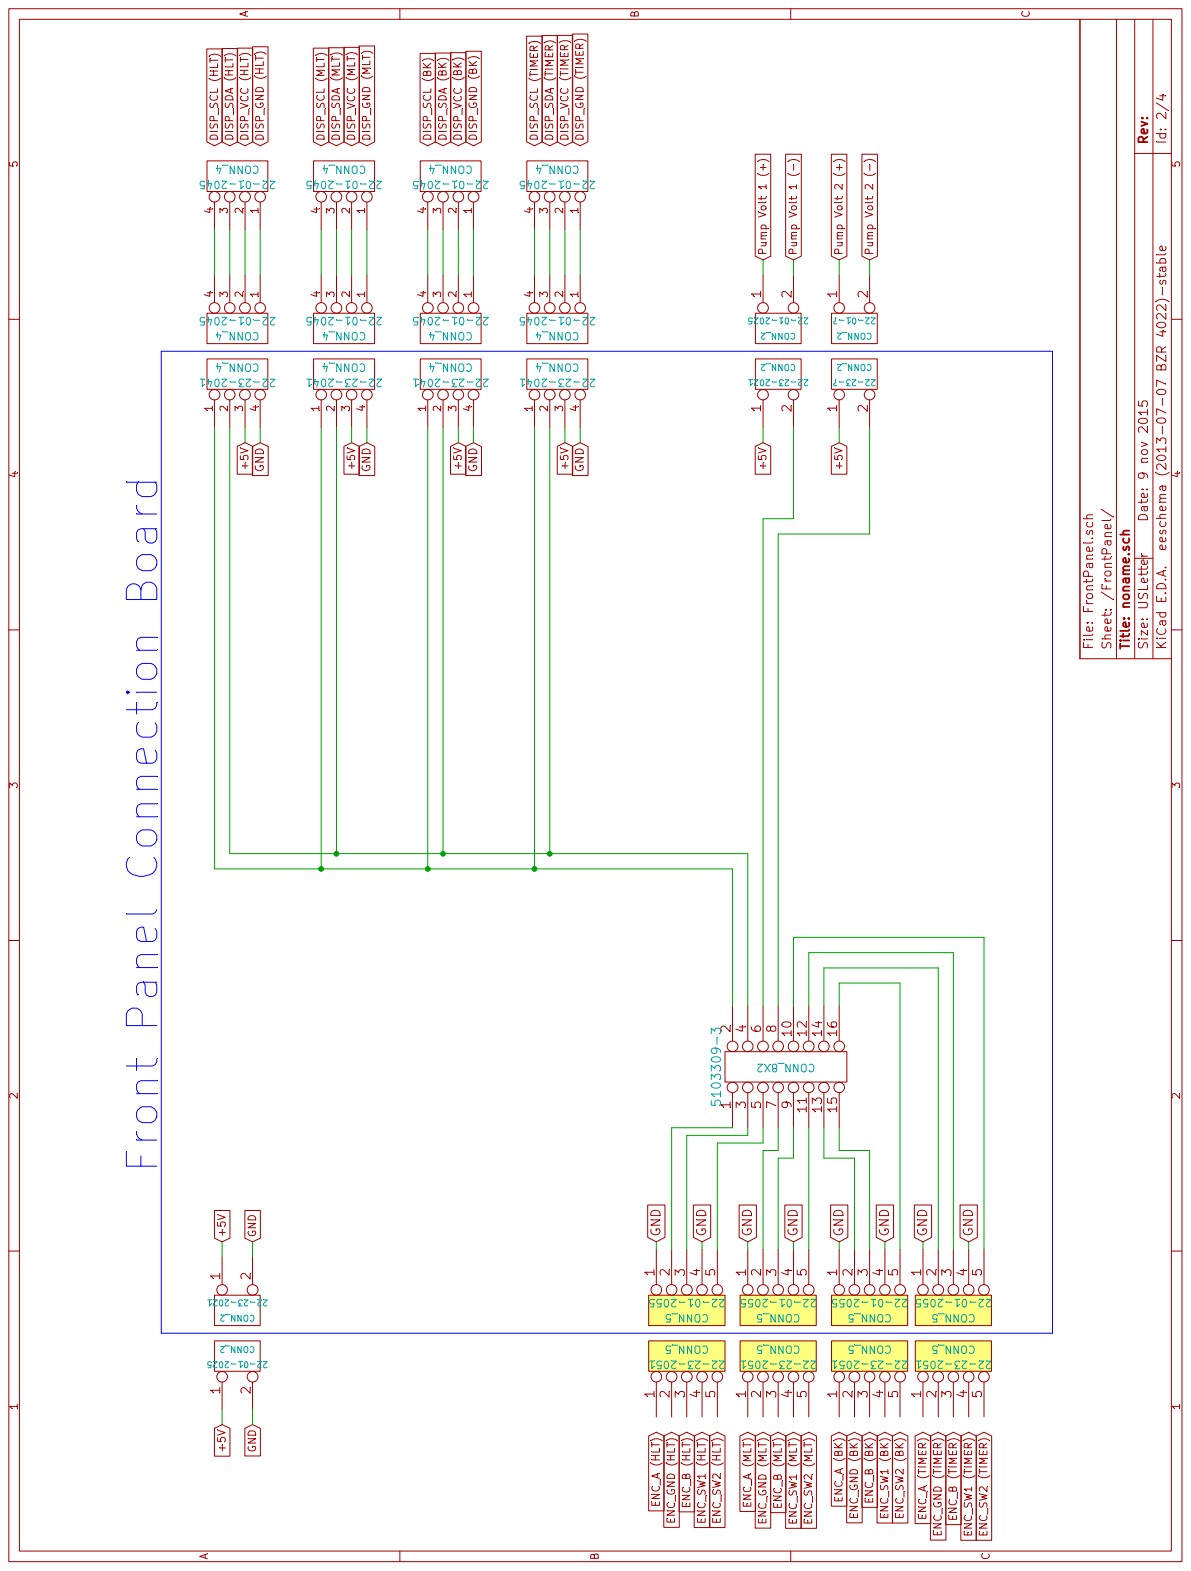
[picture p40: page 2]

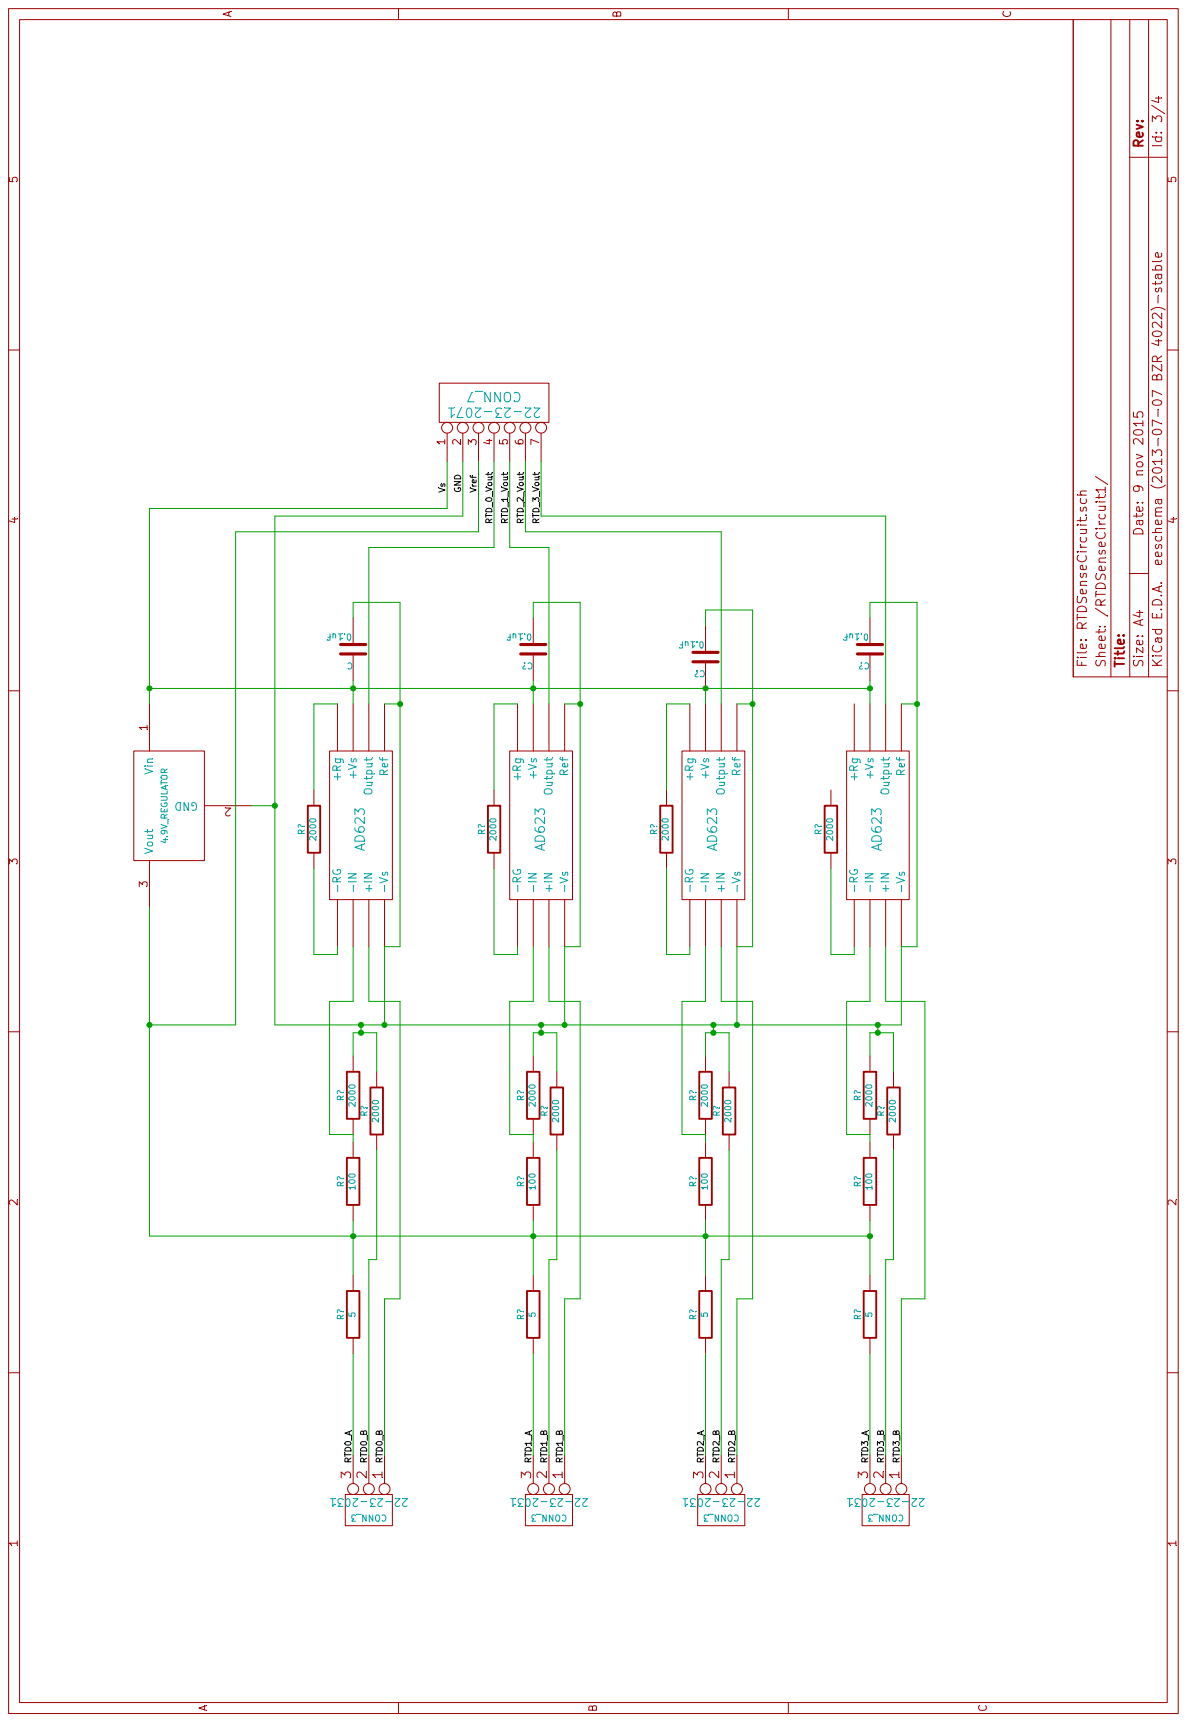
[picture p41: page 3]

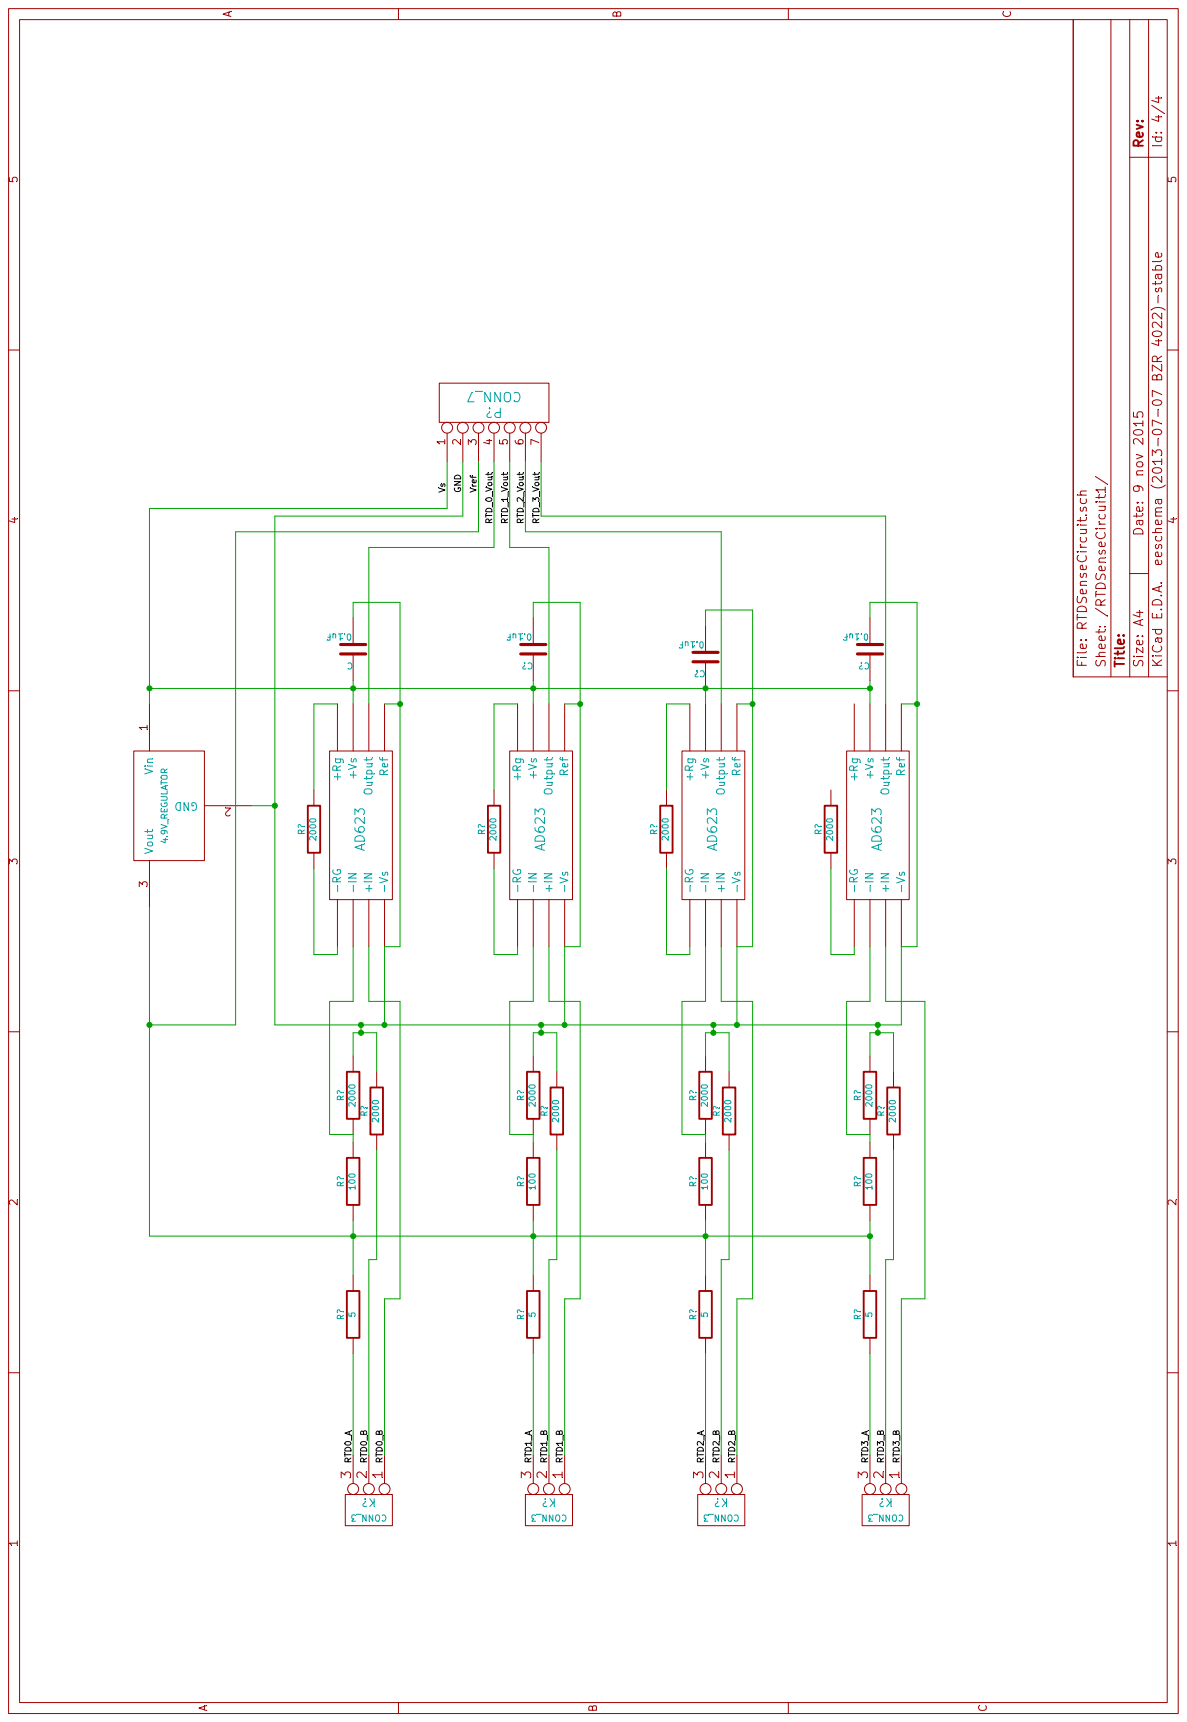
[picture p42: page 4]
