Nick1787/Narwhal-Arduino-Code/(list of files, drawings)

Other design files:
Electrical/Schematic/Fritzing/RTDSensingCircuit2.fzz
Electrical/Schematic/Fritzing/RTDSensingCircuit.fzz
