Nick1787/Narwhal-Arduino-Code/Electrical/Schematic/rescue-backup/ACBoxWiring-2020-06-09-15-40-12.sch

## KiCad design Electrical/Schematic/rescue-backup/ACBoxWiring-2020-06-09-15-40-12.sch (2018-12-01)

Schematic: ACBoxWiring-2020-06-09-15-40-12.sch

Parts:
12V, 120V: SPST
E-Stop: SPST
Linear: Power_Supply_with_AC
MOV: VR
Master: SPST
Pump: Switch_DPST
Switch: Power_Supply_with_AC

Notes on the sheet:
Arduino side of switch is normally closed (NC)
