Nick1787/Narwhal-Arduino-Code/Electrical/Schematic/rescue-backup/FrontPanel-2020-06-09-15-20-58.sch

## KiCad design Electrical/Schematic/rescue-backup/FrontPanel-2020-06-09-15-20-58.sch (2016-10-30)

Schematic: FrontPanel-2020-06-09-15-20-58.sch

Parts:
22-01-2025, 22-23-2021: CONN_2
22-01-2045, 22-23-2041: CONN_4
22-01-2055, 22-23-2051: CONN_5
5103309-3: CONN_8X2
K: CONN_3
R: 1800
U: RealTimeClock

Notes on the sheet:
Front Panel Connection Board
Note 1: Molex connector pin numbering convention: With female connector ears to the right, pin 1 is located at the top. Pin 1 is generally set as power.
Note 2: GND_5V is the ground from the 5V step down voltage converter.
Ribbon cable red stripe is Pin 1.
