Nick1787/Narwhal-Arduino-Code/Electrical/Schematic/rescue-backup/Project_Narwhal_Electrical-2020-06-09-15-20-58.sch

## KiCad design Electrical/Schematic/rescue-backup/Project_Narwhal_Electrical-2020-06-09-15-20-58.sch (2016-10-30)

Schematic: Project_Narwhal_Electrical-2020-06-09-15-20-58.sch

Parts:
12V: PowerSupply
22-01, 22-23-2021: CONN_2
22-01-2035: CONN_3
22-01-2075, 22-23-2071: CONN_7
22-01-2105, 22-23-2101: CONN_10
5103309-3: CONN_8X2
C: 0.1uF
Onboard: CONN_10
P: CONN_2
R: 2000
SHIELD: ARDUINO_MEGA_SHIELD
U: CONN_2

Notes on the sheet:
Pilot Light Thermocouple (HLT)
Pilot Light Thermocouple (MLT)
Pilot Light Thermocouple (BK)
Relay Board (#2)
Relay Board (#1)
Wheatstone Bridge RTD Sensing Circuit (WB0)
Wheatstone Bridge RTD Sensing Circuit (WB1)
Arduino Mega Shield
Note 1: Molex connector pin numbering convention: With female connector ears to the right, pin 1 is located at the top. Pin 1 is generally set as power.
Note 2: GND_12V is the ground from the 12V power supply. GND_5V is the ground from the 5V step down voltage converter.
Ribbon cable red stripe is Pin 1.
Blue
Yellow
Quick Disconnect Pin Out
SD Card Connections
