Nick1787/Narwhal-Arduino-Code/Electrical/Schematic/rescue-backup/RTDSenseCircuit-2020-06-09-15-20-58.sch

## KiCad design Electrical/Schematic/rescue-backup/RTDSenseCircuit-2020-06-09-15-20-58.sch (2016-11-05)

Schematic: RTDSenseCircuit-2020-06-09-15-20-58.sch

Parts:
22-23-2031: CONN_3
22-23-2071: CONN_7
C: 0.1uF
R: 100

Notes on the sheet:
Note 3: Molex #1 connector is #2 on RTD cable (white wire).
Note 4: 5 Ohm resistor added such that zero deg C equals a positive voltage allowing for calibration in the software (Arduino cannot read negative voltage)
Note 1: Molex connector pin numbering convention: With female connector ears to the right, pin 1 is located at the top. Pin 1 is generally set as power.
Note 2: GND_12V is the ground from the 12V power supply.
