Nick1787/Narwhal-Arduino-Code/ArduinoCode/ProjectNarhwal/classes/BurnerController.h

/*
 *        File: BuernerController.h
 *      Author: Nick Dodds <Nick1787@gmail.com>
 * Description: Project Narwhal Burner Controller
 * ----------------------------------------------------------------
 *    Revision:
 *		09152015 - NRD - Initial Version
 * ----------------------------------------------------------------
 */

#ifndef __BURNERCONTROLLER_H__
#define __BURNERCONTROLLER_H__

#include "../Main.h"


#ifndef PROGTEMPLATES
#define PROGTEMPLATES
template <typename T> void PROGMEM_readAnything (const T * sce, T& dest)
{
	memcpy_P (&dest, sce, sizeof (T));
}

template <typename T> T PROGMEM_getAnything (const T * sce)
{
	static T temp;
	memcpy_P (&temp, sce, sizeof (T));
	return temp;
}
#endif

class BurnerController
{
//variables
private:
	unsigned long PWMOnTime = -1;
	
public:	
	//Error Limits
	boolean enableFaultInhibit = false;
	boolean isFaulted = false;
	
	float ControlError = 0;
	float FeedbackTemp = 0;
	
	//PWMController - Adjustable Parameters for UI
	ListOption<EnumPWMLevels> PWMLevel;
	AdjustableParam * PWMPeriod;
	AdjustableParam * PWMDutyCycle;
	
	//AutoController - Adjustable Parameters
	AdjustableParam * SetTemp;
	AdjustableParam * HighOffset;
	AdjustableParam * MediumOffset;
	AdjustableParam * LowOffset;
	AdjustableParam * Hysteresis;
	
	//Feedback
	WheatstoneBridge * TProbe1;
	WheatstoneBridge * TProbe2;
	
	//Output
	DigitalIO *GasValve_Low;
	DigitalIO *GasValve_High;
	
	//Options
	int ControlMode = 0;
	ListOption<EnumBurnerModes> Mode;
	ListOption<EnumBurnerStatus> Status;
	ListOption<EnumFeedbackProbes> FeedbackProbe;
	
protected:
private:
	bool *PilotLitRef = NULL;
	void runClosedLoop();
	void runPWM();
	
//functions
public:
	//Constructor
	BurnerController(bool *PilotLit, WheatstoneBridge *BP, WheatstoneBridge *OP, DigitalIO *Sol1, DigitalIO *Sol2, AdjustableParam * SetT, AdjustableParam * HOffset, AdjustableParam * MOffset, AdjustableParam * LOffset, AdjustableParam *Hys, AdjustableParam * PwmP, AdjustableParam *PwmD): 
		PilotLitRef(PilotLit), TProbe1(BP), TProbe2(OP), GasValve_Low(Sol1), GasValve_High(Sol2),
		Mode(A(BurnerModes)), Status(A(BurnerStatus)), PWMLevel(A(PWMLevels)), FeedbackProbe(A(FeedbackProbes)), 
		SetTemp(SetT), HighOffset(HOffset), MediumOffset(MOffset), LowOffset(LOffset), Hysteresis(Hys) ,
		PWMPeriod(PwmP), PWMDutyCycle(PwmD)
	{
		Mode.setValue(EnumBurnerModes::Off);
		PWMLevel.setValue(EnumPWMLevels::PwmOff);
	} 
	
	//Destructor
	~BurnerController(){};
	
	//Exec
	void Exec();
protected:
private:

}; //BurnerController

#endif //__BURNERCONTROLLER_H__
