Nick1787/Narwhal-Arduino-Code/ArduinoCode/ProjectNarhwal/classes/EZUI/EZUI_Hardware_LCD_I2C.cpp

/*
 *         File: EZUI_Hardware_LCD_I2C.cpp
 *       Author: Nick Dodds <Nick1787@gmail.com>
 *  Description: EZUI Hardware LCD I2C 
 * Dependencies: https://bitbucket.org/fmalpartida/new-liquidcrystal/wiki/Home
 */
 
