Nick1787/Narwhal-Arduino-Code/ArduinoCode/ProjectNarhwal/classes/EZUI/EZUI_Hardware_LCD_I2C.h

/*
 *         File: EZUI_Hardware_LCD_I2C.h
 *       Author: Nick Dodds <Nick1787@gmail.com>
 *  Description: EZUI Hardware LCD I2C 
 * Dependencies: https://bitbucket.org/fmalpartida/new-liquidcrystal/wiki/Home
 */

#ifndef __EZUI_HARDWARE_CLICKENCODER_H__
#define __EZUI_HARDWARE_CLICKENCODER_H__

#include <EZUI.h>
#include <LiquidCrystalI2c.h>

//Forward Declaration
class EZUI;

class EZUI_LCD_I2C : public LiquidCrystal_I2C
{
	//variables
	public:
	protected:
	private:

	//functions
	public:	
	protected:
	private:

}; //ClickEncoderWithEvents

#endif //__EZUI_HARDWARE_CLICKENCODER_H__
