Nick1787/Narwhal-Arduino-Code/(commit log)

2015-08-31 Requirements
    Initial requirements for software
    [MenusPseudoCode.xlsx, Panel.xlsx, Process.xlsx]
2015-08-31 Requirements update
    Test to update spreadsheet
    [MenusPseudoCode.xlsx]
2015-09-03 Update 9/2/15
    Requirements update
    [MenusPseudoCode.xlsx]
2015-09-18 Initial Code Structure + Electrical Schematic
    Code developed using MariaMole arduino ide (http://dalpix.com/mariamole)
    Schematic created in KiCad (http://kicad-pcb.org/)
    [FrontPanel.sch, Narwhal_FrontPanel_ConnectionBoard.sch, Narwhal_Mega_Shield.sch, Project_Narwhal_Electrical.sch, RTDSenseCircuit.sch, file55E39837.sch]
2015-10-13 Final V1.0 Electrical Schematic and Parts List
    Final version of electrical schematic and parts lists
    [Electrical Parts List.xlsx, FrontPanel.sch, GenericWheatstoneBridge.sch, Project_Narwhal_Electrical.sch, RTDSenseCircuit.sch]
2015-10-16 Requirements Update
    Requirements Update
    [MenusPseudoCode.xlsx]
2015-10-28 First fire up menus
    Added first fire up menus
    [FirstFireMenusPseudoCode.xlsx]
2015-11-09 Updated Schematic and Lots of New code
    [FrontPanel.sch, Narwhal_FrontPanel_ConnectionBoard.sch, Narwhal_Mega_Shield.sch, Project_Narwhal_Electrical.sch, RTDSenseCircuit.sch, file55E39837.sch]
2015-11-10 Requirements & Parts List Update
    Updated requirements for SW debug mode
    Updated Electrical Parts List - 12" ribbon to 18" ribbon
    [Electrical Parts List.xlsx, FirstFireMenusPseudoCode.xlsx, MenusPseudoCode.xlsx]
2016-01-05 Updated Arduino Code
    Working Menu's with toggle options. LCDPage code written but not
    working properly.
2016-02-16 Code Cleanup - New Class AnalogIn
    Cleaned up code to use less SRAM. Used generic pointers in page +
    menus. Added new class AnalogIn which provides a filtered analog value
    capability.
2016-09-10 Lots of Cleanup + new Features
    New Features:
    AdjustableParam Code
    ListOptionWorking
    Controller Code
    Added a UI_Shared code to create common UI elements to save memory.
    Cleanup:
    UI cleanup to ensure all controls use same basic function close
    PROGMEM usage to save on SRAM
    Fixes for RelayBoard Initialization
    [AdjustableParam.h, AdvancedSerial.cpp, BurnerController.h, DigitalIO.h, EZUI.cpp, EZUI.h, EZUI_Control.h, EZUI_Control_Button.h]
2016-09-18 Updates to Circuit Drawings
    Update of circuit drawings and supporting files. There will be at least
    one more revision for final cleanup.
    [FrontPanel.sch, GenericWheatstoneBridge.sch, Project_Narwhal_Electrical.sch, RTDSenseCircuit.sch]
2016-09-20 Created AC circuit diagram
    Updated files for AC circuit
    [ACBoxWiring.sch]
2016-10-02 Documentation of wiring harness hookups
    Documentation of wiring harness hookups
2016-10-06 Updated electrical drawings
    Update to Arduino library
    Updates power/grounds
    Added pull down resistors to front panel
    Added diff amp to main board
    More clean up...
    [ACBoxWiring.sch, FrontPanel.sch, Project_Narwhal_Electrical.sch, RTDSenseCircuit.sch]
2016-10-27 Initial Version of List Editor. Broke out UI code into .H and .CPP to avoid circular includes
    [EZUI.cpp, EZUI.h, EZUI_Control.cpp, EZUI_Control.h, EZUI_Control_AdjustParam.h, EZUI_Control_Button.h, EZUI_Control_Label.cpp]
2016-10-30 Updated schematics and documentation
    Updated schematics and documentation
    [ACBoxWiring.sch, FrontPanel.sch, Project_Narwhal_Electrical.sch, RTDSenseCircuit.sch]
2016-11-05 Final Electrical Schematic Updates
    Final Electrical Schematic Updates
    [RTDSenseCircuit.sch]
2017-02-06 Menu Fix - Architecture Changes - SD + RTC Code
    Changed file structure to use standalone EZUI library structure. Fixed
    Menus. Started code for SD card data logging and RTC
    [RTDSensingCircuit.fzz, RTDSensingCircuit2.fzz]
2017-08-07 Large Revisions
    Timer Code, Logger Re-write, Fixed random characters, All Controllers
    Working, Basic fault detection and sounding.
    [AdjustableParam.h, ArduinoFiles.h, ArduinoStream.h, BurnerController.cpp, BurnerController.h, DS323RealTimeClock.h]
2017-10-22 Fixed bug where menu value characters linger when values changed. Fixed bug where "Log" link flickers on main monitor page.
    [EZUI_UI.cpp, UI_MAIN.cpp]
2017-10-22 V1.0 - RTC year bug fix, logger implemented, Bugfixes
    [BurnerController.cpp, BurnerController.h, DS323RealTimeClock.h, DataLogger.h, EZUI_Control_Label.cpp, EZUI_UI.cpp, Executive.cpp, Executive.h]
2018-03-29 Made LUT use PROGMEM to address memory issues when using SD library
    SD library requires atleast 700ish bytes of memory for buffer. We were
    right on the cusp of having enough memory. Transitioned LUT algorithm
    to use PROGMEM to get some more margin. Also using 14pt table.
    [Hardware.cpp, LUT.h, config.h]
2018-05-03 MOV addition to circuit
    MOV added to circuit to suppress voltage spikes caused by switching off
    the inductive load of the pumps.
    [Electrical Parts List.xlsx]
2018-12-01 Pump monitoring switch update
    Replaced pump monitoring switchs from normally open to normally closed.
    Switched logic for pump on/off due to hardware change.
    [Executive.cpp, ListsAndAdjustments.cpp, config.h]
2018-12-01 Wiring diagram update for new pump monitor switch
    Wiring diagram update for new pump monitor switch
    [ACBoxWiring.sch]
2019-08-24 Update to data logging
    v1.04 updated 8/24/2019
    1) Added flush() call to writeLog() in order to save data to card and
    prevent data loss during a reset
    2) Added version date to boot screen
    [DataLogger.h, Main.cpp, config.h]
2020-06-09 Update from KiCad 4.0.1 to 5.1.5
    KiCad library remapping
    [ACBoxWiring-2020-06-09-15-40-12.sch, FrontPanel-2020-06-09-15-20-58.sch, Project_Narwhal_Electrical-2020-06-09-15-20-58.sch, RTDSenseCircuit-2020-06-09-15-20-58.sch]
