Nick1787/Narwhal-Arduino-Code/(notices)

Notices in the files:
ArduinoCode/ProjectNarhwal/include/standard/SdFat/FatLib/FatFileLFN.cpp:
This Library is free software: you can redistribute it and/or modify
it under the terms of the GNU General Public License as published by
the Free Software Foundation, either version 3 of the License, or
(at your option) any later version.
ArduinoCode/ProjectNarhwal/include/TimerOne/TimerOne.h:
This is free software. You can redistribute it and/or modify it under
the terms of Creative Commons Attribution 3.0 United States License.
To view a copy of this license, visit http://creativecommons.org/licenses/by/3.0/us
or send a letter to Creative Commons, 171 Second Street, Suite 300, San Francisco, California, 94105, USA.
